Eryk-Mozdzen/uav-tvc-goose/docs/reports/SteRoP_3_TVCG_EM_2.pdf

Projekt

Sterowniki robotów

# I kamień milowy

# Sterownik lotu drona sterowanego wektorem ciągu „Goose”

# TVCG

## Skład grupy:

### Eryk Możdżeń, 259375

### Termin: wtTN19

### Prowadzący: dr inż. Wojciech Domski

### 27 marca 2023

## Spis treści

1 Zakres wykonanych prac | 2
2 Protokół komunikacyjny | 3
3 Komunikacja bezprzewodowa | 6
4 Komunikacja przewodowa | 8

## 1 Zakres wykonanych prac

Wszelkie prace prowadzone i dokumentowane były na repozytorium github[2].

- implementacja protokołu oraz funkcji kodujących i dekodujących
- definicja danych wysyłanych w wiadomościach
- integracja protokołu kominikacji do wcześniej istenijacej architektury
- konfiguracja UART z użyciem DMA
- stworzenie tasków odbierających i nadawających po UART
- implementacja biblioteki USB oraz tasków ją obsługujące

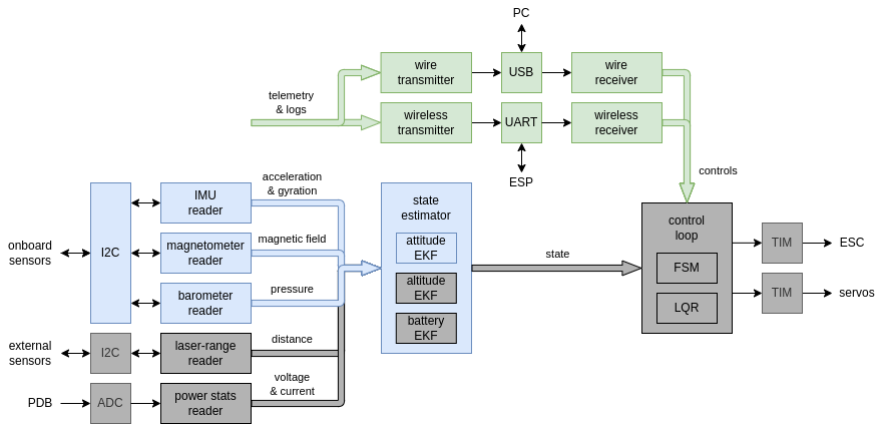
[picture p6: figure]

Rysunek 1: Schemat architektury programu, niebieski – wykonany przed oddaniem I etapu, zielony – elementy komunikacji wykonane w ramach I kamienia milowego, szary – planowane na następne kamienie milowe

## 2 Protokół komunikacyjny

Został zaimplementowany protokół komunikacyjny opisany w etapie I. Wykorzystuje on algorytmy takie jak COBS [3] oraz sumę konkrolną CRC8[4]. Niżej wypisano wszystkie ramki wiadomości, które będą używane do transmisji danych wraz z przydzielonym im identyfikatorami. Kod źródłowy klasy Transfer dzielony jest w programie mikrokontrolera oraz stacji pilota na komupterze PC.

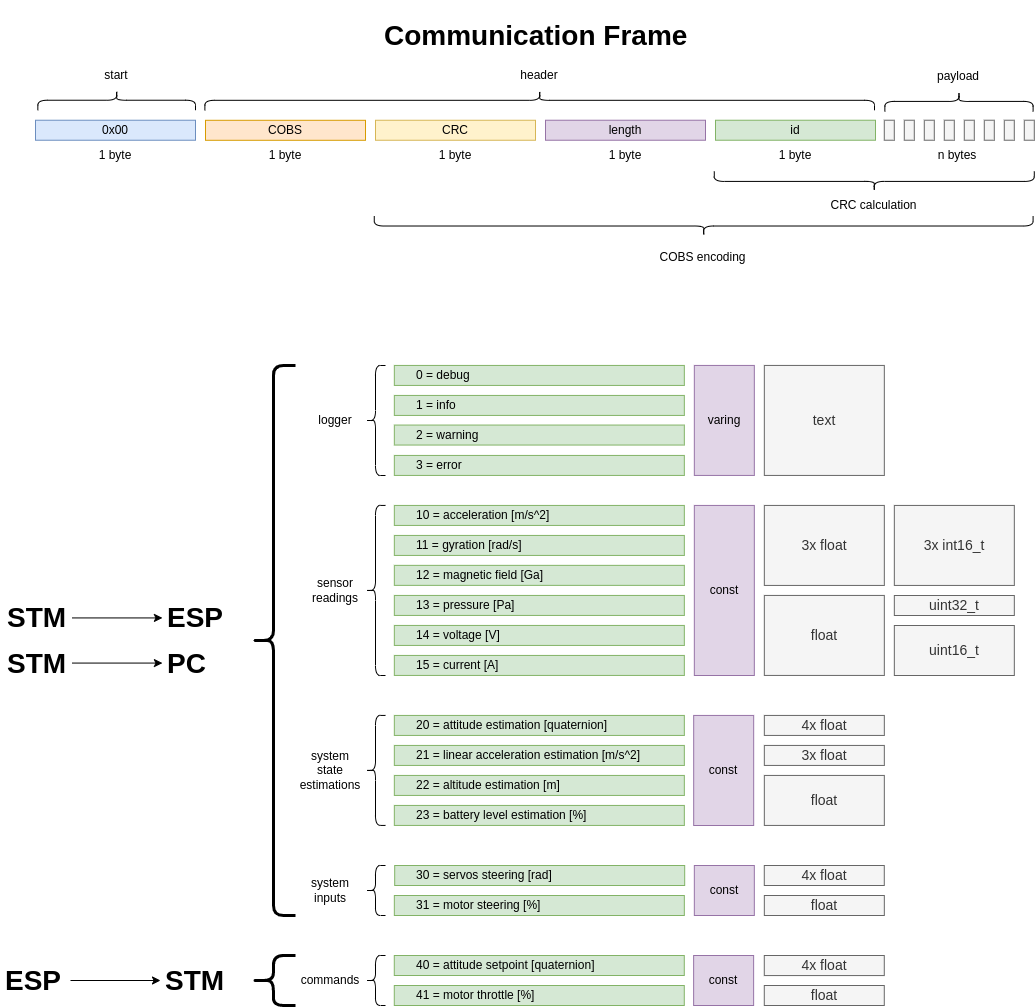
[picture p7: figure]

Rysunek 2: Ramka danych oraz definicje wiadomości wraz z identyfikatorami

### Kodowanie wiadomości

W pierwszej kolejności sprawdzany jest rozmiar wysyłanych danych. Zastosowano uproszczoną metodę kodowania COBS, która zawiera tylko jeden bit nadmiarowy. Ogranicza to długość jednej wiadomości do 255 bajtów, co odejmując narzut związany z obecnością nagłówka pozostawia 250 bajtów danych na treść wiadomości.
Po przekopiowaniu danych do bufora oraz uzupełnieniu pól identyfikatora oraz długości ładunku następuję obliczenie sumy kontrolnej na danych jak i id. Następnie suma kontrolna, długość, id oraz dane kodowane są przez COBS w celu usnięcia bajtów o wartości 0 z wiadomości. Na początku wpisywane jest 0.
1 | template<typename T>
2 | s t a t i c FrameTX encode ( co n s t T &payload , co n s t ID i d ) {
3 | s t a t i c _ a s s e r t ( s i z e o f (T)<=max_length , " payload too big to encode " ) ;
4
5 | FrameTX frame ;
6
7 | memcpy(& frame . b u f f e r [ 5 ] , &payload , s i z e o f (T) ) ;
8 | frame . b u f f e r [ 4 ] = i d ;
9 | frame . b u f f e r [ 3 ] = s i z e o f (T) ;
10 | frame . b u f f e r [ 2 ] = calculate_CRC(& frame . b u f f e r [ 4 ] , 1 + s i z e o f (T) ) ;
11 | frame . b u f f e r [ 1 ] = encode_COBS(& frame . b u f f e r [ 2 ] , 3 + s i z e o f (T) ) ;
12 | frame . b u f f e r [ 0 ] = s ta r t_ b y t e ;
13
14 | frame . l e n g t h = s i z e o f (T) + 5 ;
15
16 | r e t u r n frame ;
17 | }
| Listing 1: statyczna metoda kodująca w klasie Transfer

### Dekodowanie wiadomości

| W celu zdekodowania strumienia bajtów dochodzących do drona/wizalizacji wymagany jest
| obiekt klasy Transfer. Jej zadaniem jest akumulowanie kolejnych bajtów danych metodą con-
| sume() do czasu aż niezostanie zebrana pełna poprawna ramka danych.
1 | void T ra n s f e r : : consume ( co n s t uint8_t byte ) {
2 | i f ( co u n t e r==0 && byte != s ta r t_ b y t e ) {
3 | r e t u r n ;
4 | }
5
6 | i f ( coun te r >0 && byte==s ta r t_ b y t e ) {
7 | r e s e t ( ) ;
8 | }
9
10 | i f ( coun te r>=max_length+5) {
11 | r e s e t ( ) ;
12 | }
13
14 | f rame_bu f fe r [ co u n t e r ] = byte ;
15 | co u n t e r++;
16 | }
| Listing 2: metoda akumulująca klasy Transfer

Aby sprawdzić czy już zostały otrzymane wszystkie bajty tworzące ramkę należy wywołać metodę receive(). Sprawdza ona czy obecnie zakumulowane dane, które spełniają sumę kontrolną oraz oczekiwaną ilość danych.
Początkowo sprawdzane są warunki tego, że pierwszym bajtem jest bajt startu, oraz że oprócz nagłówka zostały odebrane jakiekolwiek dane. Następnie przekopiowanie danych i odwrócenie kolejności ich odkodowywania względem ich zakodowywania.
1 | bool T ra n s f e r : : r e c e i v e (FrameRX &frame ) co n s t {
2 | i f ( coun te r <5) {
3 | r e t u r n f a l s e ;
4 | }
5
6 | i f ( f rame_bu f fe r [ 0 ] ! = s ta r t_ b y t e ) {
7 | r e t u r n f a l s e ;
8 | }
9
10 | uint8_t copy [ max_length + 5 ] ;
11 | memcpy ( copy , f rame_bu f fe r , co u n t e r ) ;
12
13 co n s t uint8_t cob s = copy [ 1 ] ;
14
15 decode_COBS(&copy [ 2 ] , co u n t e r − 2 , cob s ) ; 16
17 | frame . l e n g t h = copy [ 3 ] ;
18 | co n s t si z e_ t l e ng t h_ r eal = co u n t e r − 5 ;
19
20 | i f ( frame . l e n g t h != l e ng t h_ r eal ) {
21 | r e t u r n f a l s e ;
22 | }
23
24 | co n s t uint8_t c r c = copy [ 2 ] ;
25 | co n s t uint8_t c r c_ r e al = calculate_CRC(&copy [ 4 ] , frame . l e n g t h + 1 ) ;
26
27 | i f ( c r c != c r c_ r e al ) {
28 | r e t u r n f a l s e ;
29 | }
30
31 frame . i d = s t a ti c _ c a s t <ID>(copy [ 4 ] ) ;
32
33 memcpy ( frame . payload , &copy [ 5 ] , frame . l e n g t h ) ; 34
35 | r e t u r n t r u e ;
36 | }
| Listing 3: metoda sprawdzająca klasy Transfer

## 3 Komunikacja bezprzewodowa

Główną drogą komunikacji docelowo będzie bezprzewodowa wymiana danych. W tym celu został użyty projekt BlackMagic–ESPIDF [1], z którego na potrzeby tego projektu wykorzystana będzie komunikacja po usłudze Telnet. Tak zaprogramowany mikrokontroler ESP8288 automatycznie łączy się na stałe zadaną siecią, i stanowi rolę pośrednika w wymianie Telnet – UART.
Do transmisji jak i odbioru danych używane jest DMA. Konfiguracja UART jest zgodna z opisaną w założeniach projektowych. Metody zostały napisane tak, aby task je wywołujacy przeszedłw tryb uśpienia podczas oczekiwania na zakończenie transmisji lub odczytu danych z użyciem notyfikacji z FreeRTOS. Całość kodu obsługująca UART została zamknięta w singletonie CommunicationBus, która została odpowiednio zabezpieczona przed dostępem z wielu tasków. Wielkość bufora została arbitralnie dobrana. Im większy zostanie dobrany bufor tym bardziej odciążany jest proceor, lecz tym żadziej reaguje na dane.
1 | void CommunicationBus : : w ri t e ( co n s t uint8_t ∗ s r c , co n s t uint32_t l e n ) {
2 | lock_tx . ta ke (portMAX_DELAY) ;
3
4 com_bus_task_tx = xTaskGetCurrentTaskHandle ( ) ;
5
6 HAL_UART_Transmit_DMA(&huart1 , s r c , l e n ) ;
7
8 | i f ( ! ulTa skNo ti fyTake Indexed ( 2 , pdTRUE, 100 ) ) {
9 | Logger : : g e t I n s t a n c e ( ) . l o g ( Logger : :ERROR, " cbus : tx timeou t " ) ;
10 | }
11
12 | lock_tx . gi v e ( ) ;
13 | }
14
15 | void CommunicationBus : : read ( uint8_t ∗ de s t , co n s t uint32_t l e n ) {
16 | lock_rx . ta ke (portMAX_DELAY) ;
17
18 com_bus_task_rx = xTaskGetCurrentTaskHandle ( ) ;
19
20 HAL_UART_Receive_DMA(&huart1 , de s t , l e n ) ;
21
22 ulTa skNo ti fyTake Indexed ( 3 , pdTRUE, portMAX_DELAY) ; 23
24 | lock_rx . gi v e ( ) ;
25 | }
| Listing 4: metody wysyłające i odbierające

1 | void HAL_UART_TxCpltCallback (UART_HandleTypeDef ∗ hua r t ) {
2 | i f ( huart−>I n s t a n c e==USART1) {
3 | BaseType_t xHigherPriorityTaskWoken = pdFALSE ;
4 | vTaskNoti fyGiveIndexedFromISR ( com_bus_task_tx , 2 , &
| xHigherPriorityTaskWoken ) ;
5 | portYIELD_FROM_ISR( xHigherPriorityTaskWoken ) ;
6 | }
7 | }
8
9 | void HAL_UART_RxCpltCallback (UART_HandleTypeDef ∗ hua r t ) {
10 | i f ( huart−>I n s t a n c e==USART1) {
11 | BaseType_t xHigherPriorityTaskWoken = pdFALSE ;
12 | vTaskNoti fyGiveIndexedFromISR ( com_bus_task_rx , 3 , &
| xHigherPriorityTaskWoken ) ;
13 | portYIELD_FROM_ISR( xHigherPriorityTaskWoken ) ;
14 | }
15 | }
| Listing 5: reakcja na przerwanie DMA
| Odbieranie danych przebiega w osobnym tasku, którego zadaniem jest oczekiwanie na dane
| do skutku. Po ich otrzymaniu następuję odkodowanie danych i wysłanie zdekodowanej ramki
| danych do kolejki. Został
1 | void Wi r el e s s R e c ei v e r : : ta s k ( ) {
2
3 T ra n s f e r t r a n s f e r ;
4
5 | uint8_t b u f f e r [ 8 ] ;
6 | T ra n s f e r : : FrameRX frame ;
7
8 | w hil e ( 1 ) {
9 | CommunicationBus : : g e t I n s t a n c e ( ) . read ( b u f f e r , s i z e o f ( b u f f e r ) ) ;
10
11 | f o r ( uint32_t i =0; i<s i z e o f ( b u f f e r ) ; i++) {
12 | t r a n s f e r . consume ( b u f f e r [ i ] ) ;
13
14 | i f ( t r a n s f e r . r e c e i v e ( frame ) ) {
15 | T ran spo r t : : g e t I n s t a n c e ( ) . frame_rx_queue . push ( frame , 0 ) ;
16 | }
17 | }
18 | }
19 | }
| Listing 6: task odbierający UART

Task wysyłajcy zajmuje się wyłacznie opróżnianiem kolejki wiadomości do wysłania oraz rozpoczynaniem i oczekiwaniem na koniec transmisji.

1 | void Wi r el e s s T ra n smi t t e r : : ta s k ( ) {
2 | wi r el e s s_ t r a n smi t t e r_ t a s k = getTaskHandle ( ) ;
3
4 | w hil e ( 1 ) {
5 | T ra n s f e r : : FrameTX tx ;
6 | T ran spo r t : : g e t I n s t a n c e ( ) . wi rele s s_ tx_queue . pop ( tx , portMAX_DELAY) ;
7
8 | CommunicationBus : : g e t I n s t a n c e ( ) . w ri t e ( tx . b u f f e r , tx . l e n g t h ) ;
9 | }
10 | }
| Listing 7: task wysyłajacy UART

## 4 Komunikacja przewodowa

| Do przewodowej komunikacji wykorzystany będzie USB w roli urządzenia CDC. Podobnie
| jak wcześniej taski próbujące wywołać/odczytać dane z USB powinny być uśpione do momentu
| zakończenia transmisji lub braku danych wejściowych. W tym celu zostały zmodyfikowane
| funkcje callback, które umożliwiają reakcje na wydarzenia.
1 | s t a t i c in t8_ t CDC_Receive_FS ( uint8_t ∗ Buf , uint32_t ∗Len ) {
2 | USBD_CDC_SetRxBuffer(&hUsbDeviceFS , &Buf [ 0 ] ) ;
3
4 BaseType_t xHigherPriorityTaskWoken = pdFALSE ;
5
6 | f o r ( i n t i =∗Len−1; i >=0; i −−) {
7 | T ran spo r t : : g e t I n s t a n c e ( ) . wire_rx_queue . push_ISR ( Buf [ i ] ,
| xHigherPriorityTaskWoken ) ;
8 | }
9
10 | USBD_CDC_ReceivePacket(&hUsbDeviceFS ) ;
11 | r e t u r n USBD_OK;
12 | }
13
14 | uint8_t CDC_Transmit_FS ( uint8_t ∗ Buf , uint16_t Len ) {
15 | uint8_t r e s u l t = USBD_OK;
16
17 | USBD_CDC_HandleTypeDef ∗hcdc = (USBD_CDC_HandleTypeDef∗) hUsbDeviceFS .
| pClassData ;
18 | i f ( hcdc−>TxState != 0 ) {
19 | r e t u r n USBD_BUSY;
20 | }
21 | USBD_CDC_SetTxBuffer(&hUsbDeviceFS , Buf , Len ) ;
22 | r e s u l t = USBD_CDC_TransmitPacket(&hUsbDeviceFS ) ;
23
24 | r e t u r n r e s u l t ;
25 | }
| Listing 8: reakcje na callbacki biblioteki USB CDC
| W tym wypadku odbiór danych polega na umieszczeniu danych w kolejce. Dla USB także
| stworzono dwa taski (odpowiednio odbierający i wysyłający) w sposób analogiczny do UART.

## Bibliografia

[1] Blackmagic Wireless SWD Debug probe hosted on esp-idf SDK (for ESP8266) with UART on Telnet port and HTTP using xterm.js. url: https://github.com/walmis/blackmagicespidf. (https://github.com/walmis/blackmagic-espidf)
[2] Eryk Możdżeń. UAV TVC Goose. url: https://github.com/Eryk-Mozdzen/uav-tvcgoose.git. (https://github.com/Eryk-Mozdzen/uav-tvc-goose.git)
[3] Wikipedia. Consistent Overhead Byte Stuffing. url: https://en.wikipedia.org/wiki/Consistent_Overhead_Byte_Stuffing. (https://en.wikipedia.org/wiki/Consistent_Overhead_Byte_Stuffing)
[4] Wikipedia. Cykliczny kod nadmiarowy. url: https://pl.wikipedia.org/wiki/Cykliczny_kod_nadmiarowy. (https://pl.wikipedia.org/wiki/Cykliczny_kod_nadmiarowy)
