Eryk-Mozdzen/uav-tvc-goose/docs/reports/SteRoP_3_TVCG_EM_3.pdf

Projekt

Sterowniki robotów

# Etap III

# Kamienie milowe II oraz III

# Sterownik lotu drona sterowanego wektorem ciągu „Goose”

# TVCG

### Skład grupy:

Eryk Możdżeń, 259375

Termin: wtTN19

Prowadzący:
dr inż. Wojciech Domski

6 czerwca 2023

## Spis treści

1 Zakres wykonanych prac | 2
2 Komunikacja | 3
3 Sensoryka i estymacja stanu | 5
4 Sterowanie | 9
5 Podsumowanie i wnioski | 14

## 1 Zakres wykonanych prac

Wszelkie prace prowadzone i dokumentowane były na repozytorium github[3]. Wykonano wszystkie zadania zdefiniowane w dokumencie „Etap I”. Podczas wykonywania projektu zdefiniowane zostały 3 kamienie milowe.

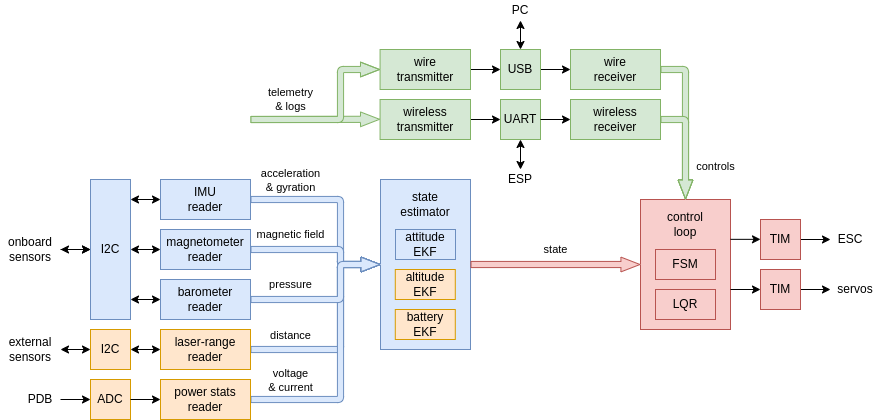
[picture p8: figure]

Rysunek 1: Schemat architektury programu, niebieski – wykonany przed oddaniem I etapu, zielony – elementy komunikacji (I kamień milowy), pomarańczowy – sensoryka i estymacja stanu (II kamień milowy), czerwony – maszyna stanów, regulator i urządzenia wykonawcze (III kamień milowy)

## 2 Komunikacja

### 2.1 Przesył danych z użyciem UART oraz ESP8266

Podstawową drogą komunikacji z dronem jest usługa Telnet. Dostęp do niej umożliwia zdalny serwer GDB oraz most UART–Telnet dostępny na mikrokontroler ESP8266 o nazwie blackmagic–espidf[1]. Peryferium UART na głównym mikrokontrolerze STM32F411 zostało skonfigurowane na ciągłe oczekiwanie na przychodzace dane. Odbiór danych z użyciem DMA sygnalizowany jest w przerwaniu wybudzeniem taska. Dedykowany task FreeRTOS odczytuje bajt po bajcie, a następnie formuje wiadomość.
Wysyłanie danych również oddbywa się z pomocą DMA. Dedytkwany task odbiera dane do wysyłki, koduje je, a następnie rozpoczyna transmisje. Przerwanie końca transmisji wybudza task i rozpoczyna następną transmisje. Przerwania zostały pokazane na 1.
1 | void HAL_UART_TxCpltCallback (UART_HandleTypeDef ∗ hua r t ) {
2 | i f ( huart−>I n s t a n c e==USART1) {
3 | BaseType_t xHigherPriorityTaskWoken = pdFALSE ;
4 | vTaskNoti fyGiveIndexedFromISR ( com_bus_task_tx , 2 , &
| xHigherPriorityTaskWoken ) ;
5 | portYIELD_FROM_ISR( xHigherPriorityTaskWoken ) ;
6 | }
7 | }
8
9 | void HAL_UART_RxCpltCallback (UART_HandleTypeDef ∗ hua r t ) {
10 | i f ( huart−>I n s t a n c e==USART1) {
11 | BaseType_t xHigherPriorityTaskWoken = pdFALSE ;
12 | vTaskNoti fyGiveIndexedFromISR ( com_bus_task_rx , 3 , &
| xHigherPriorityTaskWoken ) ;
13 | portYIELD_FROM_ISR( xHigherPriorityTaskWoken ) ;
14 | }
15 | }
| Listing 1: Przerwania UART – widoczne wybudzanie tasków

### 2.2 Przesył danych z użyciem USB

| W celu łatwiejszej pracy nad oprogramowaniem (oraz programowaniem) zostało wypro-
| wadzone złącze microUSB. Została zastosowana biblioteka ST Middleware USB [5]. Została
| zasotsowana klasa USB CDC, która tworzy wirutalny port COM. W celu sygnalizacji końca
| transmisji zostało zdefiniowane przerwanie wybudzające dedykowanego taska do wysyłki da-
| nych (analogicznie jak w UART). Przerwanie otrzymania danych pokazane jest na 3.
1 | s t a t i c in t8_ t CDC_TransmitCplt_FS ( uint8_t ∗Buf , uint32_t ∗Len , uint8_t
| epnum ) {
2 | ( void ) Buf ;
3 | ( void ) Len ;
4 | ( void ) epnum ;
5
6 vTaskNoti fyGiveIndexedFromISR ( wi re_ t ran smi t te r_ ta s k , 0 , NULL) ; 7
8 | r e t u r n USBD_OK;
9 | }
| Listing 2: przerwanie końca transmisji USB

Z bliżej nieustalonych powodów podczas obioru danych trzeba zmienić kolejność występownia bajtów w buforze (w UART nie ma takiej konieczności). Funkcja otrzymująca dane pokazana jest na 3.

1 | s t a t i c in t8_ t CDC_Receive_FS ( uint8_t ∗ Buf , uint32_t ∗Len ) {
2 | USBD_CDC_SetRxBuffer(&hUsbDeviceFS , &Buf [ 0 ] ) ;
3
4 BaseType_t xHigherPriorityTaskWoken = pdFALSE ;
5
6 | f o r ( i n t i =∗Len−1; i >=0; i −−) {
7 | T ran spo r t : : g e t I n s t a n c e ( ) . wire_rx_queue . push_ISR ( Buf [ i ] ,
| xHigherPriorityTaskWoken ) ;
8 | }
9
10 | USBD_CDC_ReceivePacket(&hUsbDeviceFS ) ;
11 | r e t u r n USBD_OK;
12 | }
| Listing 3: odiór danych oraz przekazanie bajtów do kolejki

## 3 Sensoryka i estymacja stanu

### 3.1 Pomiar odległości z użyciem czujnika VL53L0X

Czujnik VL53L0X jest cyfrowym czujnikiem odległości od firmy STMicroelectronics. Komunikacja przebiega z użyciem protokołu I2C oraz pinu sygnalizującego koniec pomiaru. Do obsługi czujnika została użyta biblioteka dostarczona od producenta [4].
Na początku działania programu czujnik zostaje zresetowany pinem XSHUT, a następnie skonfigurowany w tryb ciągłej konwersji. Parametry pomiaru zostały dobrane tak, aby zmaksymalizować zasięg do 2.2 m dla białej przeszkody. Konfiguracja pokazana jest na 4.
1 | HAL_GPIO_WritePin (GPIOC, GPIO_PIN_13, GPIO_PIN_RESET) ;
2 | vTaskDelay (20 ) ;
3 | HAL_GPIO_WritePin (GPIOC, GPIO_PIN_13, GPIO_PIN_SET) ;
4 | vTaskDelay (20 ) ;
5
6 VL53L0X_Error s t a t u s = VL53L0X_ERROR_NONE;
7
8 HAL_NVIC_DisableIRQ (EXTI15_10_IRQn ) ;
9
10 | VL53L0X_WaitDeviceBooted(& vl x_ sen so r ) ;
11 | i f ( s t a t u s==VL53L0X_ERROR_NONE) s t a t u s = VL53L0X_DataInit(& vl x_ sen so r ) ;
12 | i f ( s t a t u s==VL53L0X_ERROR_NONE) s t a t u s = VL53L0X_StaticInit (& vl x_ sen so r ) ;
13 | i f ( s t a t u s==VL53L0X_ERROR_NONE) s t a t u s = VL53L0X_Per formRe fCalibration(&
| vlx_ sen so r , &VhvSet tings , &PhaseCal ) ;
14 | i f ( s t a t u s==VL53L0X_ERROR_NONE) s t a t u s = VL53L0X_PerformRefSpadManagement(&
| vlx_ sen so r , &re fSpadCount , &i sA p e r t u r e S pa d s ) ;
15 | i f ( s t a t u s==VL53L0X_ERROR_NONE) s t a t u s = VL53L0X_SetDeviceMode(& vlx_ sen so r ,
| VL53L0X_DEVICEMODE_CONTINUOUS_RANGING) ;
16
17 | i f ( s t a t u s==VL53L0X_ERROR_NONE) s t a t u s = VL53L0X_SetLimitCheckEnable(&
| vlx_ sen so r , VL53L0X_CHECKENABLE_SIGMA_FINAL_RANGE, 1 ) ;
18 | i f ( s t a t u s==VL53L0X_ERROR_NONE) s t a t u s = VL53L0X_SetLimitCheckEnable(&
| vlx_ sen so r , VL53L0X_CHECKENABLE_SIGNAL_RATE_FINAL_RANGE, 1 ) ;
19 | i f ( s t a t u s==VL53L0X_ERROR_NONE) s t a t u s = VL53L0X_SetLimitCheckValue(&
| vlx_ sen so r , VL53L0X_CHECKENABLE_SIGNAL_RATE_FINAL_RANGE, (
| FixPoint1616_t ) ( 0. 1 ∗ 6 5 5 3 6 ) ) ;
20 | i f ( s t a t u s==VL53L0X_ERROR_NONE) s t a t u s = VL53L0X_SetLimitCheckValue(&
| vlx_ sen so r , VL53L0X_CHECKENABLE_SIGMA_FINAL_RANGE, ( FixPoint1616_t )
| (60∗65536 ) ) ;
21 | i f ( s t a t u s==VL53L0X_ERROR_NONE) s t a t u s =
| VL53L0X_SetMeasurementTimingBudgetMicroSeconds(& vlx_ sen so r , 33000 ) ;
22 | i f ( s t a t u s==VL53L0X_ERROR_NONE) s t a t u s = VL53L0X_SetVcselPulsePeriod(&
| vlx_ sen so r , VL53L0X_VCSEL_PERIOD_PRE_RANGE, 18 ) ;
23 | i f ( s t a t u s==VL53L0X_ERROR_NONE) s t a t u s = VL53L0X_SetVcselPulsePeriod(&
| vlx_ sen so r , VL53L0X_VCSEL_PERIOD_FINAL_RANGE, 14 ) ;
24
25 | i f ( s t a t u s==VL53L0X_ERROR_NONE) s t a t u s = VL53L0X_StartMeasurement(&
| vl x_ sen so r ) ;
26
27 | HAL_NVIC_EnableIRQ(EXTI15_10_IRQn ) ;
| Listing 4: konfiguracja VL53L0X

Przerwanie sygnalizujace gotowość danych do odczytu przedstawione jest w 5.

1 | void HAL_GPIO_EXTI_Callback ( uint16_t GPIO_Pin) {
2 | i f (GPIO_Pin==GPIO_PIN_15) {
3
4 | // IMU
5 | BaseType_t xHigherPriorityTaskWoken = pdFALSE ;
6 | vTaskNoti fyGiveIndexedFromISR ( imu_task , 1 , &xHigherPriorityTaskWoken ) ;
7 | portYIELD_FROM_ISR( xHigherPriorityTaskWoken ) ;
8
9 } e l s e i f (GPIO_Pin==GPIO_PIN_5) {
10
11 | // magnetometer
12 | BaseType_t xHigherPriorityTaskWoken = pdFALSE ;
13 | vTaskNoti fyGiveIndexedFromISR ( mag_task , 1 , &xHigherPriorityTaskWoken ) ;
14 | portYIELD_FROM_ISR( xHigherPriorityTaskWoken ) ;
15
16 } e l s e i f (GPIO_Pin==GPIO_PIN_14) {
17
18 | // di s t a n c e
19 | BaseType_t xHigherPriorityTaskWoken = pdFALSE ;
20 | vTaskNoti fyGiveIndexedFromISR ( vlx_task , 1 , &xHigherPriorityTaskWoken ) ;
21 | portYIELD_FROM_ISR( xHigherPriorityTaskWoken ) ;
22
23 | }
24 | }
| Listing 5: konfiguracja VL53L0X

### 3.2 Estymacja wysokości nad ziemią

| Do estymacji wysokości lotu został zastosowany filtr Kalmana sumujący odczyty akcele-
| rometru, estymacji orientacji oraz czujnika odległości zamiennie z barometrem. Wektor mie-
| rzonego przyśpieszenia liniowego zostaje obrócony zgodnie tak, aby współrzędne wektora były
| zdefiniowane we współrzędnych świata. Od osi z odejmowana jest wartość przyśpieszenia grawi-
| tacyjnego g = 9.81m s . Dzięki temu uzyskiwane jest przyśpieszenie liniowe w pionie az. Równania
| zostały wyrażone jako 2.

xk = Axk−1 + Buk−1
yk = Cxk−1
zˆk

vˆzk
=
1 ∆t

0 1
·
zˆk
vˆzk
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
vˆzk
(2)

Częstotliwość pomiaru przyśpieszenie to 200 Hz, więc ∆t = 5ms. Dzięki temu estymowana jest także prędkość w pionie wymagana do realizacji sterowania.

W przypdku braku danych z czujnika odległości (wylot po za zakres) jako wejście filtru podawane jest wartość ciśnienia atmosferycznego. W tym celu użyty jest wzór 3.

h = 44330 ·

1 −

p
p0

0.1903!
(3)

### 3.3 Pomiar napięcia baterii oraz pobieranego prądu

Pomiar napięcia oraz natężenia prądu płynącego z baterii został zrealizowany za pomocą przetwornika ADC w parze z DMA. Przetwornik został skonfigurowany tak, aby pomiar był ciągły. Dedykowany task w stałych interwałach czasowych odczytuje dane z bufora oraz wysyłający je do kolejki mierzonych danych. Pomiar napięcia realizowany jest z użyciem dzielnika napięcia. Filtracja i zabezpieczenie kanałów zostało zaprezentowane na 3.
Pomiar prądu realizowany jest poprzez użycie wzmacniacza operacyjnego wzmacniającego spadek napięcia na rezystorze pomiarowym tak jak przedstawiono na rysunku 2.

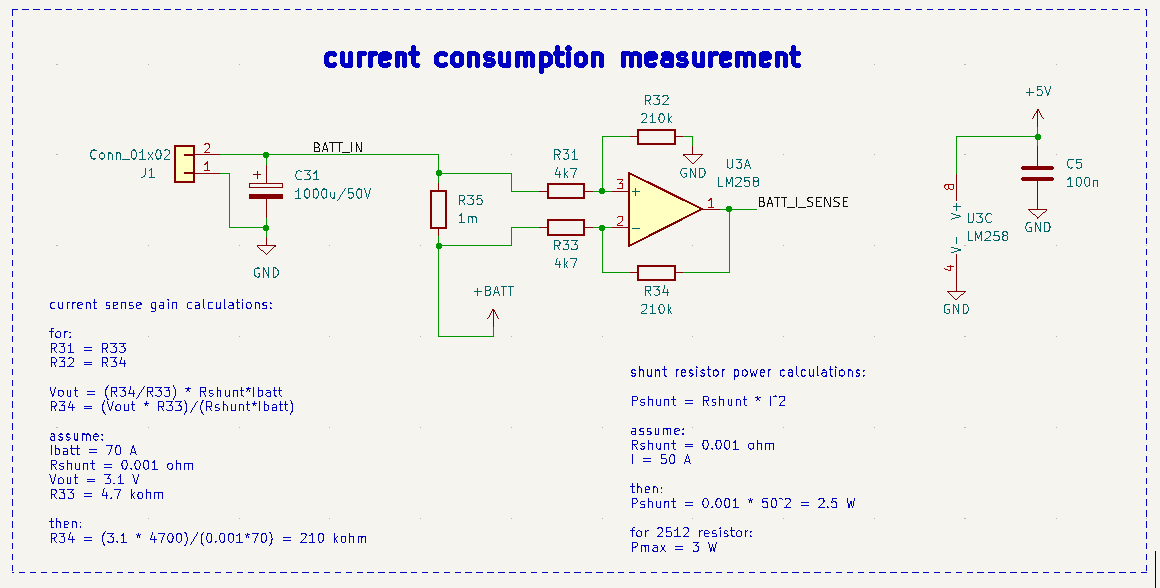
[picture p9: figure]

Rysunek 2: Schemat układu mierzącego prąd

Początkowo nie zostało sprawdzone czy wzmacniacz jest typu „rail to tail”. Okazało się, że napięcie wyjściowe ograniczone jest od dołu napięciem 0.7 V co powoduje brak możliwości pomiaru małych prądów (poniżej 10 A). Niedopatrzenie to skutecznie utrudniło implementacje estymatora oraz uniemożliwiło jego skuteczne przetestowanie i dostrojenie.

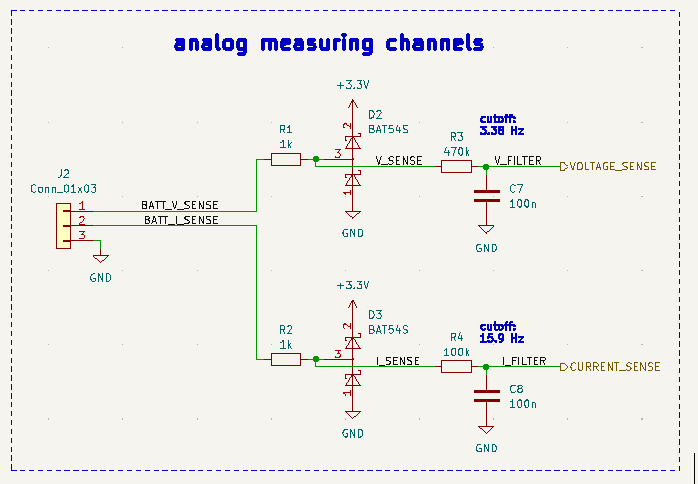
[picture p10: figure]

Rysunek 3: Kanały pomiarowe przetwornika ADC, zabezpieczenia i filtry

### 3.4 Estymacja poziomu naładowania baterii

Na podstawie pracy [6] zostały wyprowadzone równanie stanu modelu baterii w postaci 5.

SOCˆ

k = SOCˆ
k−1 −

1
C
- I | (4)
V = V (SOCk) | (5)

W celu wyznaczenia funkcji odwrotnej zostały użyte stablicowane punkty w pracy [6]. Niestety po uproszczeniu modelu wyłącznie do minimum oraz wpisaniu rzeczywistych parametrów baterii wartości zwracane przez estymator nie mają odzwierciedlenia w rzeczywistości. Spowodowane jest to nieprawidłowym pomiarem prądu, którego nie było możliwe wymuszenie sztuczne jak i testowe (silnik bez śmigła pobiera maksymalnie 1 A, zasilacze laboratoryjne i sztuczne obciążenia generują mniej mocy).

## 4 Sterowanie

### 4.1 Abstrakcyjna maszyna stanów

Na potrzeby projektu zostało stworzone osobne repozytorium git [2], które zostało dodane jako submodule do głównego repozytorium. Głównymi założeniami projektowymi biblioteki były:

- interfejs wspierający podejście obiektowe
- tranzycje generowane przez zdarzenia
- logika ukryta przed kodem użytkownika
- użycie wyłącznie statycznie alokowanej pamięci
- brak użycia biblioteki STL

Powyższe założenia zostały spełnione poprzez poniższe klasy pokazane w 8 6 oraz 7. Klasa „Event” służąca jako baza dla klas użytkownika służy do generacji tranzycji. Podczas konfigurowania głównej klasy „StateMachine” definiuje się jakie zdarzenia mają generować przejścia pomiędzy poszczególnymi klasami.

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

Klasa „State” jest bazą wszystkich stanów definiowanych przez użytkownika. Odpowiednie nadpisania metod dają możliwość wykonywania akcji na początku, w trakcie jak i przy opuszczaniu stanu.

1 | c l a s s S ta t e {
2 | v i r t u a l void e n t e r ( ) {}
3 | v i r t u a l void e x e c u t e ( ) {}
4 | v i r t u a l void e x i t ( ) {}
5
6 | templa te <i n t S , i n t E>
7 | f r i e n d c l a s s StateMachine ;
8 | } ;
| Listing 7: klasa stanu
| Informacje na temat połączeń w grafie przejść oraz ich obsługa zawarte są w klasie „State-
| Machine”. Wywołuje ona odpowiednie metody stanów oraz dba o zmianę stanów.
1 | template<i n t S , i n t E>
2 | c l a s s StateMachine {
3 | s t r u c t S t a t e T r a n si ti o n ;
4
5 | s t r u c t T r a n si ti o n {
6 | Event ∗ e ven t ;
7 | S t a t e T r a n si ti o n ∗ next ;
8 | } ;
9
10 | s t r u c t S t a t e T r a n si ti o n {
11 | S ta t e ∗ s t a t e ;
12 | T r a n si ti o n t r a n s i t i o n s [E ] ;
13 | } ;
14
15 | S t a t e T r a n si ti o n s t a t e s [ S ] ;
16 | S t a t e T r a n si ti o n ∗ c u r r e n t ;
17
18 | void c l e a r ( ) ;
19
20 | p u bli c :
21 | StateMachine ( S ta t e ∗ s t ) ;
22 | void t r a n s i t ( S ta t e ∗from , S ta t e ∗ to , Event ∗ e ven t ) ;
23 | void s t a r t ( ) ;
24 | void update ( ) ;
25 | } ;
| Listing 8: klasa maszyny stanów

### 4.2 Regulator LQR

W celu realizacja zaproponowanego sterowania w postaci regulatora LQR została wyodrębniona osobna klasa (singleton). Dzięki rozbudowanemu zapleczu matematycznemu w postaci klasy „Matrix” impelmentacja była trywialna, tak jak widać w 9 i 10. Widać macierz przekopiowaną z symulacji w programie Simulink.

1 | c l a s s C o n t r o l l e r {
2 | s t a t i c co n s t e x p r i n t X_NUM = 8 ;
3 | s t a t i c co n s t e x p r i n t U_NUM = 5 ;
4
5 | s t a t i c co n s t e x p r Matrix<U_NUM, 1> o p e ra ti ng_ poi n t = {
6 | 0.2527 f ,
7 | 0.2527 f ,
8 | 0.2527 f ,
9 | 0.2527 f ,
10 | 0.2229 f
11 | } ;
12
13 | s t a t i c co n s t e x p r Matrix<U_NUM, X_NUM> K = {
14 | 1.4397 f , | 1.7109 f , | −0.0000 f , | −0.0000 f , | 1.2727 f ,
−0.4991 f , | 0.0305 f , | 0.0479 f ,
15 | 1.7109 f , | −1.4397 f , | −0.0000 f , | 1.2727 f , | −0.0000 f ,
−0.4991 f , | 0.0305 f , | 0.0479 f ,
16 | −1.4397 f , | −1.7109 f , | −0.0000 f , | 0.0000 f , | −1.2727 f ,
| −0.4991 f , | 0.0305 f , | 0.0479 f ,
17 | −1.7109 f , | 1.4397 f , | −0.0000 f , | −1.2727 f , | 0.0000 f ,
| −0.4991 f , | 0.0305 f , | 0.0479 f ,
18 | 0.0000 f , | −0.0000 f , | 0.0000 f , | 0.0000 f , | −0.0000 f ,
| 0.0061 f , | 0.0998 f , | 0.1106 f
19 | } ;
20
21 | Matrix<X_NUM, 1> s e t p o i n t ;
22 | Matrix<X_NUM, 1> p ro c e s s_ val u e ;
23
24 | C o n t r o l l e r ( ) ;
25
26 | p u bli c :
27 | C o n t r o l l e r ( C o n t r o l l e r &) = d e l e t e ;
28 | void o p e r a t o r=( co n s t C o n t r o l l e r &) = d e l e t e ;
29
30 | void s e t S e t p o i n t ( co n s t Matrix<X_NUM, 1> sp ) ;
31 | void s e tP ro c e s sVal u e ( co n s t Matrix<X_NUM, 1> pv ) ;
32 | Matrix<U_NUM, 1> c a l c u l a t e ( ) co n s t ;
33
34 | Matrix<X_NUM, 1> g e t S e t p oi n t ( ) co n s t ;
35 | Matrix<X_NUM, 1> g e tP ro c e s sVal u e ( ) co n s t ;
36
37 | s t a t i c C o n t r o l l e r& g e t I n s t a n c e ( ) ;
38 | } ;
Listing 9: klasa regulatora

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

### 4.3 Sterowanie serwomechanizmami oraz ESC

| Do sterowania serwomechanizamami oraz steronikiem silnika BLDC zostały użyte dwa
| układy czasowo-licznikowe w trybie generacji sygnału PWM. Każdy z pięciu sygnałów posiada
| częstotliwość 50 Hz.
| Zastosowane serwa to popularne SG90. Ich charakterystyczną cechą jest praca w niestan-
| dardych przedziałach wpełnienia (500 us do 2400 us).
| Sterowanie w zakmniętej pętli przebiega z częstotliwością 100 Hz.

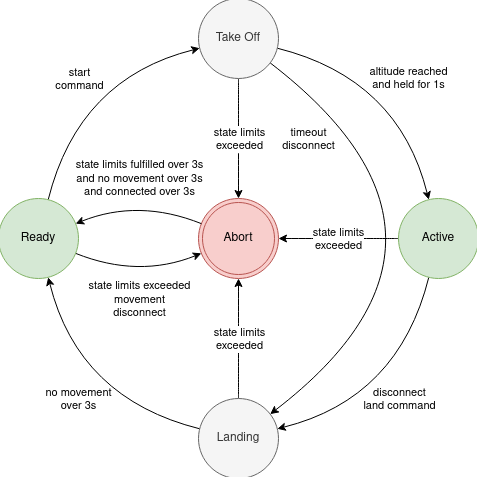
[picture p11: figure]

Rysunek 4: Zaimplementowany schemat stanów i przejść

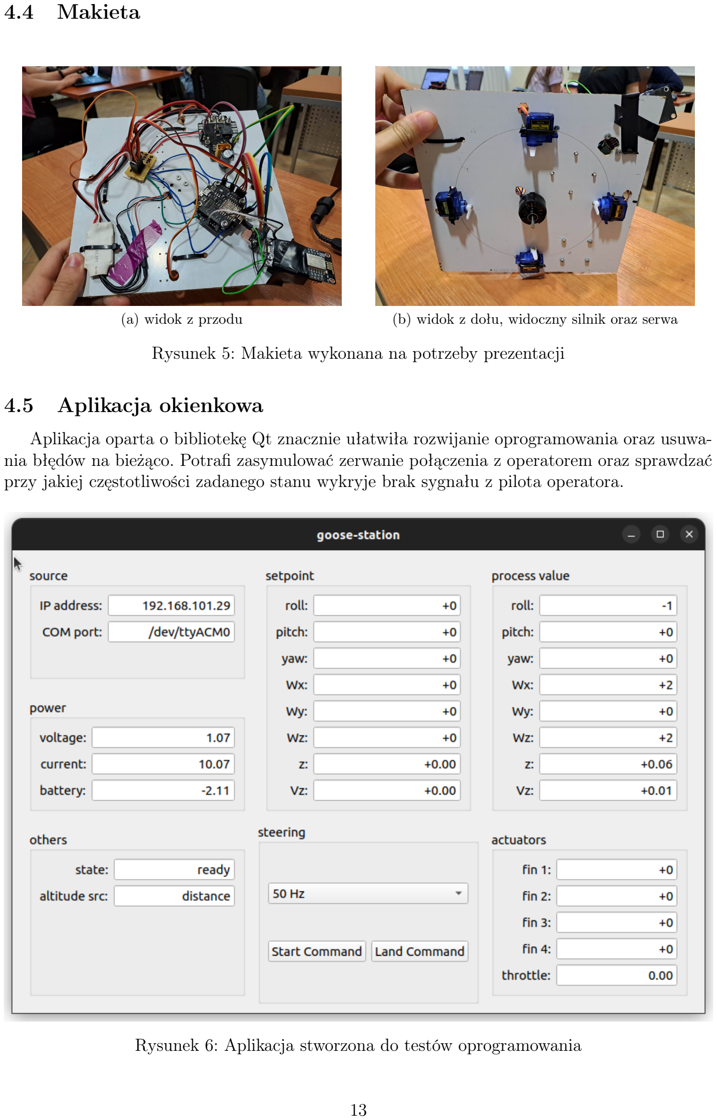
[picture p12: page 14]

### 4.4 Makieta

(a) widok z przodu | (b) widok z dołu, widoczny silnik oraz serwa

Rysunek 5: Makieta wykonana na potrzeby prezentacji

### 4.5 Aplikacja okienkowa

Aplikacja oparta o bibliotekę Qt znacznie ułatwiła rozwijanie oprogramowania oraz usuwania błędów na bieżąco. Potrafi zasymulować zerwanie połączenia z operatorem oraz sprawdzać przy jakiej częstotliwości zadanego stanu wykryje brak sygnału z pilota operatora.

Rysunek 6: Aplikacja stworzona do testów oprogramowania

## 5 Podsumowanie i wnioski

Projekt sterownika lotu jednowirnikowego drona sterowanego wektorem ciągu był wyzwaniem. Udało wypełnić się teoretycznie wszystkie założenia początkowe, lecz niektóre aspekty (takie jak estymacja poziomu baterii) wymagają dopracowania.
Elementem na którym należało poświęcić najwięcej czasu był estymator stanu oraz testy jego poprawnej pracy. Niekiedy problematyczne były błędy hardwareowe, które uniemożlwiały dalszy rozwój programu.

## Bibliografia

[1] Blackmagic Wireless SWD Debug probe hosted on esp-idf SDK (for ESP8266) with UART on Telnet port and HTTP using xterm.js. url: https://github.com/walmis/blackmagicespidf. (https://github.com/walmis/blackmagic-espidf)
[2] Eryk Możdżeń. Simple finite state machine implementation for various C++ projects. url: https://github.com/Eryk-Mozdzen/state-machine-cpp.
[3] Eryk Możdżeń. UAV TVC Goose. url: https://github.com/Eryk-Mozdzen/uav-tvcgoose.git. (https://github.com/Eryk-Mozdzen/uav-tvc-goose.git)
[4] STMicroelectronics. DS11555 VL53L0X Time-of-Flight ranging sensor. 2022. url: https: //www.st.com/en/imaging-and-photonics-solutions/vl53l0x.html#documentation.
[5] STMicroelectronics. Provides the USB Device library part of the STM32Cube MCU Component "middleware"for all STM32xx series. url: https://github.com/STMicroelectronics/stm32_mw_usb_device. (https://github.com/STMicroelectronics/stm32_mw_usb_device)
[6] Ying Zhang. A Battery SOC Estimation Method Based on AFFRLS-EKF. 2021. url: https://www.researchgate.net/publication/354119837_A_Battery_SOC_Estimation_Method_Based_on_AFFRLS-EKF. (https://www.researchgate.net/publication/354119837_A_Battery_SOC_Estimation_Method_Based_on_AFFRLS-EKF)
