Eryk-Mozdzen/uav-tvc-goose/docs/reports/RM_etap2_wstepne_rezultaty.pdf

Projekt

Roboty Mobilne 1

## Symulacja bezzałogowego statku powietrznego w

## środowisku Simulink – sprawozdanie z przeprowadzonych prac

Eryk Możdżeń, 259375

Prowadzący:
dr inż. Michał Błędowski

Katedra Teorii Pola, Układów Elektronicznych i Optoelektroniki Wydziału Elektroniki, Fotoniki i Mikrosystemów
Politechniki Wrocławskiej

8 maja 2023

## 1 Modelowanie

### 1.1 Siły zewnętrzne

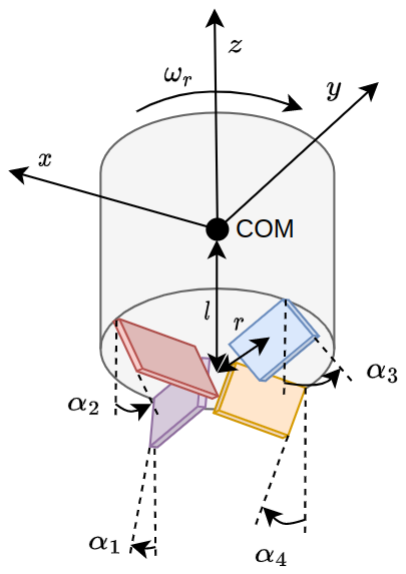
[picture p13: figure]

Rysunek 1: Poglądowy schemat budowy obiektu i zaznaczenie dodatnich kierunków łopatek i wirnika

Siłą unoszącą obiekt nad ziemią jest siła ciągu generowana przez wirnik. Tak jak w opisie
[2] (wzór 3.9) siła ciągu jest proporcjonalna do kwadratu prędkości obrotowej wirnika ωr. Stałą proporcjonalności jest Kt

[Ns²
], która mieści w
sobie takie czynniki jak napięcie zasilania, właściwości silnika, właściwości śmigła.

Ft = Ktω

2
r
Sterowanie wektorem ciągu realizowane jest poprzez sterownie wychyleniem czterech łopatek usytuowanych tak, aby przekierowywały frag-ment strumienia powietrza generowanego przez wirnik w bok. Skutkiem tego jest wytworzenie się sił działających prostopadle oraz równolegle do kierunku działania siły ciągu. Siły działające w bok F1, F2, F3, i F4 dla małych kątów można wyrazić jako proporcjonalne do sinusa kąta wychylenia łopatek. Siłę oporu areodynamicznego łopatki Fd można przybliżyć do stałej niezależ-nej od wychylenia łopatki.

Fn = ClFt sin αn
Fd = CdFt

### 1.2 Ruch oborotwy

Opis dynamiki obiektu został podzielony na rotacje i translacje poprzez analizę momentów i sił działających na system. Do opisu rotacji wymagana jest macierzy bezwładności obiektu J, która może zostać obliczona na podstawie modelu 3D w programie CAD. Przyjęto założenie, że znaczące będą tylko elementy na głównej przekątnej Jxx, Jyy oraz Jzz. W celu opisania efektu żyroskopowego, należy znaleźć także moment bezwładności rotora w osi z Jr będący częścią J.

J ≈

Jxx | 0 | 0
0 | Jyy | 0
0 | 0 | Jzz

- Jwirnik ≈

0 0 0
0 0 0
0 0 Jr

W roli opisu rotacji η zostały użyte kąty RPY w postaci wektora [ϕ, θ, ψ]

T
. Prędkości kątowe ω
zostały wyrażone w układzie ciała. Do wyznaczenia pochodnej po czasie kątów RPY została użyta macierz Wη.

ω = Wη · η˙ η˙ = W⁻¹
η
- ω

Wη =

1 | 0 | −sθ
0 | cθ | cθsϕ
0 −cθ | cθcϕ
- W⁻¹
η =
1 tθsϕ | tθcϕ
0 | cϕ | −sϕ
sϕ
cθ

cϕ
cθ

Przyśpieszenia kątowe w układzie ciała ω˙ definiowane są przez momenty obrotowe działające na układ. Równania oparto na równaniu Newtona-Eulera. Składnikiem o największym znaczeniu jest suma momentów pochodzących z sił generowanych przez lotki (siła × ramię). Stałe l oraz r to odległości środków łopatek odpowiednio w pionie oraz poziomie. Do osi x i y zostały dodane składniki reprezentujące efekt żyroskopowy, tak jak w pracy [1] (równanie 6). Proporcjonalnie do bezwładności rotora rośnie powiązanie między prędkościami i przyśpieszeniami w osiach x i y na krzyż. Do osi z zostały dodane dwa składniki: jeden odpowiada za moment obrotowy, który wirnik wywiera na resztę drona podczas pracy (zmusza go do kręcenia się wokół własnej osi). Drugi natomiast to reakcja układu na nagłe zwiększenie prędkości obrotowej wirnika (nagłe skręcenie przy podaniu skoku na przepustnicę). Z wyżej wymienionych własności został utworzony model rotacji bezzałogowego statku powietrznego 1.

ϕ˙ = ωx + ωysϕtθ + ωzcϕtθ

˙θ = ωycϕ − ωzsϕ

ψ˙ = ωy

sϕ
cθ

+ ωz

cϕ
cθ
ω˙ x =

1

Jxx

(Jyy − Jzz)wywz +

1

Jxx

l(F2 − F4) | + Jr Jxx ωrωy

ω˙ y =

1

Jyy

(Jzz − Jxx)wxwz +

1

Jyy

l(F1 − F3) | − Jr Jyy ωrωx

ω˙ z =

1

Jzz

(Jxx − Jyy)wxwy −

1

Jzz

r(F1 + F2 + F3 + F4) | + Cτ Jzz
Ft +

Jr

Jzz

ω˙ r

(1)

### 1.3 Ruch postępowy

Do przejścia pomiędzy układami ciała i przestrzeni używana jest macierz rotacji Rw
b

. Istnieją trzy
źródła przyśpieszeń ciała – grawitacja skierowana w dół (odpowiednio obrócony wektor o długości g), siły generowane przez łopatki oraz siła ciągu pomniejszona o opór areodynamiczny lotek. Równanie 2 przedstawia model opisujący poruszanie się środka masy bezzałogowca.

p˙ = R

w
b

v

R

w
b = rot(z, ψ) · rot(y, θ) · rot(x, ϕ)

x˙ = | vxcθcψ | +vy(sϕsθcψ − cϕsψ) +vz(cϕsθcψ + sϕsψ)
y˙ = | vxcθsψ | +vy(sϕsθsψ + cϕcψ) +vz(cϕsθsψ − sϕcψ)
z˙ = −vxsθ | +vysϕcθ | +vzcϕcθ

v˙x =

1
m

(−F1 + F3) +gsθ

v˙y =

1
m

(−F2 + F4) −gcθsϕ

v˙z =

1
m

(Ft − Fd) −gcθcϕ

(2)

### 1.4 Punkty równowagi

W celu znalezienia stabilnych punktów równowagi przedstawionego obiektu należy przyrównać wszystkie pochodne elementów wektora stanu do zera tak jak przedstawiono poniżej.

ϕ˙ =0 = ωx + ωysϕtθ + ωzcϕtθ

˙θ =0 = ωycϕ − ωzsϕ

ψ˙ =0 = ωy

sϕ
cθ

+ ωz

cϕ
cθ

→ θ ̸=

π
2

∧ θ ̸=

3π
2

Podstawiając pod drugą linię:

ωysϕ = ωzcϕ
ωy = 0
ωz = 0 | ∨ | ϕ =

π
4

Podstawiając pod trzecią linię:

ωy

sϕ
cθ
| = −ωz | cϕ
| | cθ
ωysϕ = −ωzcϕ
ωy = 0
ωz = 0 | ∨ | ϕ =

3π
4

Warunki na ϕ się wykluczają więc wniosek:
| ωy = 0
| ωz = 0

Podstawiając pod pierwszą linię:

0 = ωx + 0 · sϕtθ + 0 · ctθ 0 = ωx

Podstawiając ωx, ωy, ωz pod równania przyśpieszeń kątowych:

0 =

1

Jxx

(Jyy − Jzz) · 0 · 0 +

1

Jxx

l(F2 − F4) + Jr

Jxx

ωr · 0

0 =

1

Jyy

(Jzz − Jxx) · 0 · 0 +

1

Jyy

l(F1 − F3) −

Jr

Jyy

ωr · 0

0 =

1

Jzz

(Jxx − Jyy) · 0 · 0 −

1

Jzz

r(F1 + F2 + F3 + F4) + Cτ

Jzz

Ft +

Jr

Jzz

ω˙ r

0 =

1

Jxx

l(F2 − F4) → F2 = F4

0 =

1

Jyy

l(F1 − F3) → F1 = F3

0 =

1

Jzz

r(F1 + F2 + F3 + F4) + Cτ

Jzz

Ft +

Jr

Jzz

ω˙ r

Podstawiając siły F1, F2, F3, F4 pod równania przyśpieszeń liniowych:

v˙x =0 =

1
m
- 0 | +gsθ → θ = 0 ∨ θ = π

v˙y =0 =

1
m
- 0 | −gcθsϕ

v˙z =0 =

1
m

(Ft − Fd) −gcθcϕ

Rozpatrując drugie równanie:

0 = −gcθsϕ
0 = cθsϕ
cθ = 0 | ∨ | sϕ = 0
θ =

π
2

∨ θ =

3π
2

| | {z | }
nie spełnia warunku z początku

∨ (ϕ = 0 ∨ ϕ = π)

W ten sposób uzyskujemy następujące możliwości:
(
ϕ = 0
θ = 0

∨

(
ϕ = π
θ = 0

∨

(
ϕ = 0
θ = π

∨

(
ϕ = π
θ = π

Rozpatrując trzecie równanie:

0 =

1
m

(Ft − Fd) − gcθcϕ

Ft − Fd = mgcθcϕ
0 < mgcθcϕ
0 < cθcϕ

Co odrzuca środkowe możliwości, zostają:
(
ϕ = 0
θ = 0

∨

(
ϕ = π
θ = π

Podstawiając sϕ = 0, sθ = 0, cθcϕ = 1 pod równania prędkości liniowych:

x˙ =0 = | vxcθcψ | +vy(0 · 0 · cψ − cϕsψ) +vz(cϕ · 0 · cψ + 0 · sψ)
y˙ =0 = | vxcθsψ | +vy(0 · 0 · sψ + cϕcψ) +vz(cϕ · 0 · sψ − 0 · cψ)
z˙ =0 = −vx · 0 | +vy · 0 · cθ | +vz · 1

Wynika z tego, że vz = 0. Podstawiając oba przypadki (w praktyce takie same):
(
0 = vxcψ − vysψ
0 = vxsψ + vycψ

∨

(
0 = −vxcψ + vysψ
0 = −vxsψ − vycψ
(
0 = vxcψ − vysψ
0 = vxsψ + vycψ

Wszystkie rozwiązania równania vxcψ = vysψ:
(
vx = 0
vy = 0

∨

(
vx = 0
ψ = 0

∨

(
vx = 0
ψ = π

∨

(
vy = 0

ψ =

π
2

∨

vy = 0

ψ =

3π
2
Wszystkie rozwiązania równania vxsψ = −vycψ:
(
vx = 0
vy = 0

∨

(
vx = 0

ψ =

π
2

∨

vx = 0

ψ =

3π
2

∨

(
vy = 0
ψ = 0

∨

(
vy = 0
ψ = π

Jedyną częścią wspólną jest warunek: vx = 0 ∧ vy = 0. Podsumowując znaleziono dwa punkty stabilności, które po prostej analizie można uznać za ten sam. Obrót w osi Y i X o 180 ◦
jest rów-noznaczny z obrotem w osi Z o 180 ◦
, a jeżeli położenie kątowe w z jest dowolne oznacza to, że oba opisy przedstawiają jeden przypadek.

ϕ = 0
θ = 0
ψ ∈ R
ωx = 0
ωy = 0
ωz = 0
x ∈ R
y ∈ R
z ∈ R
vx = 0
vy = 0
vz = 0

ϕ = π
θ = π
ψ ∈ R
ωx = 0
ωy = 0
ωz = 0
x ∈ R
y ∈ R
z ∈ R
vx = 0
vy = 0
vz = 0

(3)

Aby taki punkt stabilności mógł się utrzymać, wejścia układu muszą spełniać warunki:

1
m

(Ft − Fd) = gcθcϕ

Ft − CdFt = mg · 1 · 1

Ktω

2
r0 =

mg
1 − Cd

ωr0 =

r mg
Kt(1 − Cd)

F1 = F3 → sα10 = sα30
F2 = F4 → sα20 = sα40
r(F1 + F2 + F3 + F4) = CτFt

(sα10 + sα20 + sα30 + sα40 )ClFt =

Cτ
r

Ft

αn0 = arcsin

Cτ
4rCl

(4)

### 1.5 Model liniowy

W celu znalezienia liniowego regulatora dla opisanego układu należy zlinearyzować równania dynamiki 1 2 tak, aby dobrze opisywały układ w punkcie pracy i jego okolicach. Punktem pracy będzie znaleziony wcześniej punkt stabilności 3. Należy sprowadzć opsi systemu z postaci:

x˙ = f(x, u)

Do postaci:

x˙ = Ax + Bu

Rozpatrywanym wektorem stanu x będzie pełny opis rotacji oraz położenie i prędkość w osi Z. Wektorem sterowań jest zbiór wychyleń łopatek oraz prędkości obrotowej rotora.

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
Na podstawie równań 3 oraz 4 wiemy, że punkt pracy będą stanowić:

x0 = 08×1 | u0 =

arcsin Cτ
4rCl
arcsin Cτ
4rCl
arcsin Cτ
4rCl
arcsin Cτ
q

4rCl

mg
Kt(1−Cd)

W celu zlinearyzowania układu należy obliczyć pochodne cząstkowe po x oraz u w punkcie x0, u0:

A =

∂f(x, u)
∂x
x0,u0

B =

∂f(x, u)
∂u
x0,u0

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

## 2 Symulacja

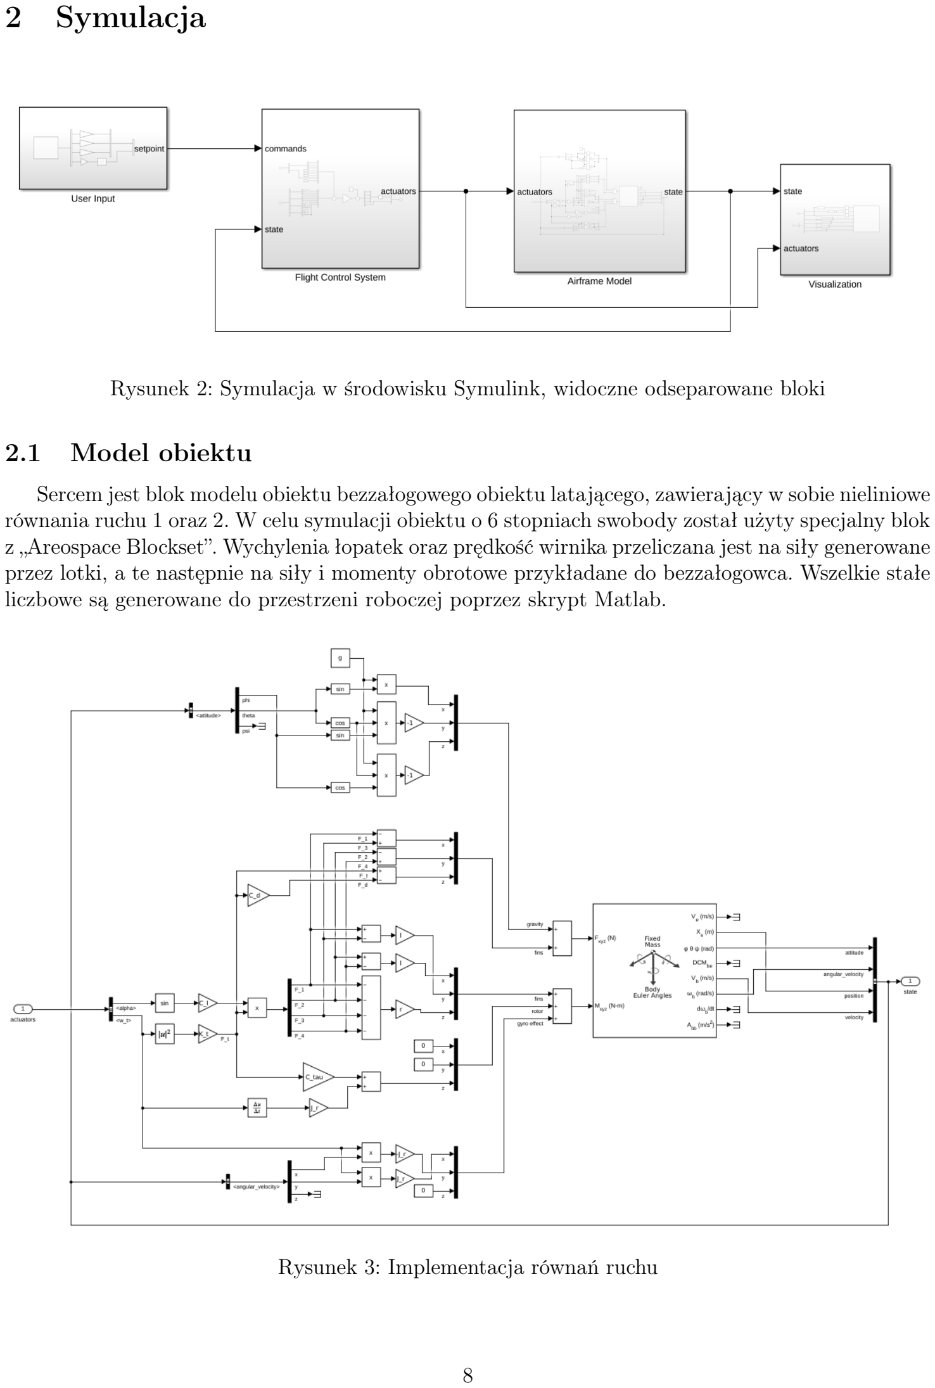
[picture p14: page 9]

Rysunek 2: Symulacja w środowisku Symulink, widoczne odseparowane bloki

### 2.1 Model obiektu

Sercem jest blok modelu obiektu bezzałogowego obiektu latającego, zawierający w sobie nieliniowe równania ruchu 1 oraz 2. W celu symulacji obiektu o 6 stopniach swobody został użyty specjalny blok z „Areospace Blockset”. Wychylenia łopatek oraz prędkość wirnika przeliczana jest na siły generowane przez lotki, a te następnie na siły i momenty obrotowe przykładane do bezzałogowca. Wszelkie stałe liczbowe są generowane do przestrzeni roboczej poprzez skrypt Matlab.

Rysunek 3: Implementacja równań ruchu

### 2.2 Odczyt z kontrolera do gier

Jako wejście użytkownika do symulacji zostały zastosowane wyjścia analogowe popularne kontrolera PS3/XBox360 połączonego do komuptera za pomocą USB. Do jego odczytu używany jest blok „Joystik Input” z „Symulink 3D Animation”. Lewa gałka odpowiada za wartości ϕ oraz θ, natomiast prawa za ψ i z.

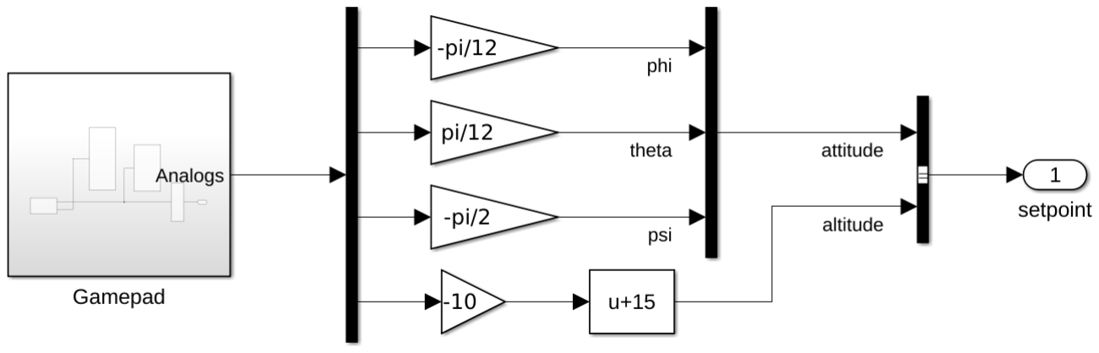
[picture p15: figure]

Rysunek 4: Kontrola zachowania drona w symulacji za pomocą „analogów”.

### 2.3 Sterowanie w zamkniętej pętli

Do sterowania dronem w zamkniętej pętli został zaimplementowany regulator LQR oraz wyma-gane do jego działania układy formujące obecny wektor stanu x oraz zadany wektor xsp w pełni zależny od wejści użytkownika. Następuje obliczenie uchybu regulacji, przemnożenie przez macierz K oraz przesunięcie wyniku do punktu pracy.

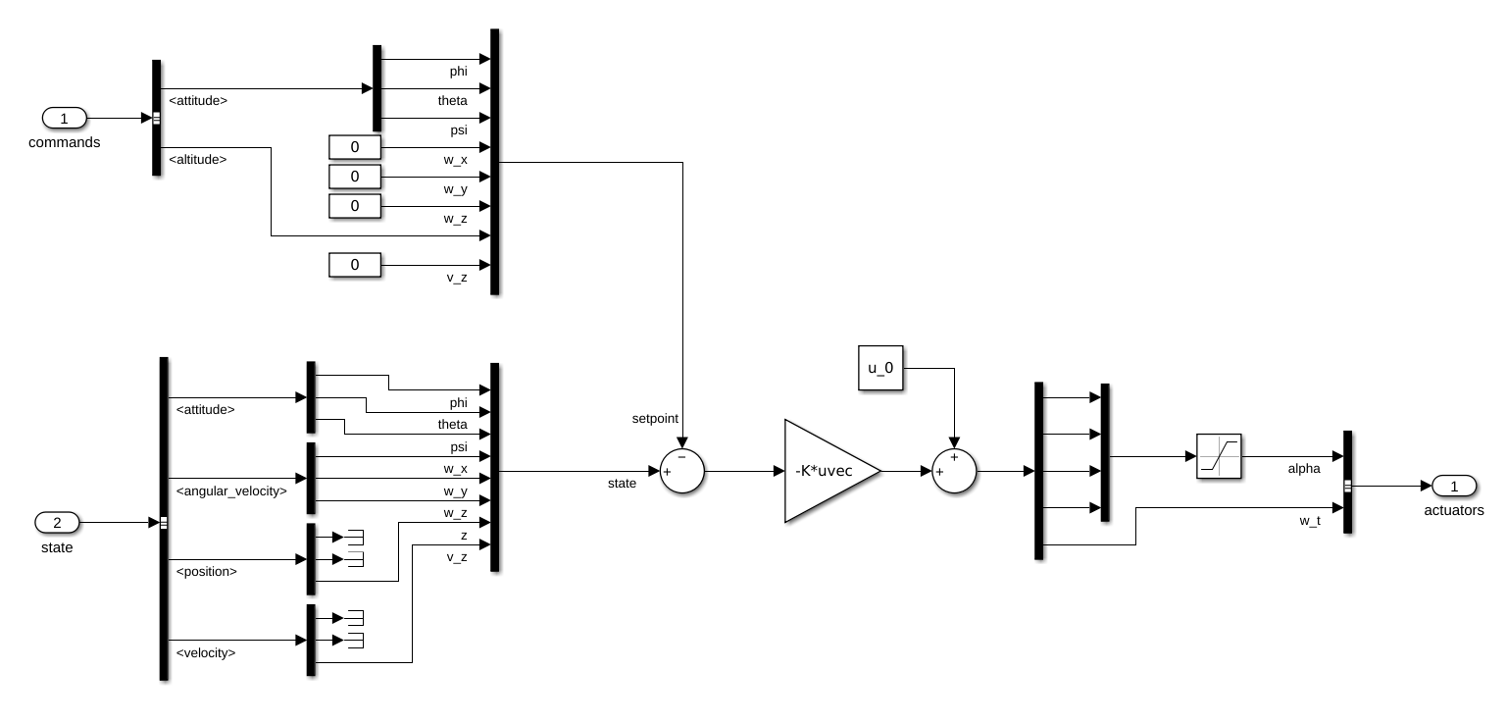
[picture p16: figure]

Rysunek 5: Regulator LQR wykorzystujący idealne dane z symulacji

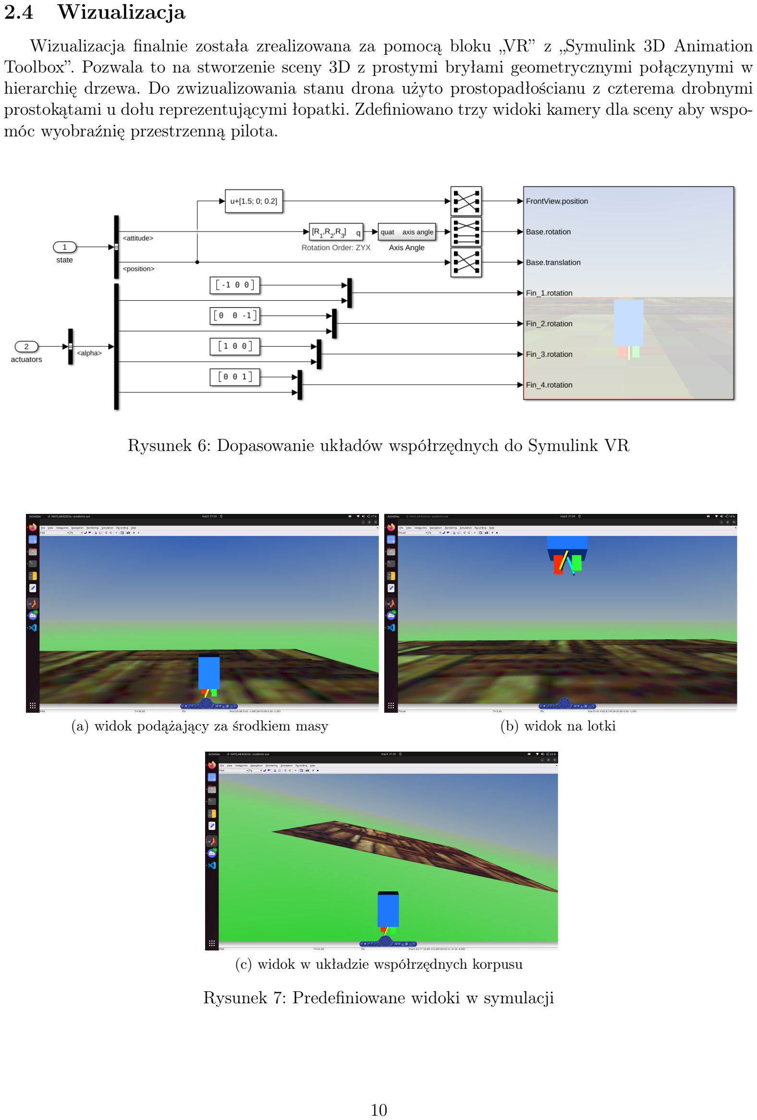
[picture p17: page 11]

### 2.4 Wizualizacja

Wizualizacja finalnie została zrealizowana za pomocą bloku „VR” z „Symulink 3D Animation Toolbox”. Pozwala to na stworzenie sceny 3D z prostymi bryłami geometrycznymi połączynymi w hierarchię drzewa. Do zwizualizowania stanu drona użyto prostopadłościanu z czterema drobnymi prostokątami u dołu reprezentującymi łopatki. Zdefiniowano trzy widoki kamery dla sceny aby wspo-móc wyobraźnię przestrzenną pilota.

Rysunek 6: Dopasowanie układów współrzędnych do Symulink VR

(a) widok podążający za środkiem masy | (b) widok na lotki
(c) widok w układzie współrzędnych korpusu

Rysunek 7: Predefiniowane widoki w symulacji

## 3 Przeprowadzone testy

Do testów użyto następujących danych:

Kt = 0.0001 Ns²

Cl = 0.2
Cd = 0.1
Cτ = 0.03
Jxx = 0.1 mkg
Jyy = 0.1 mkg
Jzz = 0.1 mkg
Jr = 0.001 mkg
m = 0.5 kg
l = 0.1 m
r = 0.1 m

g = 9.81

m
s

2

Metodą prób i błędów zostały znalezione nastawy regulatora o akceptowalnych wynikach:

Q = diag([10, 10, 100, 1, 1, 100, 1000, 100]) R = diag([1, 1, 1, 1, 10])

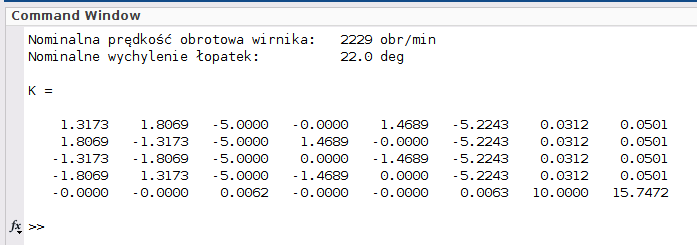
[picture p18: figure]

Rysunek 8: Wynik działania skryptu, widoczny punkt pracy oraz macierz regulatora

## Bibliografia

[1] Victor H. Dominguez i in. “Micro Coaxial Drone: Flight Dynamics, Simulation and Ground Testing”. W: Aerospace 9.5 (2022). issn: 2226-4310. doi: 10.3390/aerospace9050245. (https://doi.org/10.3390/aerospace9050245) url: https://www.mdpi.com/2226-4310/9/5/245.
[2] Emil Bjerregaard Jacobsen. Modelling and Control of Thrust Vectoring Mono-copter. 2020. url: https://projekter.aau.dk/projekter/files/421577367/Master_Thesis_Emil_Jacobsen_v5.pdf. (https://projekter.aau.dk/projekter/files/421577367/Master_Thesis_Emil_Jacobsen_v5.pdf)
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
