Eryk-Mozdzen/uav-tvc-goose/docs/reports/RM_etap3_finalny_projekt.pdf

Projekt

Roboty Mobilne 1

## Symulacja bezzałogowego statku powietrznego w

## środowisku Simulink – sprawozdanie z finalnego projektu

Eryk Możdżeń, 259375

Prowadzący:
dr inż. Michał Błędowski

Katedra Teorii Pola, Układów Elektronicznych i Optoelektroniki Wydziału Elektroniki, Fotoniki i Mikrosystemów
Politechniki Wrocławskiej

15 czerwca 2023

## 1 Symulacja czujników

Blok czujników przekształca stan obiektu na dane możliwe do uzyskania z czujników. Odczyty są zgrupowane w szynę ułatwiającą manipulację danymi na schemacie tak jak pokazano na rys. 1. Odczyty z czujników są dostarczane do bloku kontrolera lotu wyposażonemu w estymator stanu. Rys. 2 przedstawia blok czujników. Zawiera on zbiór mniejszych podsystemów odpowiedzialnych niezależnie za każdy z czujników.

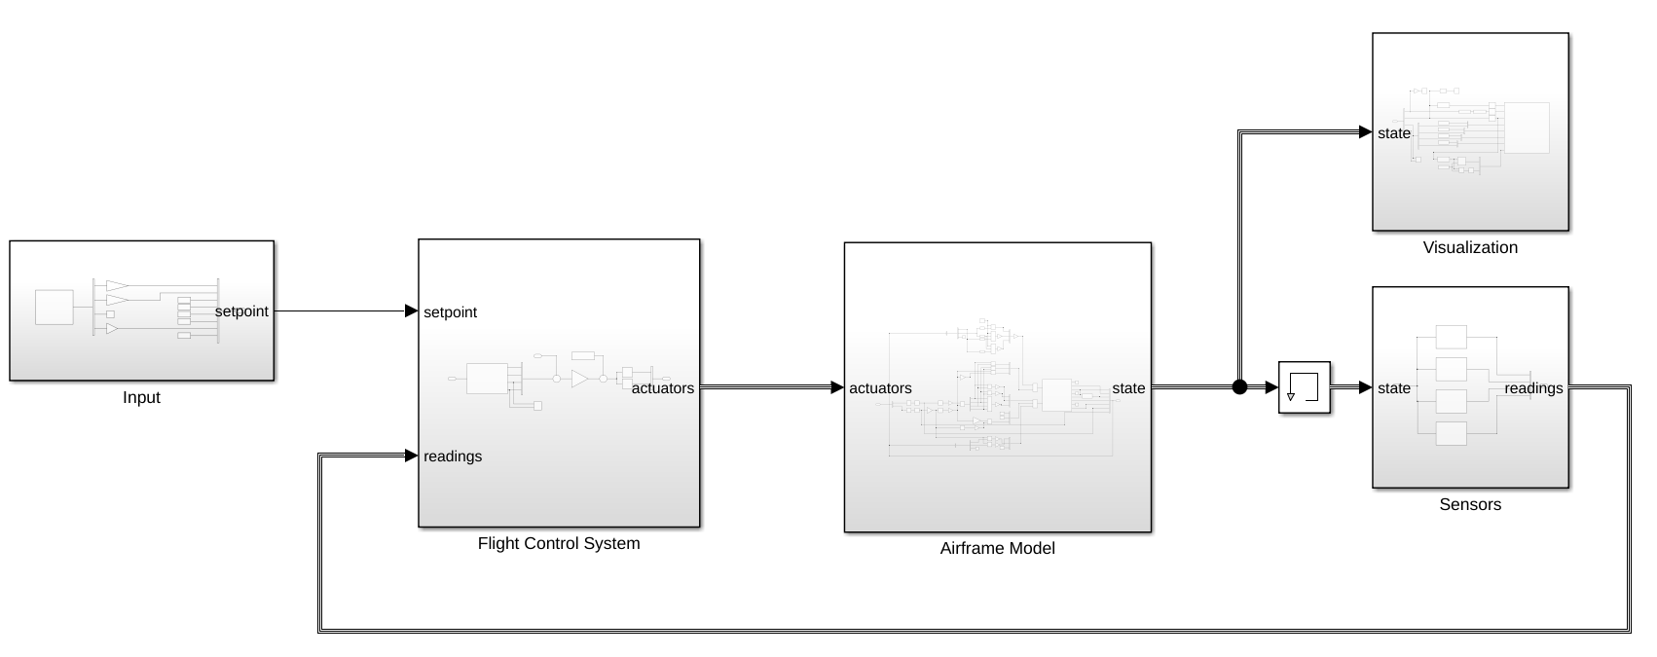
[picture p19: figure]

Rysunek 1: Zaktualizowany szkielet symulacji, widoczny dodany blok czujników

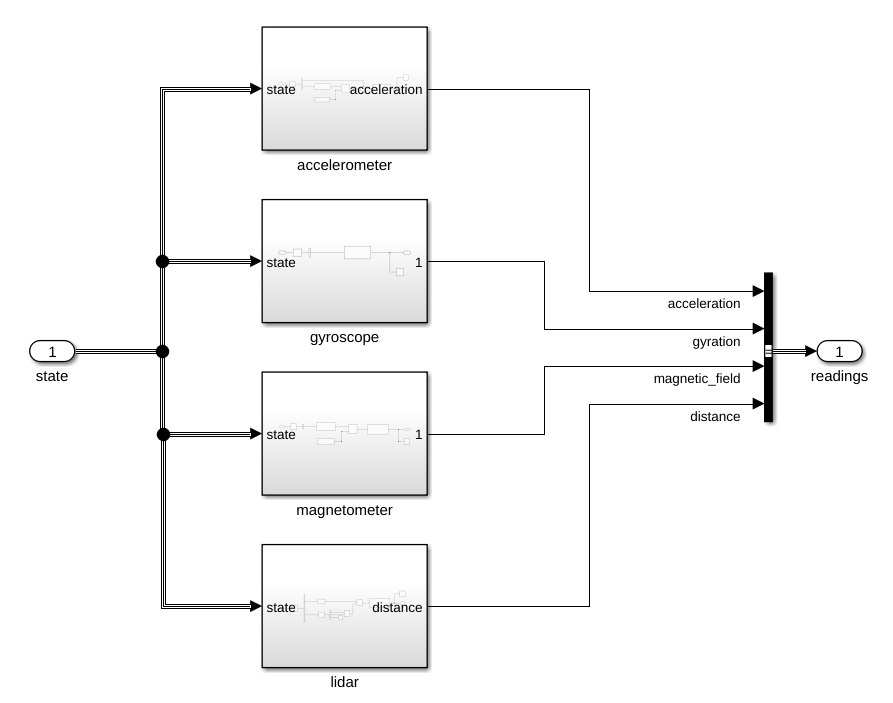
[picture p20: figure]

Rysunek 2: Zawartość bloku symulującego czujniki, od góry: akcelerometr, żyroskop, magnetometr, laserowy czujnik odległości 1D

### 1.1 Akcelerometr

Symulacja odczytów akcelerometru zawiera w sobie sumę przyśpieszenia grawitacyjnego skierowanego pionowo w dół względem układu świata oraz przyśpieszeń liniowych z którymi porusza się układ. Blok „AWGN Channel” z „Communication Toolbox” dodaje do sygnału szum o rozkładzie Gaussa o konkretnie zdefiniowanej wariancji. Blok „Zero-Order Hold” przekształca sygnał ciągły na schodkowy symulując częstotliwość pomiaru. Rys. 3 przedstawia opisywany blok.

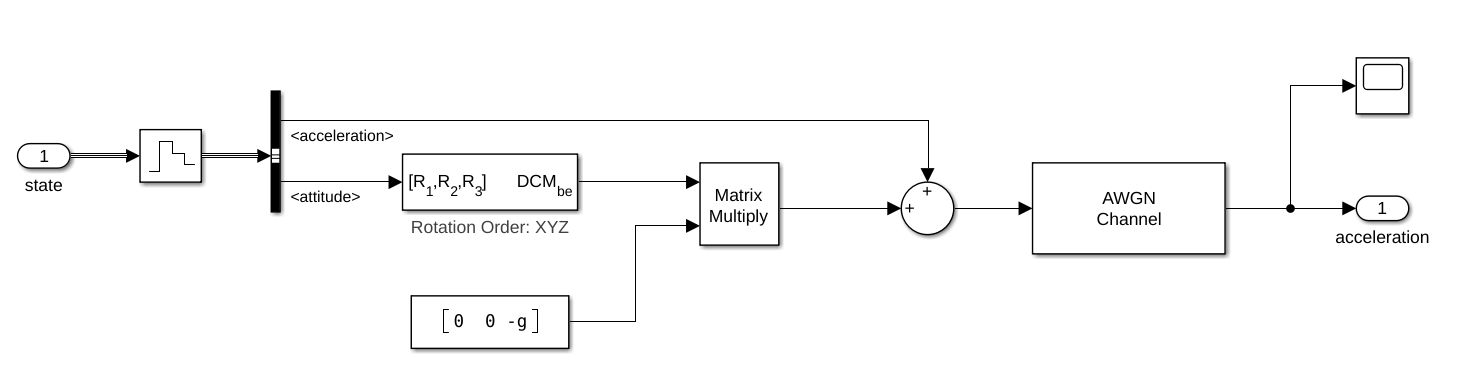
[picture p21: figure]

Rysunek 3: Blok symulujący akcelerometr

### 1.2 Żyroskop cyfrowy

Blok symulacji obiektu opisuje prędkości kątowe w układzie odniesienia ciała czyli tak, jak symulowany żyroskop. Dodane zostały bloki „Zero-Order Hold” oraz „AWGN Channel” w celu symulacji fizycznych aspektów i ograniczeń czujnika tak jak pokazano na rys. 4.

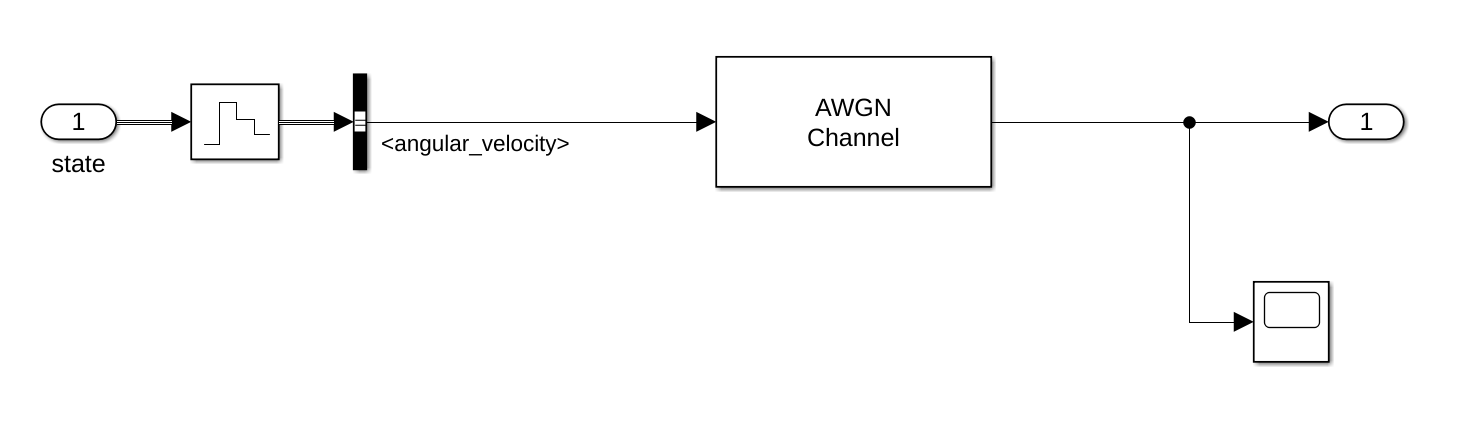
[picture p22: figure]

Rysunek 4: Blok symulujący cyfrowy żyroskop

### 1.3 Magnetometr

Blok symulacji magnetometru (rys. 5) wykonany jest analogicznie jak blok akcelerometru. Także obraca wektor pola magnetycznego. W tym wypadku skierowany jest on prosto w kierunku północnym (brak zjawiska deklinacji magnetycznej). Także dodane zostały bloki ograniczające częstotliwość pomiaru oraz dodanie do pomiaru sygnału o zdefiniowanej wariancji.

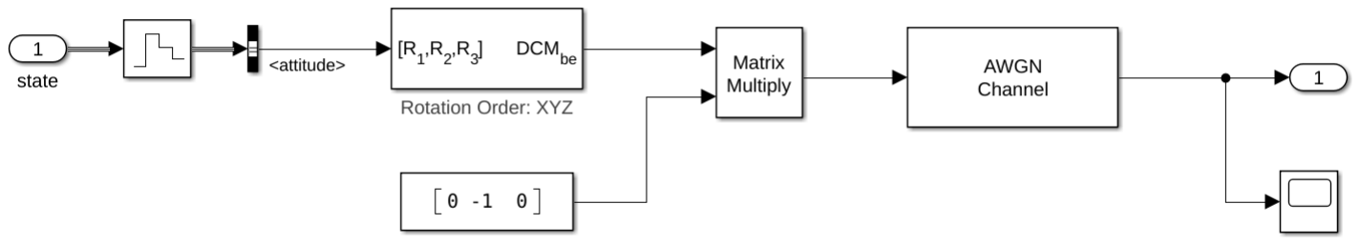
[picture p23: figure]

Rysunek 5: Blok symulujący magnetometr

## 2 Estymator stanu

Blok kontrolera lotu został wyposażony w podzespół estymatora stanu. Jego zadaniem jest określenie możliwie jak najlepszej estymaty ukrytego stanu drona. Uchyb od wartości zadanej kontrolerem USB jest jest podawany na regulator LQR. Opisane działanie przedstawione jest na rys. 6.

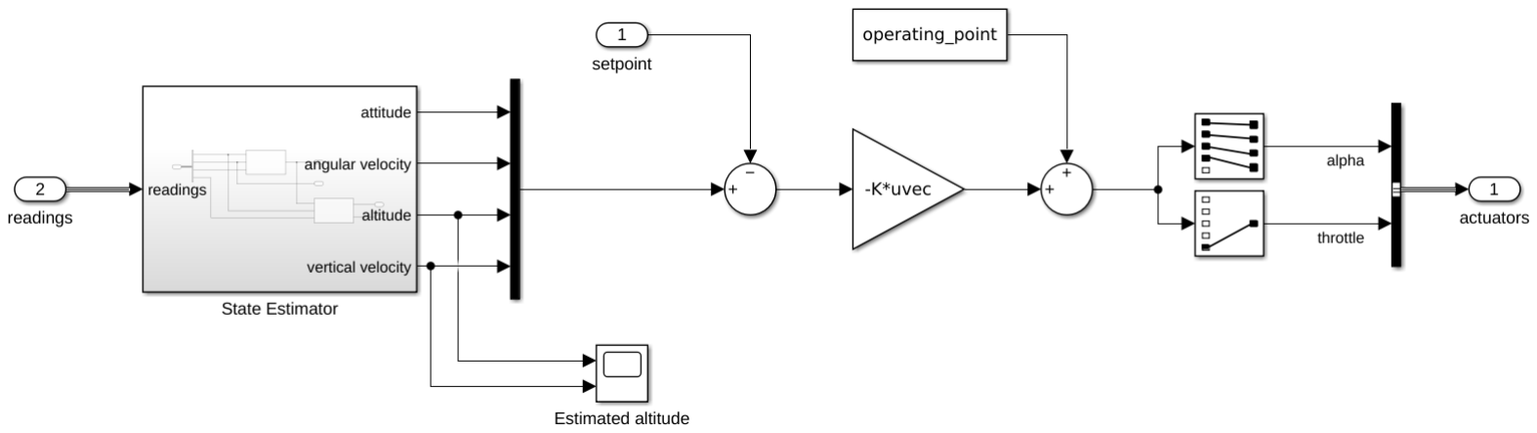
[picture p24: figure]

Rysunek 6: Schemat sterownika lotu

Na estymator stanu składają się dwa mniejsze estymatory połączone kaskadowo. Pierwszy z nich odpowiada za estymację orientacji w przestrzeni obiektu. Prędkości kątowe pochodzą bezpośrednio ze wskazań żyroskopu (brak innych źródeł danych). Estymowana orientacja jest istotnym wejściem drugiego estymatora – wysokości. Określa on wysokość na której znajduje się dron oraz składową pionową wektora jego prędkości.

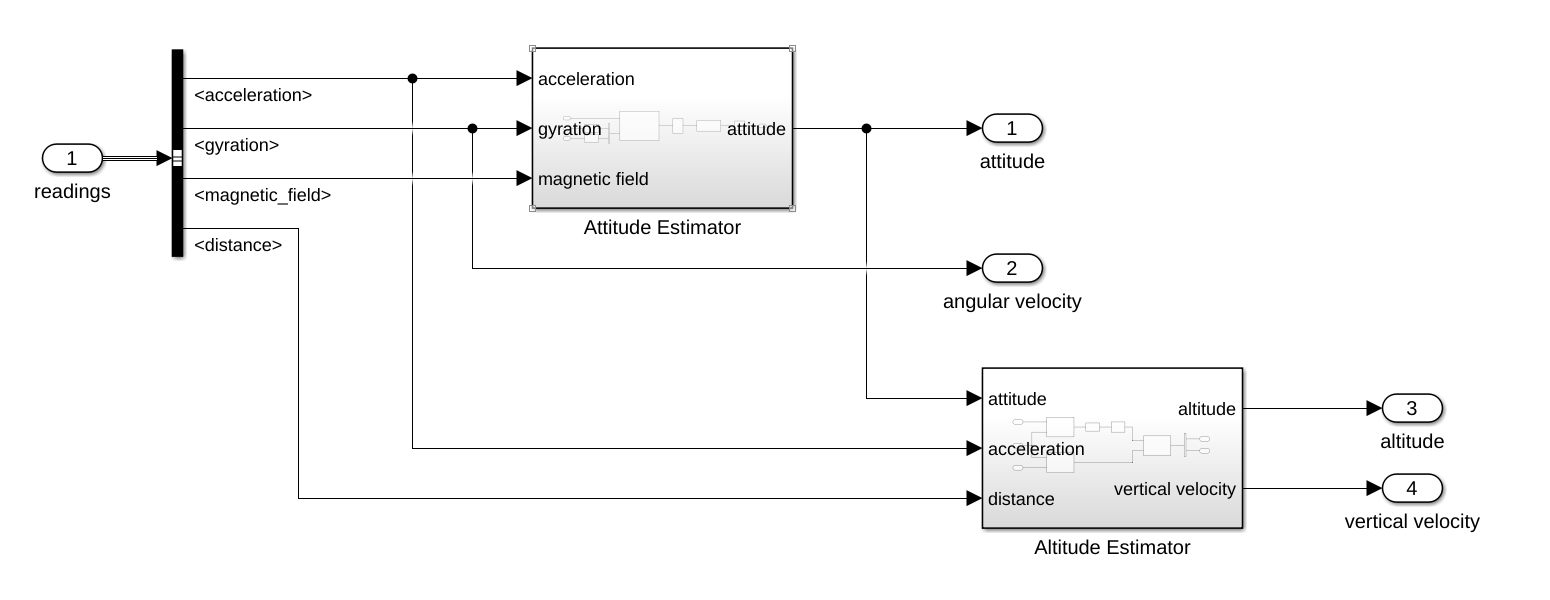
[picture p25: figure]

Rysunek 7: Schemat estymatora stanu, widoczne dwa główne podsystemy: estymator orientacji oraz estymator wysokości

### 2.1 Estymator orientacji

Estymacja orientacji jest oparta o rozszerzony filtr Kalmana. Dokonuje on etapu predykcji na podstawie pomiarów prędkości kątowych z żyroskopu, natomiast etapu korekcji z użyciem danych pochodzących z akcelerometru oraz magnetometru tak jak pokazano na rys. 8. Wzory opisujące układ zostały pokazane w równ. 1 oraz 2. Model został opary o [1].

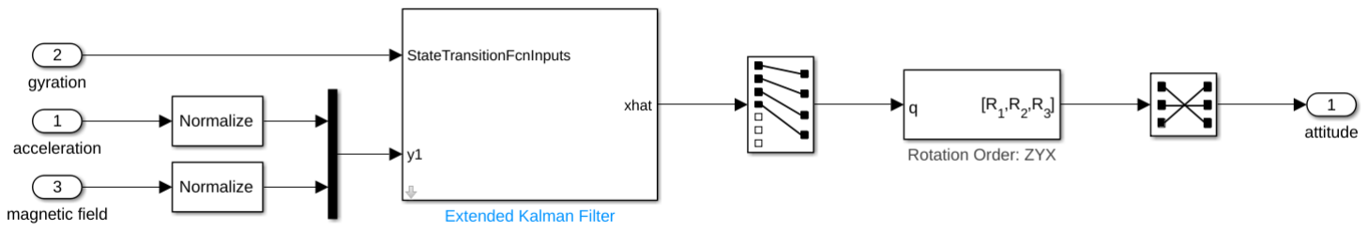
[picture p26: figure]

Rysunek 8: Schemat estymatora orientacji

xk = f(xk−1, uk)
yk = h(xk)

qˆwk
qˆik
qˆj k
qˆkk
ˆbxk
ˆbyk
ˆbzk

=

1 0 0 0 ∆t
2

qik−1

∆t
2

qj k−1

∆t
2

qkk−1
0 1 0 0 −

∆t
2

qwk−1

∆t
2

qkk−1 −

∆t
2

qj k−1
0 0 1 0 −

∆t
2

qkk−1 −

∆t
2

qwk−1

∆t
2

qik−1
0 0 0 1 ∆t
2

qj k−1 −

∆t
2

qik−1 −

∆t
2

qwk−1
0 0 0 0 | 1 | 0 | 0
0 0 0 0 | 0 | 1 | 0
0 0 0 0 | 0 | 0 | 1

·

qˆwk−1

qˆik−1

qˆj k−1

qˆkk−1

ˆbxk−1

ˆbyk−1

ˆbzk−1

+

∆t
2

−qˆik−1 | −qˆj k−1 | −qˆkk−1
qˆwk−1 | −qˆkk−1 | qˆj k−1
qˆkk−1 | qˆwk−1 | −qˆik−1
−qˆj k−1 | qˆik−1 | qˆwk−1
0 | 0 | 0
0 | 0 | 0
0 | 0 | 0

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
2ˆqjk−1 | −2ˆqkk−1 | 2ˆqwk−1 | −2ˆqik−1
0 0 0
−2ˆqik−1 | −2ˆqwk−1 | −2ˆqkk−1 | −2ˆqjk−1
0 0 0
−2ˆqwk−1 | 2ˆqik−1 | 2ˆqjk−1 | −2ˆqkk−1
0 0 0
−2ˆqkk−1 | −2ˆqjk−1 | −2ˆqik−1 | −2ˆqwk−1
0 0 0
−2ˆqwk−1 | 2ˆqik−1 | −2ˆqjk−1 | 2ˆqkk−1
0 0 0
2ˆqik−1 | 2ˆqwk−1 | −2ˆqkk−1 | −2ˆqjk−1
0 0 0

·

qˆwk
qˆik
qˆjk
qˆkk
ˆbxk
ˆbyk
ˆbzk

(2)

### 2.2 Estymator wysokości

Do estymacji wysokości lotu został zastosowany filtr Kalmana sumujący odczyty akcelerometru, estymacji orientacji oraz laserowego czujnika odległości. Wektor mierzonego przyśpieszenia liniowego zostaje obrócony tak, aby współrzędne wektora były zdefiniowane we współrzędnych świata. Od osi z odejmowana jest wartość przyśpieszenia grawitacyjnego g = 9.81m
s

. Dzięki temu uzyskiwane jest przyśpieszenie liniowe w pionie az. Równania zostały wyrażone tak jak w równ. 3 i 4. Efektem ubocznym jest estymata prędkości w pionie wymagana do realizacji sterowania. Implementacja pokazana została na rys. 9.

xk = Axk−1 + Buk
yk = Cxk
zˆk

vˆzk
=
1 ∆t

0 1
·
zˆk−1

vˆzk−1

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
vˆzk
(4)

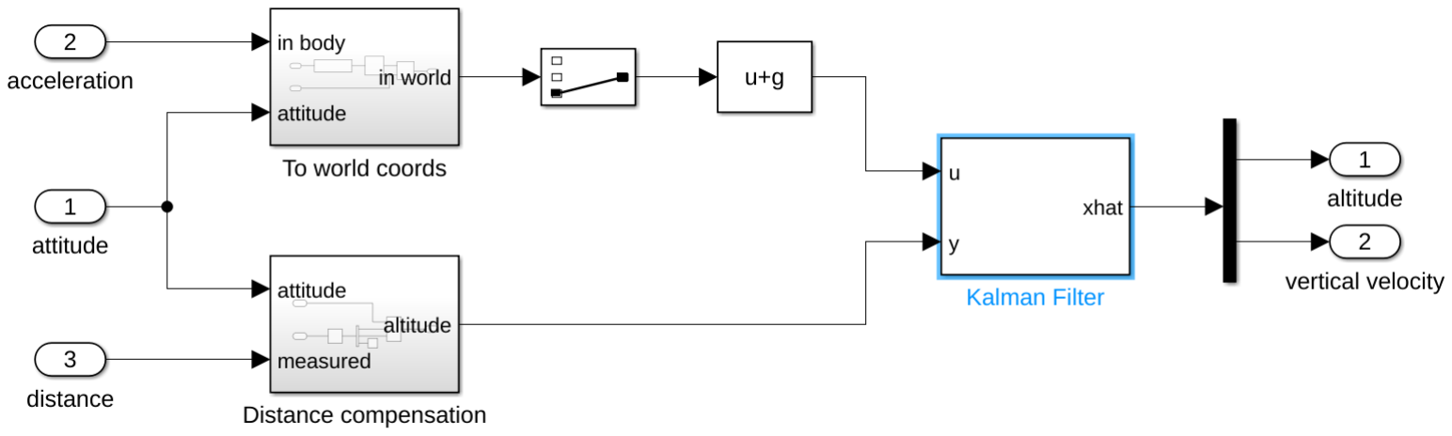
[picture p27: figure]

Rysunek 9: Schemat estymatora wysokości

W celu kompensacji wpływu orientacji na pomiar odległości od ziemi, pomiar jest mnożony przez cosinus kąt wychylenia od pionu zgodnie ze zworem poniżej.

haltitude = dmeasured · cos ϕ cos θ

## 3 Podsumowanie i wnioski

Symulacja jednowirnikowego bezzałogowego pojazdu latającego stanowi punkt wyjścia w procesie tworzeniu tak niełatwego do sterowania obiektu. Podczas testów sprzecznie z początkowymi przewidywaniami najcięższym zadaniem okazała się być estymacja stanu drona (a nie sterowanie nim). Symulacja podkreśliła niestacjonarność badanego obiektu pod względem parametrów fizycznych, których dobór ma szczególnie wysokie znaczenie pod względem stabilności. Zaskoczeniem okazały się być także niektóre własności dynamiki drona tj. poruszanie się po niewielkiej paraboli podczas przechyłu.
Uważam, że wykonana symulacja posiada aspekty praktyczne oraz pozytywnie wpłynie na dalszy rozwój projektu. Zakładam, że bardzo ułatwi proces projektowania konstrukcji mechanicznej opisywanego urządzenia. Pozwoli także na początkowy dobór nastaw regulatora metodą offline co zmniejszy potrzebną ilość testów oraz potencjalnych uszkodzeń konstrukcji.

## Bibliografia

[1] Extended Kalman Filter Implementation. 2018. url: https : / / thepoorengineer . com / en / ekf -impl/. (https://thepoorengineer.com/en/ekf-impl/)
