Eryk-Mozdzen/uav-tvc-goose/docs/dso_11_18_08_23_58.bmp

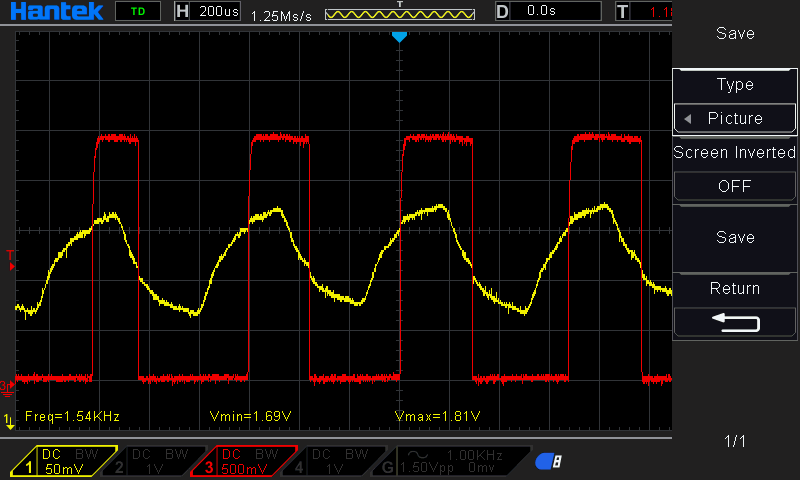
docs/dso_11_18_08_23_58.bmp
