Eryk-Mozdzen/uav-tvc-goose/electronics-v2/resources/goose2.jpg

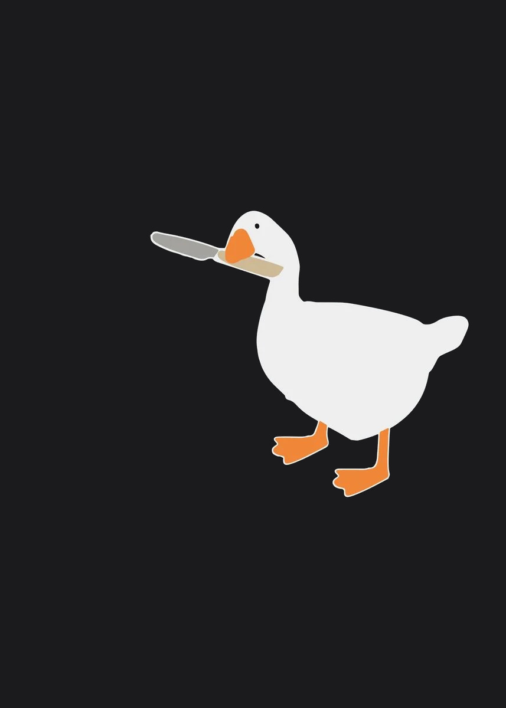
electronics-v2/resources/goose2.jpg
