Eryk-Mozdzen/uav-tvc-goose/electronics-v2/resources/goose.jpg

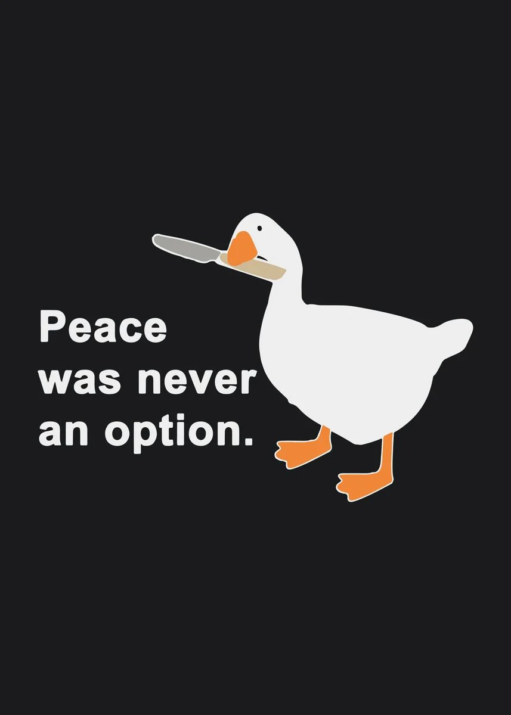
electronics-v2/resources/goose.jpg
