Eryk-Mozdzen/uav-tvc-goose/electronics-v2/resources/konar.jpg

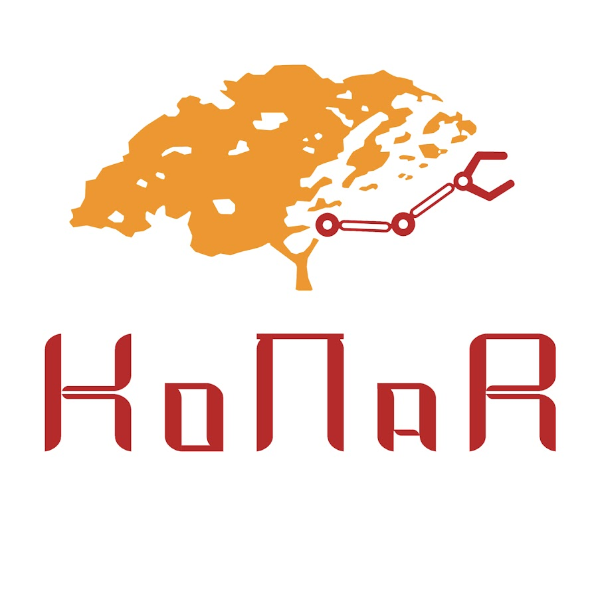
electronics-v2/resources/konar.jpg
