Eryk-Mozdzen/uav-tvc-goose/software/goose-visual/qml/models/rocket.obj

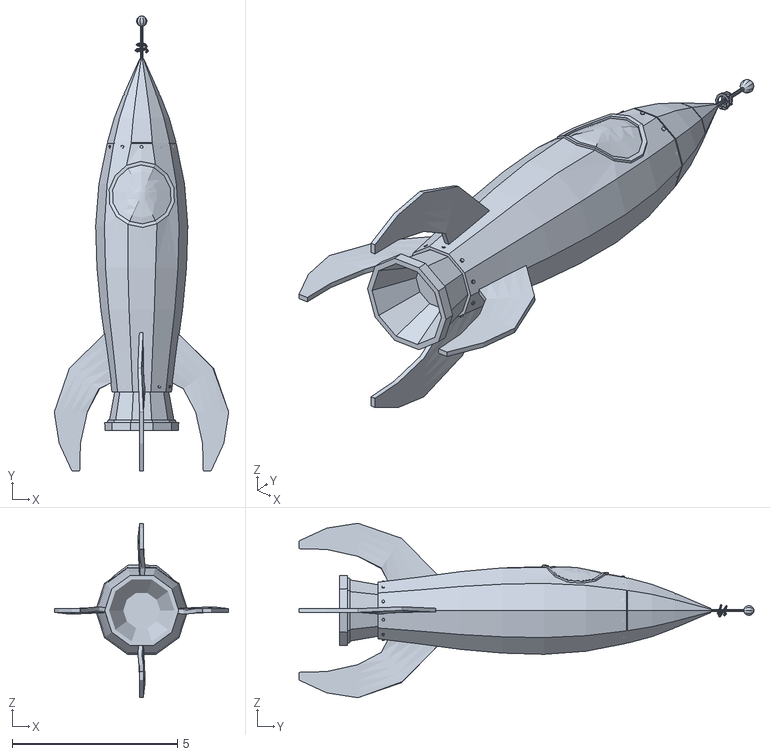
[picture p52: CAD file, 2023-05-30]
software/goose-visual/qml/models/rocket.obj
5.28 x 13.8 x 5.28
