Eryk-Mozdzen/uav-tvc-goose/docs/thrust_test.pdf

## Thrust BL400/1400, charged LiPO 3S, ESC 20A

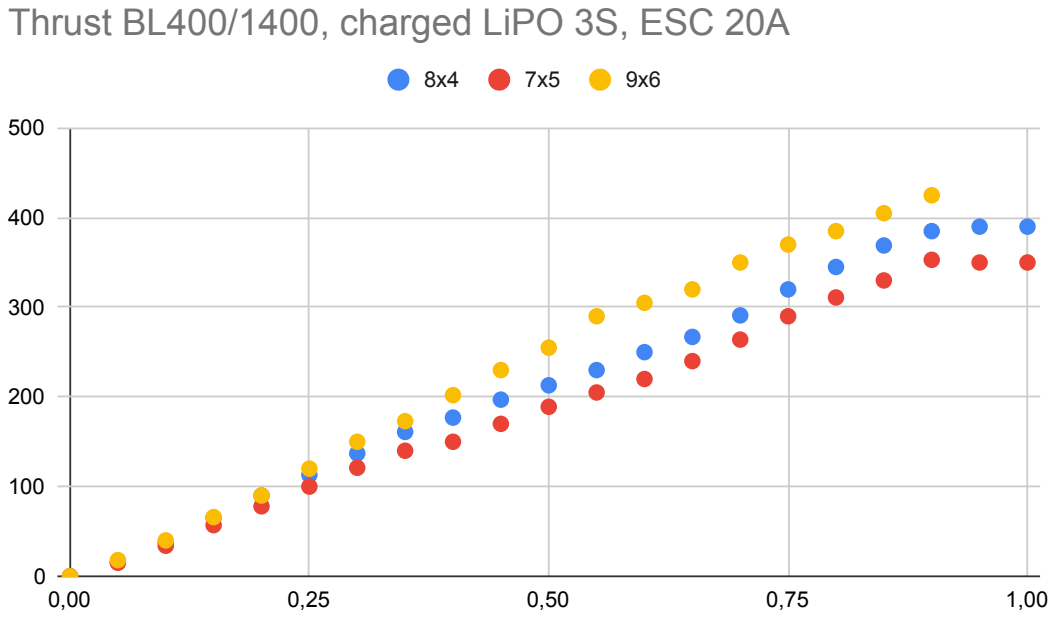
[picture p53: page 1]
