Eryk-Mozdzen/uav-tvc-goose/electronics-v2/flight-controller-v2/flight-controller-v2.kicad_pcb

## KiCad design electronics-v2/flight-controller-v2/flight-controller-v2.kicad_pcb (2023-08-19)

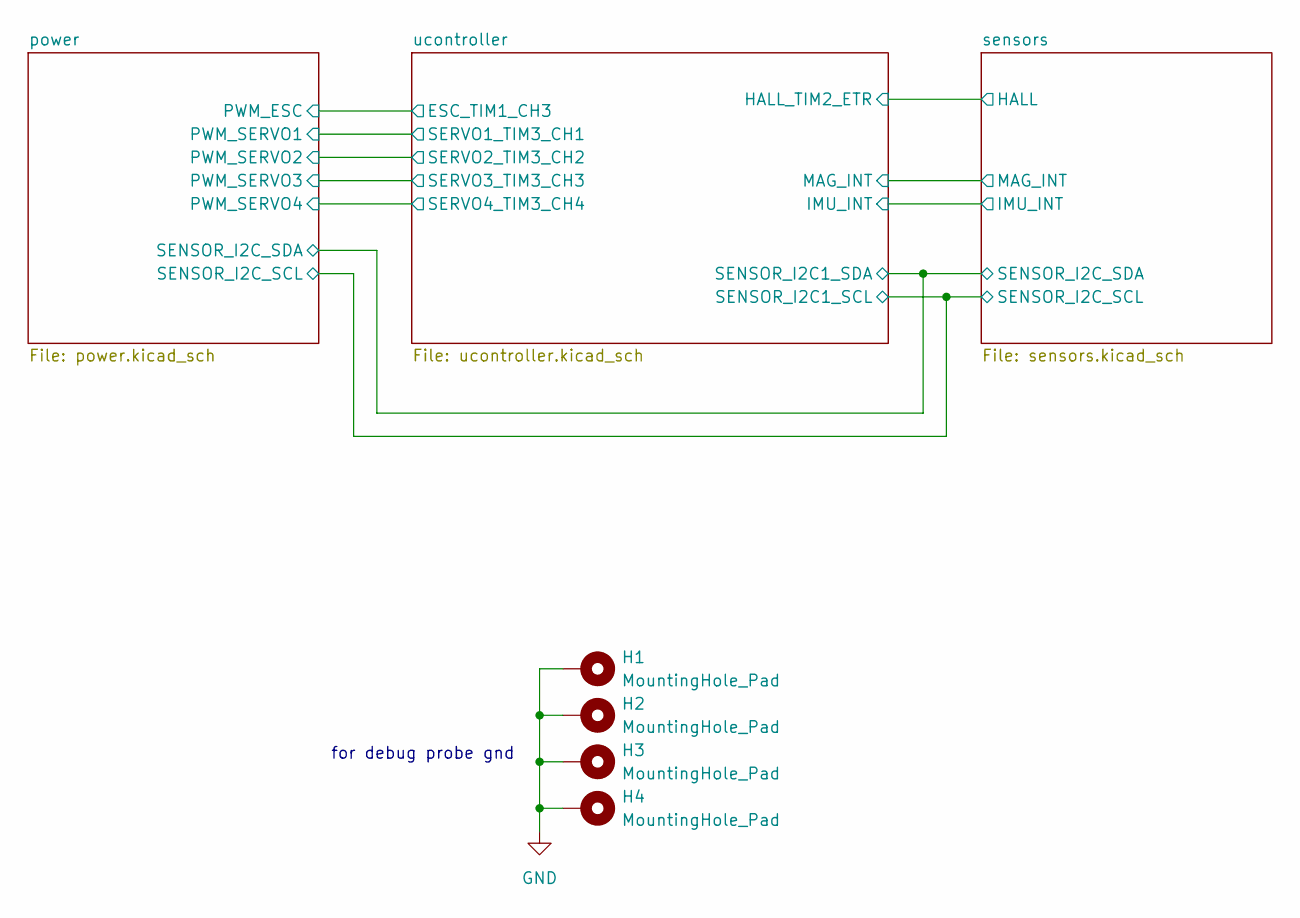
[picture p58: schematic flight-controller-v2.kicad_sch, UAV TVC Goose Flight Controller]

Parts:
H1, H2, H3, H4: MountingHole_Pad; MountingHole_3.2mm_M3_Pad_Via

Connections:
GND: H1.1, H2.1, H3.1, H4.1; also elsewhere on the board

Notes on the sheet:
for debug probe gnd

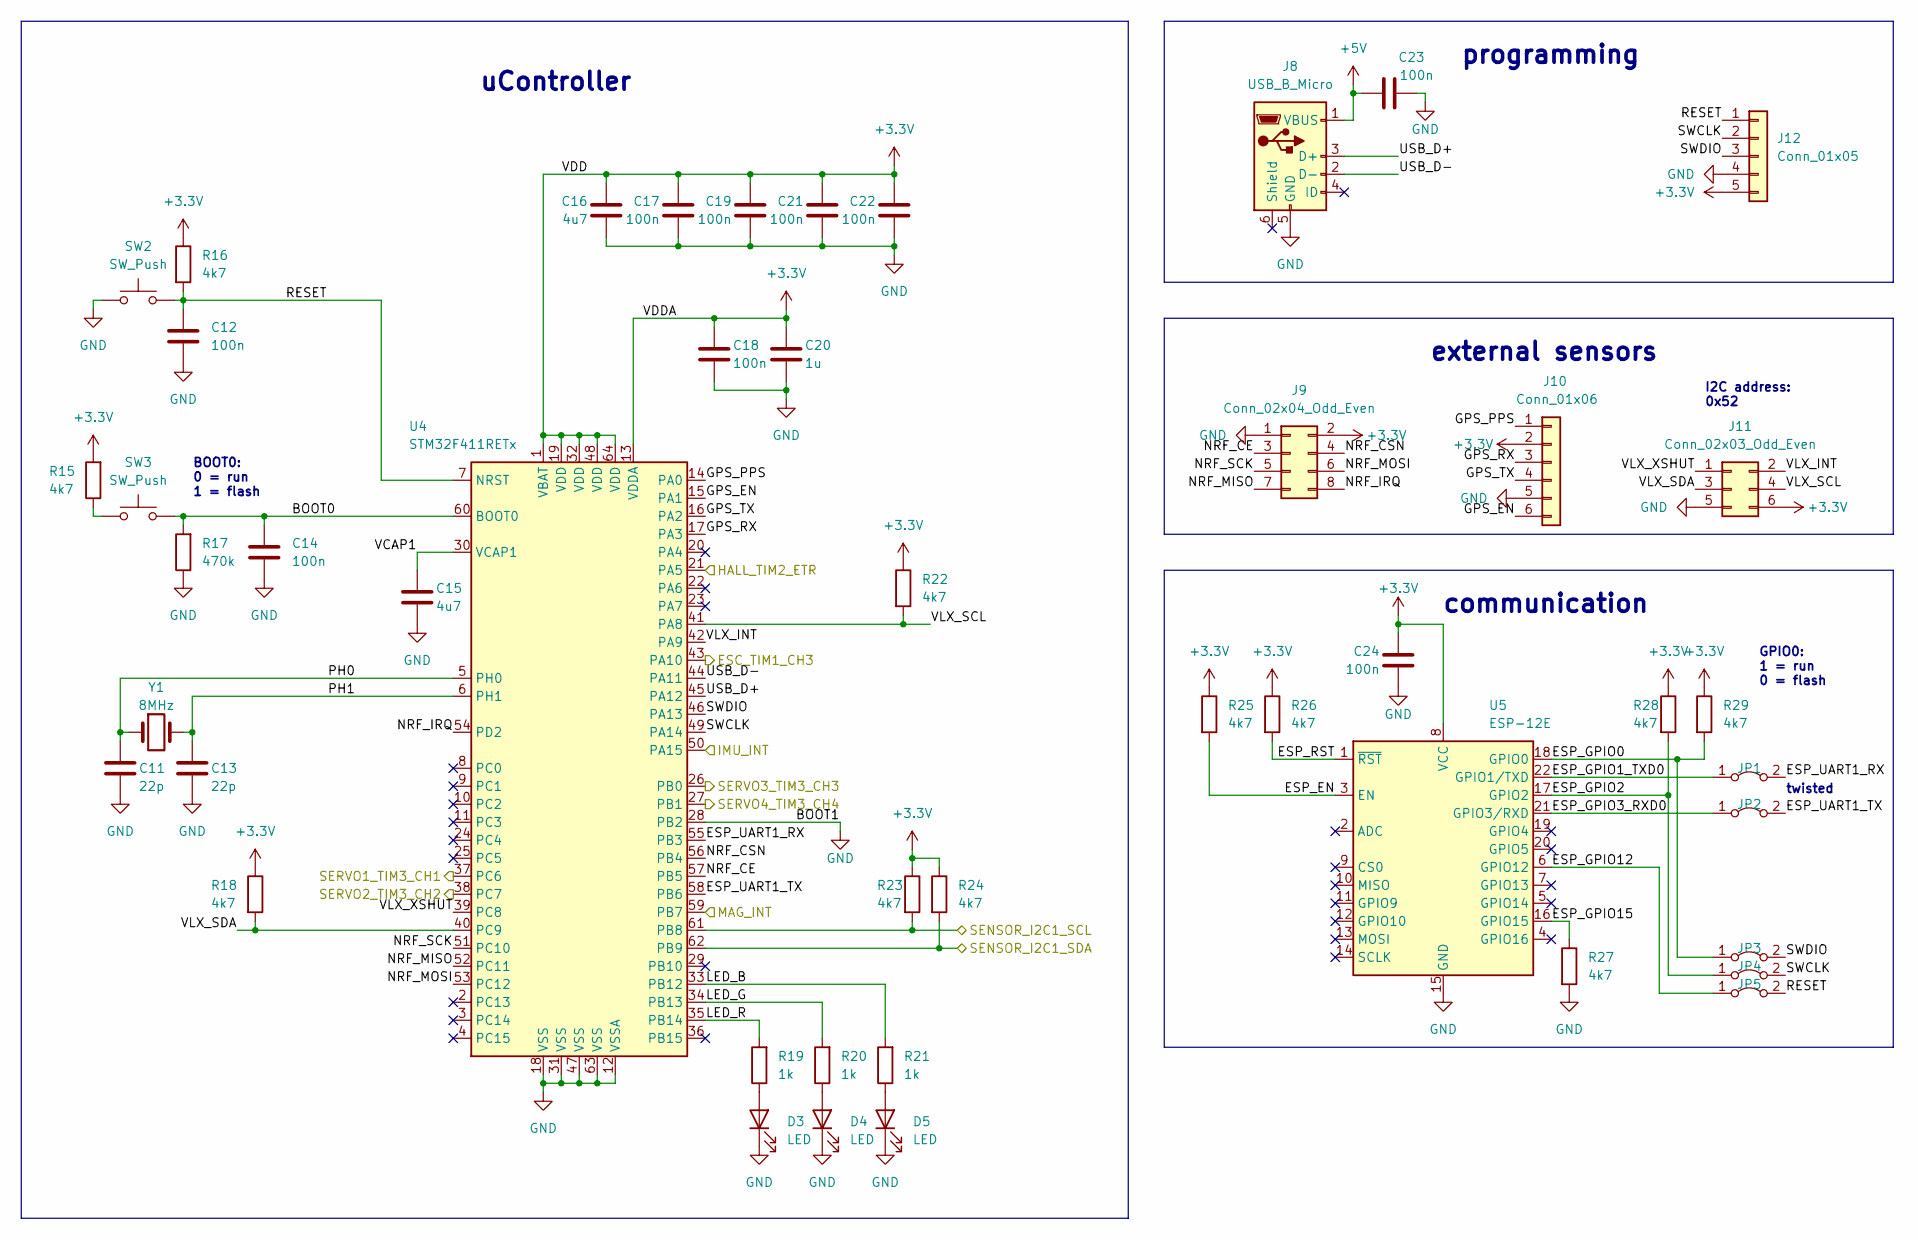
[picture p59: schematic ucontroller.kicad_sch, UAV TVC Goose Flight Controller]

Parts:
C11, C13: 22p; C_0603_1608Metric
C12, C14, C17, C18, C19, C21, C22, C23, C24: 100n; C_0603_1608Metric
C15, C16: 4u7; C_0603_1608Metric
C20: 1u; C_0603_1608Metric
D3, D4, D5: LED; LED_0603_1608Metric
J8: USB_B_Micro; usb_micro_B_druk_II
J9: Conn_02x04_Odd_Even; tht_pin_02x04
J10: Conn_01x06; tht_pin_01x06
J11: Conn_02x03_Odd_Even; IDC-Header_2x03_P2.54mm_Vertical
J12: Conn_01x05; tht_pin_01x05
JP1, JP2, JP3, JP4, JP5: SolderJumper-2_P1.3mm_Open_TrianglePad1.0x1.5mm
R15, R16, R18, R22, R23, R24, R25, R26, R27, R28, R29: 4k7; R_0603_1608Metric
R17: 470k; R_0603_1608Metric
R19, R20, R21: 1k; R_0603_1608Metric
SW2, SW3: SW_Push; SW_SPST_FSMSM
U4: STM32F411RETx; LQFP-64_10x10mm_P0.5mm
U5: ESP-12E
Y1: 8MHz; Crystal_SMD_5032-2Pin_5.0x3.2mm

Connections:
+3.3V: C16.1, C17.1, C18.1, C19.1, C20.1, C21.1, C22.1, C24.1, J9.2, J10.2, J11.6, J12.5, R15.2, R16.1, R18.1, R22.1, R23.1, R24.1, R25.1, R26.1, R28.1, R29.1, U4.1 (VBAT), U4.13 (VDDA), U4.19 (VDD), U4.32 (VDD), U4.48 (VDD), U4.64 (VDD), U5.8 (VCC); also elsewhere on the board
+5V: C23.1, J8.1 (VBUS); also elsewhere on the board
/power/PWM_ESC: U4.43 (PA10); also elsewhere on the board
/power/PWM_SERVO1: U4.37 (PC6); also elsewhere on the board
/power/PWM_SERVO2: U4.38 (PC7); also elsewhere on the board
/power/PWM_SERVO3: U4.26 (PB0); also elsewhere on the board
/power/PWM_SERVO4: U4.27 (PB1); also elsewhere on the board
/power/SENSOR_I2C_SCL: R23.2, U4.61 (PB8); also elsewhere on the board
/power/SENSOR_I2C_SDA: R24.2, U4.62 (PB9); also elsewhere on the board
/sensors/HALL: U4.21 (PA5); also elsewhere on the board
/sensors/IMU_INT: U4.50 (PA15); also elsewhere on the board
/sensors/MAG_INT: U4.59 (PB7); also elsewhere on the board
/ucontroller/BOOT0: C14.1, R17.2, SW3.2, U4.60 (BOOT0)
/ucontroller/ESP_EN: R25.2, U5.3 (EN)
/ucontroller/ESP_GPIO0: JP3.1 (A), R29.2, U5.18 (GPIO0)
/ucontroller/ESP_GPIO1_TXD0: JP1.1 (A), U5.22 (GPIO1/TXD)
/ucontroller/ESP_GPIO2: JP4.1 (A), R28.2, U5.17 (GPIO2)
/ucontroller/ESP_GPIO3_RXD0: JP2.1 (A), U5.21 (GPIO3/RXD)
/ucontroller/ESP_GPIO12: JP5.1 (A), U5.6 (GPIO12)
/ucontroller/ESP_GPIO15: R27.1, U5.16 (GPIO15)
/ucontroller/ESP_RST: R26.2, U5.1 (~RST)
/ucontroller/ESP_UART1_RX: JP1.2 (B), U4.55 (PB3)
/ucontroller/ESP_UART1_TX: JP2.2 (B), U4.58 (PB6)
/ucontroller/GPS_EN: J10.6, U4.15 (PA1)
/ucontroller/GPS_PPS: J10.1, U4.14 (PA0)
/ucontroller/GPS_RX: J10.3, U4.17 (PA3)
/ucontroller/GPS_TX: J10.4, U4.16 (PA2)
/ucontroller/LED_B: R21.2, U4.33 (PB12)
/ucontroller/LED_G: R20.2, U4.34 (PB13)
/ucontroller/LED_R: R19.2, U4.35 (PB14)
/ucontroller/NRF_CE: J9.3, U4.57 (PB5)
/ucontroller/NRF_CSN: J9.4, U4.56 (PB4)
/ucontroller/NRF_IRQ: J9.8, U4.54 (PD2)
/ucontroller/NRF_MISO: J9.7, U4.52 (PC11)
/ucontroller/NRF_MOSI: J9.6, U4.53 (PC12)
/ucontroller/NRF_SCK: J9.5, U4.51 (PC10)
/ucontroller/PH0: C11.1, U4.5 (PH0), Y1.1
/ucontroller/PH1: C13.1, U4.6 (PH1), Y1.2
/ucontroller/RESET: C12.1, J12.1, JP5.2 (B), R16.2, SW2.2, U4.7 (NRST)
/ucontroller/SWCLK: J12.2, JP4.2 (B), U4.49 (PA14)
/ucontroller/SWDIO: J12.3, JP3.2 (B), U4.46 (PA13)
/ucontroller/USB_D+: J8.3 (D+), U4.45 (PA12)
/ucontroller/USB_D-: J8.2 (D-), U4.44 (PA11)
/ucontroller/VCAP1: C15.1, U4.30 (VCAP1)
/ucontroller/VLX_INT: J11.2, U4.42 (PA9)
/ucontroller/VLX_SCL: J11.4, R22.2, U4.41 (PA8)
/ucontroller/VLX_SDA: J11.3, R18.2, U4.40 (PC9)
/ucontroller/VLX_XSHUT: J11.1, U4.39 (PC8)
GND: C11.2, C12.2, C13.2, C14.2, C15.2, C16.2, C17.2, C18.2, C19.2, C20.2, C21.2, C22.2, C23.2, C24.2, D3.1 (K), D4.1 (K), D5.1 (K), J8.5 (GND), J9.1, J10.5, J11.5, J12.4, R17.1, R27.2, SW2.1, U4.12 (VSSA), U4.18 (VSS), U4.28 (PB2), U4.31 (VSS), U4.47 (VSS), U4.63 (VSS), U5.15 (GND); also elsewhere on the board
unnamed: D3.2 (A), R19.1
unnamed: D4.2 (A), R20.1
unnamed: D5.2 (A), R21.1
unnamed: R15.1, SW3.1

Notes on the sheet:
BOOT0: 0 = run 1 = flash
programming
I2C address: 0x52
GPIO0: 1 = run 0 = flash
external sensors
communication
uController
twisted

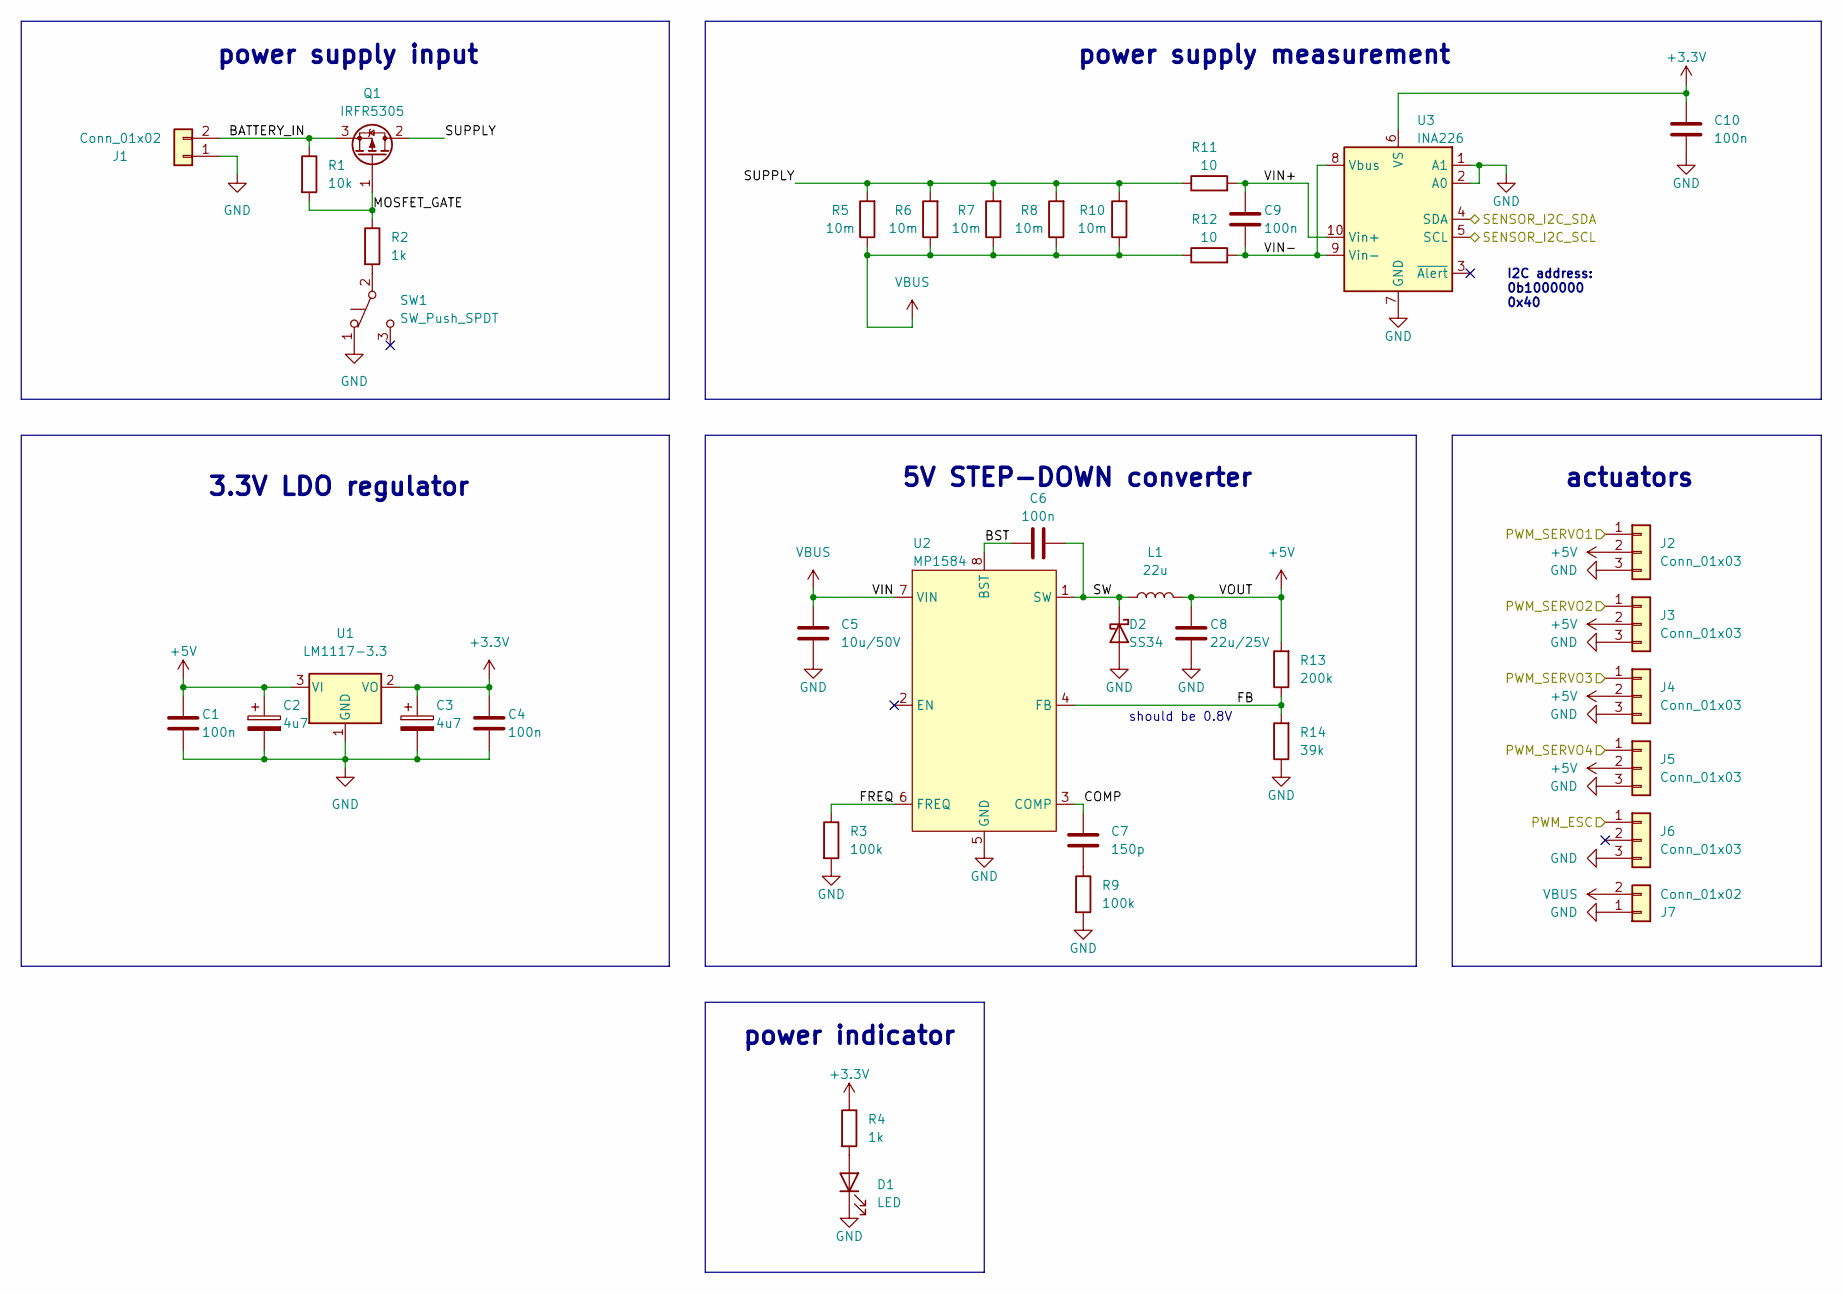
[picture p60: schematic power.kicad_sch, UAV TVC Goose Flight Controller]

Parts:
C1, C4, C6, C9, C10: 100n; C_0603_1608Metric
C2, C3: 4u7; CP_EIA-3216-18_Kemet-A
C5: 10u/50V; C_1206_3216Metric
C7: 150p; C_0603_1608Metric
C8: 22u/25V; C_1206_3216Metric
D1: LED; LED_0603_1608Metric
D2: SS34; D_SMA
J1: Conn_01x02; AMASS_XT60-M_1x02_P7.20mm_Vertical
J2, J3, J4, J5, J6: Conn_01x03; PinHeader_1x03_P2.54mm_Vertical
J7: Conn_01x02; AMASS_XT60-F_1x02_P7.20mm_Vertical
L1: 22u; L_AVX_LMLP07A7
Q1: IRFR5305; TO-252-2
R1: 10k; R_0603_1608Metric
R2, R4: 1k; R_0603_1608Metric
R3, R9: 100k; R_0603_1608Metric
R5, R6, R7, R8, R10: 10m; R_1206_3216Metric
R11, R12: 10; R_0603_1608Metric
R13: 200k; R_0603_1608Metric
R14: 39k; R_0603_1608Metric
SW1: SW_Push_SPDT; SW_CuK_JS202011CQN_DPDT_Straight
U1: LM1117-3.3; SOT-223-3_TabPin2
U2: MP1584; SOIC-8-1EP_3.9x4.9mm_P1.27mm_EP2.62x3.51mm_ThermalVias
U3: INA226; VSSOP-10_3x3mm_P0.5mm

Connections:
+3.3V: C3.1, C4.1, C10.2, R4.1, U1.2 (VO), U3.6 (VS); also elsewhere on the board
+5V: C1.1, C2.1, C8.2, J2.2, J3.2, J4.2, J5.2, L1.2, R13.2, U1.3 (VI); also elsewhere on the board
/power/BATTERY_IN: J1.2, Q1.3 (S), R1.1
/power/BST: C6.1, U2.8 (BST)
/power/COMP: C7.1, U2.3 (COMP)
/power/FB: R13.1, R14.2, U2.4 (FB)
/power/FREQ: R3.1, U2.6 (FREQ)
/power/MOSFET_GATE: Q1.1 (G), R1.2, R2.1
/power/PWM_ESC: J6.1; also elsewhere on the board
/power/PWM_SERVO1: J2.1; also elsewhere on the board
/power/PWM_SERVO2: J3.1; also elsewhere on the board
/power/PWM_SERVO3: J4.1; also elsewhere on the board
/power/PWM_SERVO4: J5.1; also elsewhere on the board
/power/SENSOR_I2C_SCL: U3.5 (SCL); also elsewhere on the board
/power/SENSOR_I2C_SDA: U3.4 (SDA); also elsewhere on the board
/power/SUPPLY: Q1.2 (D), R5.2, R6.2, R7.2, R8.2, R10.2, R11.1
/power/SW: C6.2, D2.1 (K), L1.1, U2.1 (SW)
/power/VIN+: C9.2, R11.2, U3.10 (Vin+)
/power/VIN-: C9.1, R12.2, U3.8 (Vbus), U3.9 (Vin-)
GND: C1.2, C2.2, C3.2, C4.2, C5.1, C8.1, C10.1, D1.1 (K), D2.2 (A), J1.1, J2.3, J3.3, J4.3, J5.3, J6.3, J7.1, R3.2, R9.2, R14.1, SW1.1 (A), U1.1 (GND), U2.5 (GND), U3.1 (A1), U3.2 (A0), U3.7 (GND); also elsewhere on the board
unnamed: C7.2, R9.1
unnamed: D1.2 (A), R4.2
unnamed: R2.2, SW1.2 (B)
VBUS: C5.2, J7.2, R5.1, R6.1, R7.1, R8.1, R10.1, R12.1, U2.7 (VIN)

Notes on the sheet:
power indicator
I2C address: 0b1000000 0x40
5V STEP-DOWN converter
3.3V LDO regulator
should be 0.8V
power supply input
power supply measurement
actuators

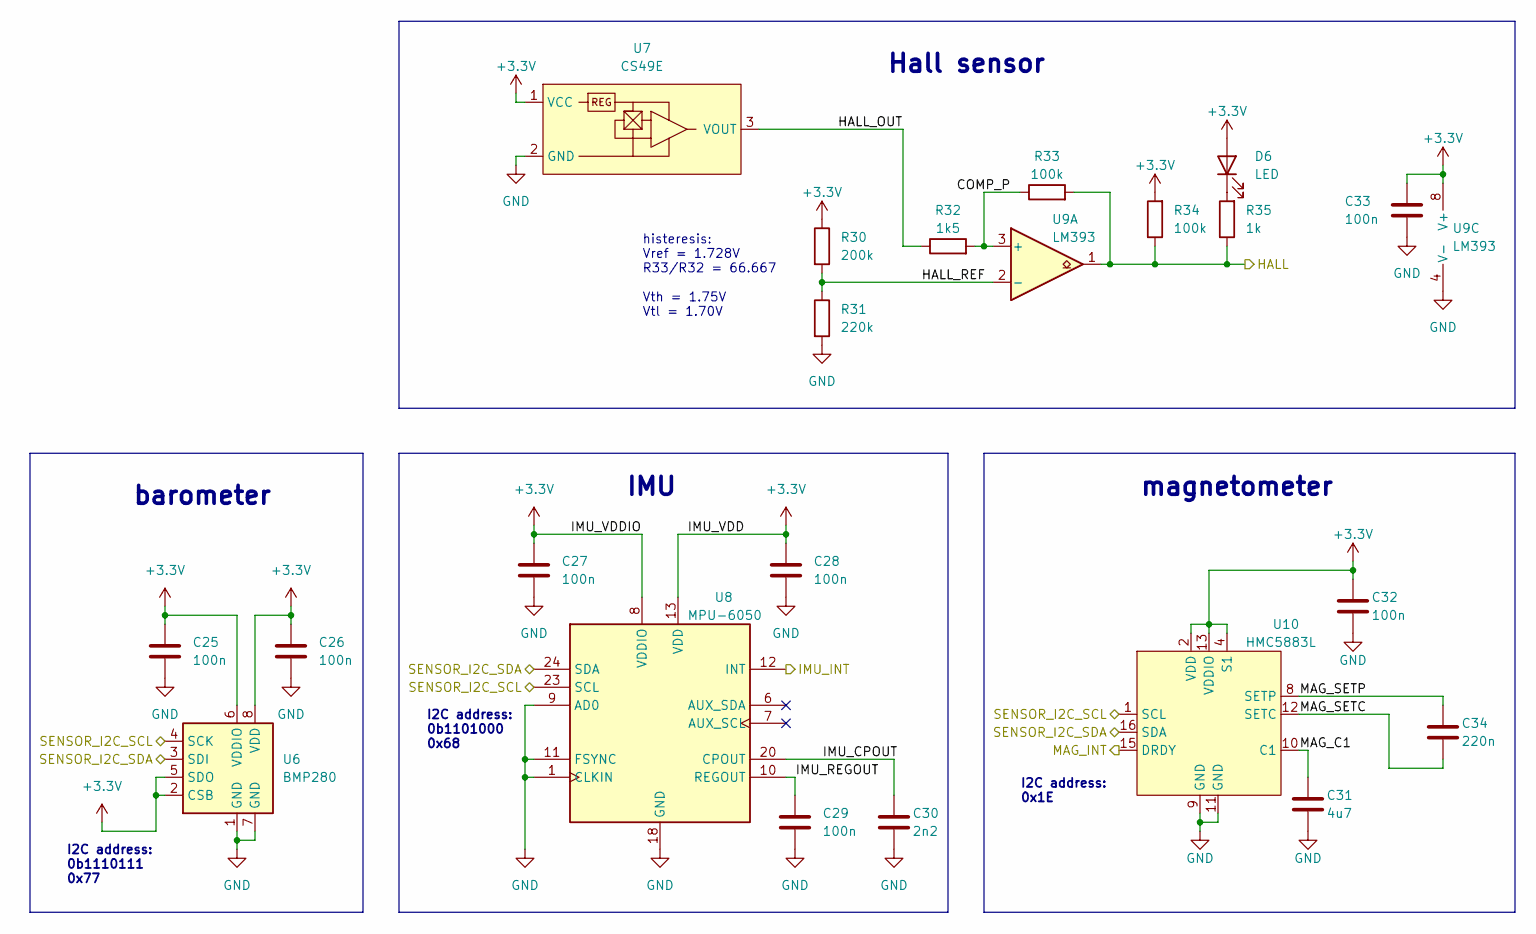
[picture p61: schematic sensors.kicad_sch, UAV TVC Goose Flight Controller]

Parts:
C25, C26, C27, C28, C29, C32, C33: 100n; C_0603_1608Metric
C30: 2n2; C_0603_1608Metric
C31: 4u7; C_0603_1608Metric
C34: 220n; C_0603_1608Metric
D6: LED; LED_0603_1608Metric
R30: 200k; R_0603_1608Metric
R31: 220k; R_0603_1608Metric
R32: 1k5; R_0603_1608Metric
R33, R34: 100k; R_0603_1608Metric
R35: 1k; R_0603_1608Metric
U6: BMP280; bmp280_hand_solder
U7: CS49E; tht_pin_01x03
U8: MPU-6050; mpu6050_hand_solder
U9: LM393; SOIC-8_3.9x4.9mm_P1.27mm
U10: HMC5883L; qmc5883l_hand_solder

Connections:
+3.3V: C25.1, C26.1, C27.1, C28.1, C32.1, C33.1, D6.2 (A), R30.1, R34.2, U6.2 (CSB), U6.5 (SDO), U6.6 (VDDIO), U6.8 (VDD), U7.1 (VCC), U8.8 (VDDIO), U8.13 (VDD), U9.8 (V+), U10.2 (VDD), U10.4 (S1), U10.13 (VDDIO); also elsewhere on the board
/power/SENSOR_I2C_SCL: U6.4 (SCK), U8.23 (SCL), U10.1 (SCL); also elsewhere on the board
/power/SENSOR_I2C_SDA: U6.3 (SDI), U8.24 (SDA), U10.16 (SDA); also elsewhere on the board
/sensors/COMP_P: R32.2, R33.1, U9.3 (+)
/sensors/HALL: R33.2, R34.1, R35.1, U9.1; also elsewhere on the board
/sensors/HALL_OUT: R32.1, U7.3 (VOUT)
/sensors/HALL_REF: R30.2, R31.1, U9.2 (-)
/sensors/IMU_CPOUT: C30.1, U8.20 (CPOUT)
/sensors/IMU_INT: U8.12 (INT); also elsewhere on the board
/sensors/IMU_REGOUT: C29.1, U8.10 (REGOUT)
/sensors/MAG_C1: C31.1, U10.10 (C1)
/sensors/MAG_INT: U10.15 (DRDY); also elsewhere on the board
/sensors/MAG_SETC: C34.2, U10.12 (SETC)
/sensors/MAG_SETP: C34.1, U10.8 (SETP)
GND: C25.2, C26.2, C27.2, C28.2, C29.2, C30.2, C31.2, C32.2, C33.2, R31.2, U6.1 (GND), U6.7 (GND), U7.2 (GND), U8.1 (CLKIN), U8.9 (AD0), U8.11 (FSYNC), U8.18 (GND), U9.4 (V-), U10.9 (GND), U10.11 (GND); also elsewhere on the board
unnamed: D6.1 (K), R35.2

Notes on the sheet:
I2C address: 0b1110111 0x77
magnetometer
histeresis: Vref = 1.728V R33/R32 = 66.667 Vth = 1.75V Vtl = 1.70V
I2C address: 0x1E
I2C address: 0b1101000 0x68
Hall sensor
barometer
IMU

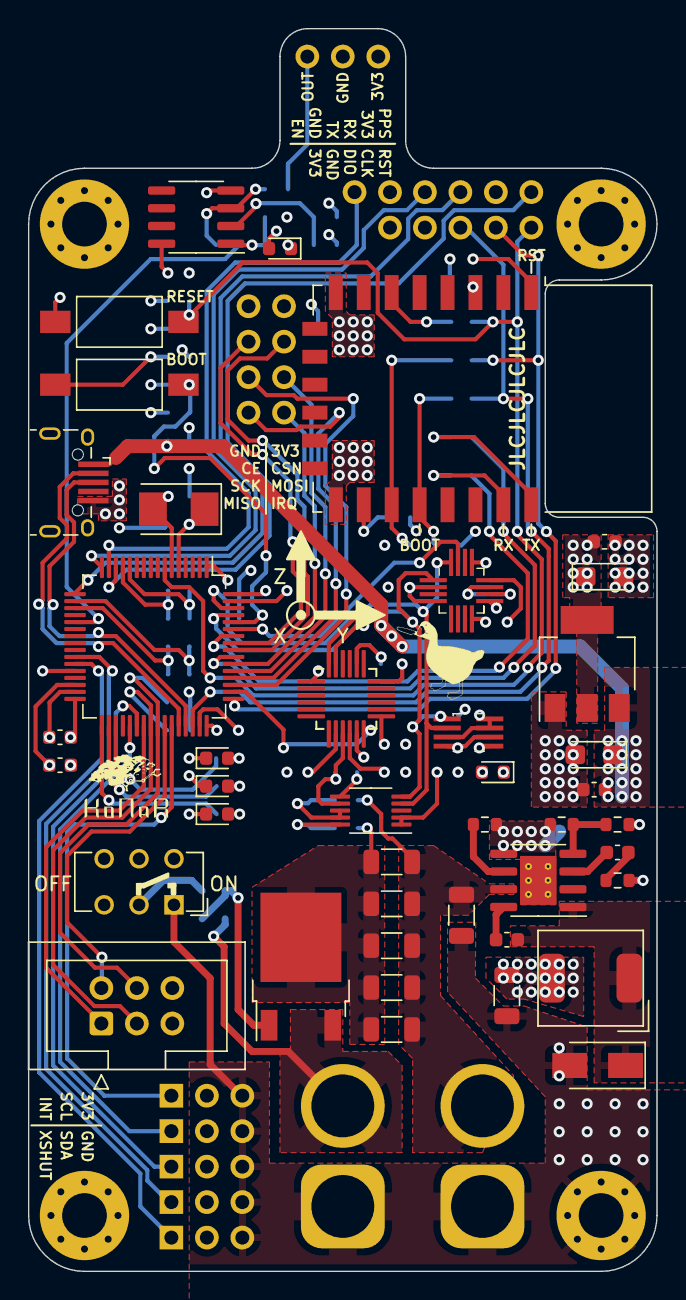
[picture p62: board flight-controller-v2.kicad_pcb from above]

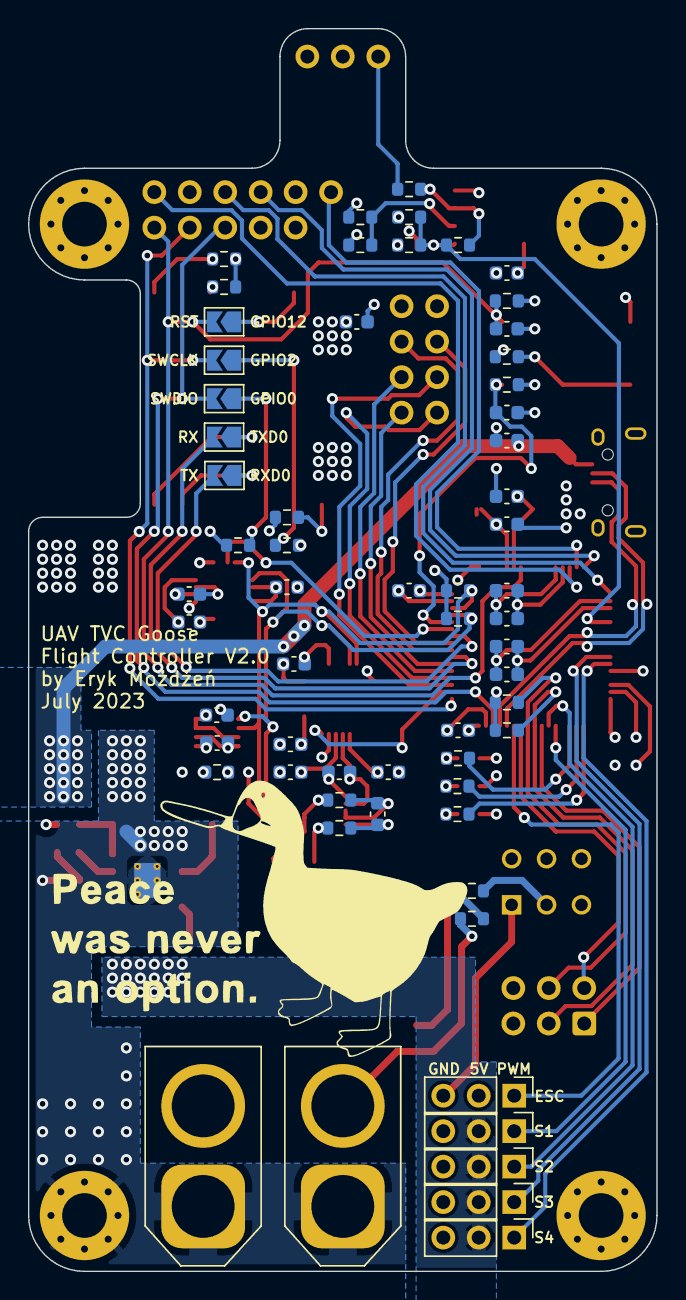
[picture p63: board flight-controller-v2.kicad_pcb from below]

Board: 4 copper layers, 45.0 x 89.0 mm, 112 parts (62 on the bottom side), 76 nets.
