Eryk-Mozdzen/uav-tvc-goose/electronics/wifi-receiver-transmitter/wifi-receiver-transmitter.kicad_pcb

## KiCad design electronics/wifi-receiver-transmitter/wifi-receiver-transmitter.kicad_pcb (2023-01-29, an earlier design)

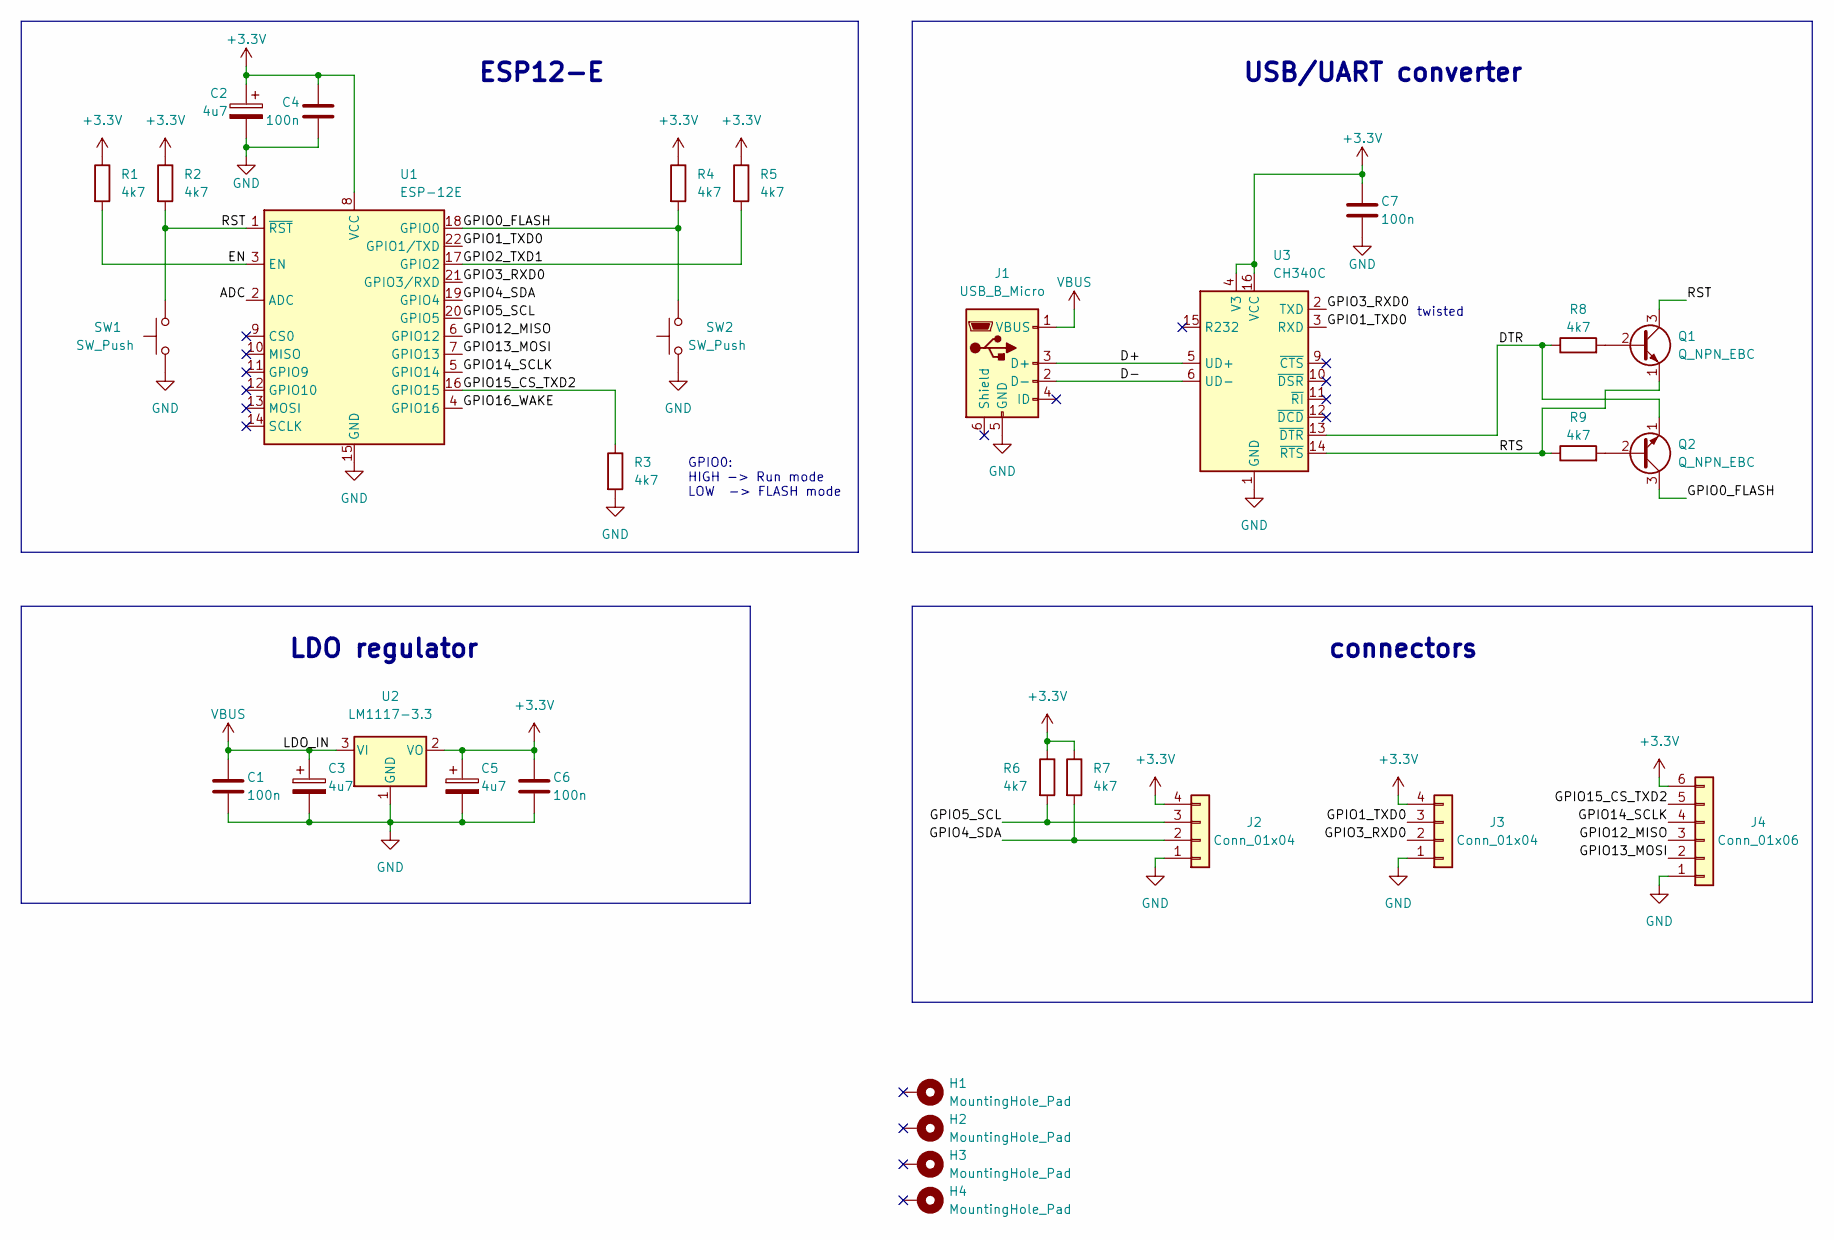
[picture p64: schematic wifi-receiver-transmitter.kicad_sch]

Parts:
C1, C4, C6, C7: 100n; C_0603_1608Metric
C2, C3, C5: 4u7; CP_EIA-3216-18_Kemet-A
H1, H2, H3, H4: MountingHole_Pad; MountingHole_3.2mm_M3_Pad_Via
J1: USB_B_Micro; usb_micro_B_druk_II
J2, J3: Conn_01x04; tht_pin_01x04
J4: Conn_01x06; tht_pin_01x06
Q1, Q2: Q_NPN_EBC; SOT-23
R1, R2, R3, R4, R5, R6, R7, R8, R9: 4k7; R_0603_1608Metric
SW1, SW2: SW_Push; SW_Push_SPST_NO_Alps_SKRK
U1: ESP-12E
U2: LM1117-3.3; SOT-223-3_TabPin2
U3: CH340C; SOIC-16_3.9x9.9mm_P1.27mm

Connections:
+3.3V: C2.1, C4.1, C5.1, C6.1, C7.1, J2.4, J3.4, J4.6, R1.1, R2.1, R4.1, R5.1, R6.1, R7.1, U1.8 (VCC), U2.2 (VO), U3.4 (V3), U3.16 (VCC)
/ADC: U1.2 (ADC)
/D+: J1.3 (D+), U3.5 (UD+)
/D-: J1.2 (D-), U3.6 (UD-)
/DTR: Q2.1 (E), R8.1, U3.13 (~DTR)
/EN: R1.2, U1.3 (EN)
/GPIO0_FLASH: Q2.3 (C), R4.2, SW2.2, U1.18 (GPIO0)
/GPIO1_TXD0: J3.3, U1.22 (GPIO1/TXD), U3.3 (RXD)
/GPIO2_TXD1: R5.2, U1.17 (GPIO2)
/GPIO3_RXD0: J3.2, U1.21 (GPIO3/RXD), U3.2 (TXD)
/GPIO4_SDA: J2.2, R7.2, U1.19 (GPIO4)
/GPIO5_SCL: J2.3, R6.2, U1.20 (GPIO5)
/GPIO12_MISO: J4.3, U1.6 (GPIO12)
/GPIO13_MOSI: J4.2, U1.7 (GPIO13)
/GPIO14_SCLK: J4.4, U1.5 (GPIO14)
/GPIO15_CS_TXD2: J4.5, R3.1, U1.16 (GPIO15)
/GPIO16_WAKE: U1.4 (GPIO16)
/RST: Q1.3 (C), R2.2, SW1.2, U1.1 (~RST)
/RTS: Q1.1 (E), R9.1, U3.14 (~RTS)
GND: C1.2, C2.2, C3.2, C4.2, C5.2, C6.2, C7.2, J1.5 (GND), J2.1, J3.1, J4.1, R3.2, SW1.1, SW2.1, U1.15 (GND), U2.1 (GND), U3.1 (GND)
unnamed: Q1.2 (B), R8.2
unnamed: Q2.2 (B), R9.2
VBUS: C1.1, C3.1, J1.1 (VBUS), U2.3 (VI)

Notes on the sheet:
ESP12-E
USB/UART converter
GPIO0: HIGH -> Run mode LOW -> FLASH mode
LDO regulator
twisted
connectors

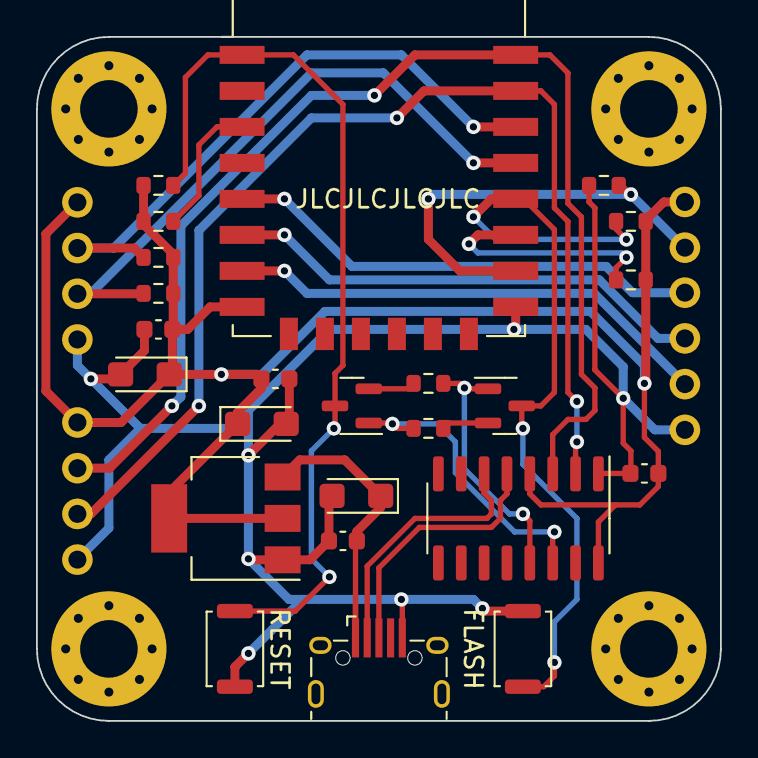
[picture p65: board wifi-receiver-transmitter.kicad_pcb from above]

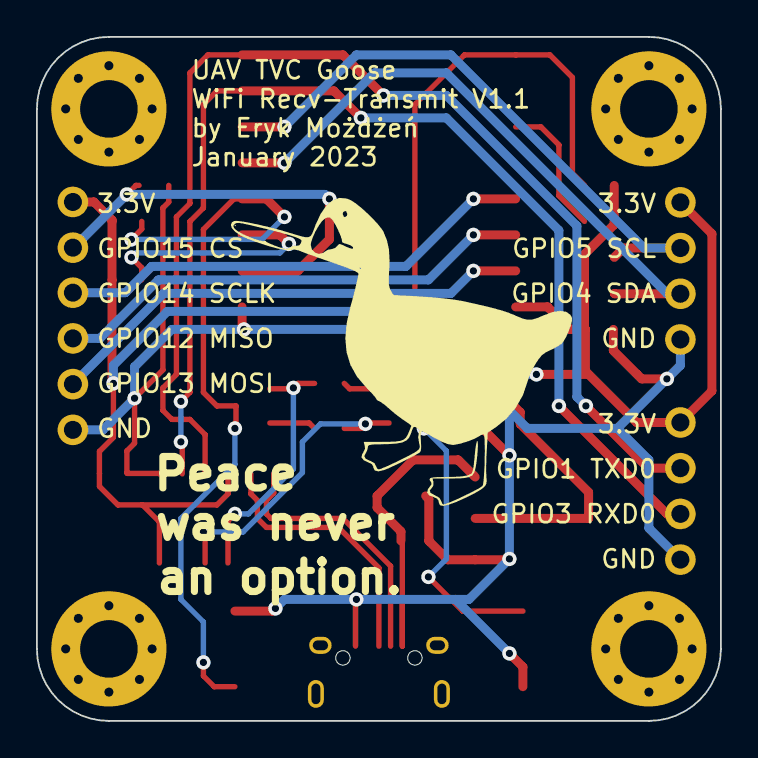
[picture p66: board wifi-receiver-transmitter.kicad_pcb from below]

Board: 2 copper layers, 38.0 x 38.0 mm, 31 parts (2 on the bottom side), 21 nets.
