Eryk-Mozdzen/uav-tvc-goose/electronics/flight-controller/flight-controller.kicad_pcb

## KiCad design electronics/flight-controller/flight-controller.kicad_pcb (2023-01-06, an earlier design)

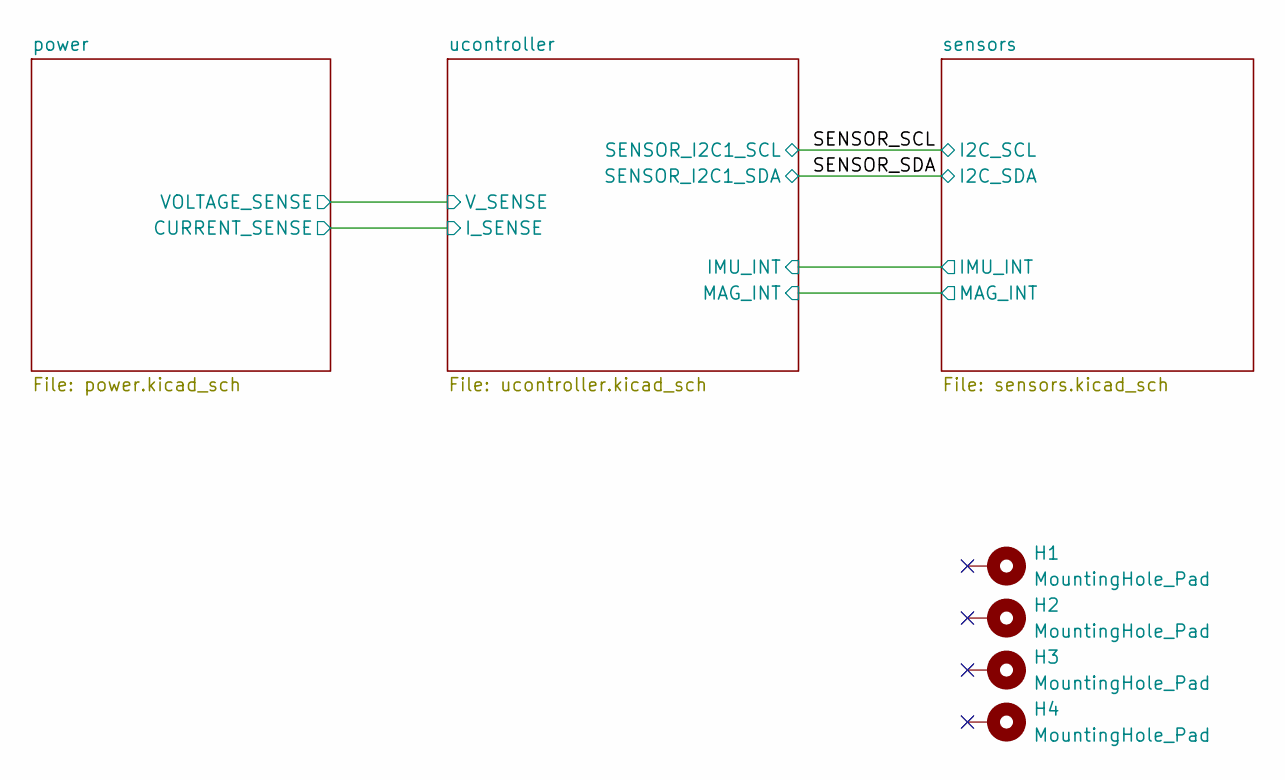
[picture p67: schematic flight-controller.kicad_sch]

Parts:
H1, H2, H3, H4: MountingHole_Pad; MountingHole_3.2mm_M3_Pad_Via
