Eryk-Mozdzen/uav-tvc-goose/electronics/flight-controller/flight-controller.kicad_pcb

## KiCad design electronics/flight-controller/flight-controller.kicad_pcb (continued)

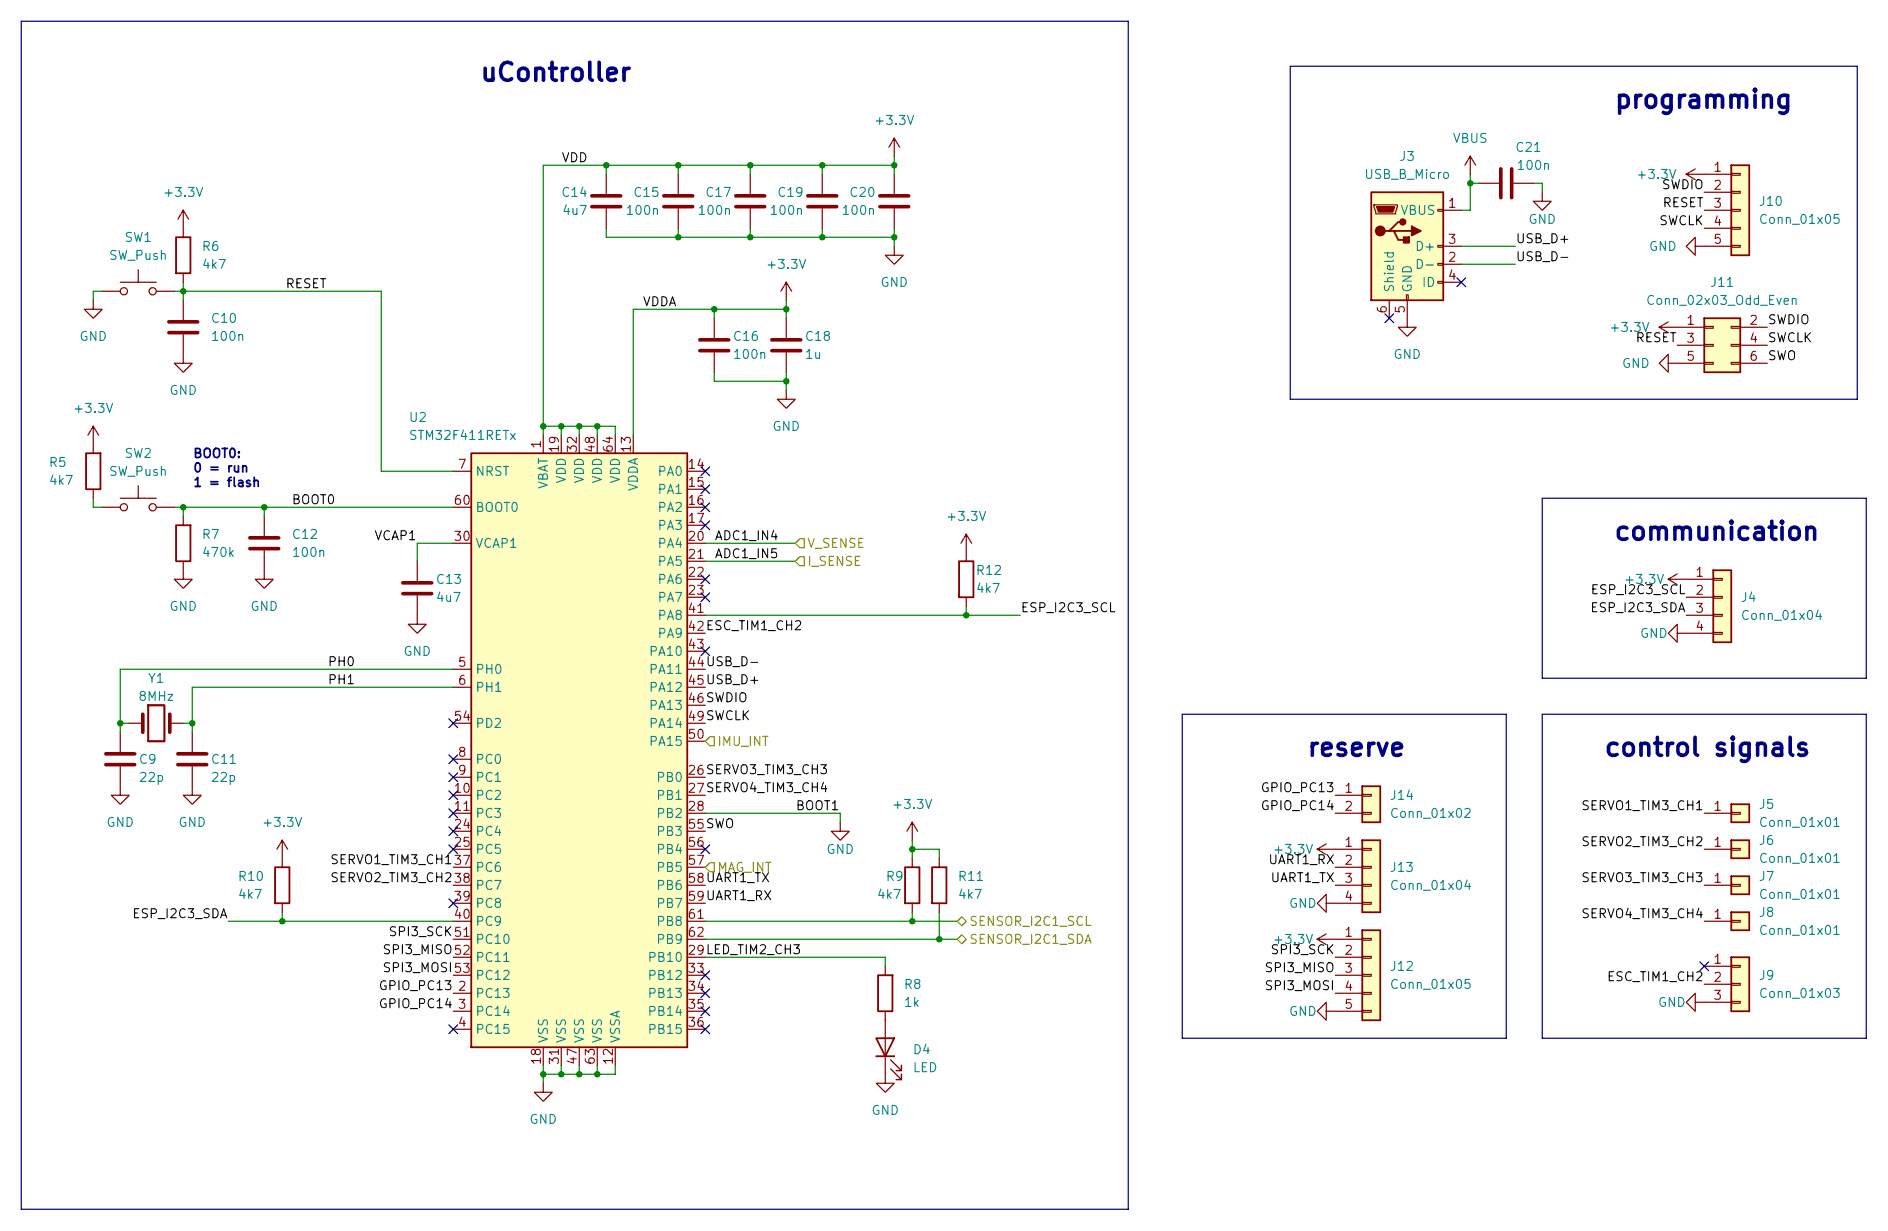
[picture p68: schematic ucontroller.kicad_sch]

Parts:
C9, C11: 22p; C_0603_1608Metric
C10, C12, C15, C16, C17, C19, C20, C21: 100n; C_0603_1608Metric
C13, C14: 4u7; C_0603_1608Metric
C18: 1u; C_0603_1608Metric
D4: LED; LED_0603_1608Metric
J3: USB_B_Micro; usb_micro_B_druk_II
J4, J13: Conn_01x04; tht_pin_01x04
J5, J6, J7, J8: Conn_01x01; tht_pin_01x01
J9: Conn_01x03; tht_pin_01x03
J10, J12: Conn_01x05; tht_pin_01x05
J11: Conn_02x03_Odd_Even; Tag-Connect_TC2030-IDC-NL_2x03_P1.27mm_Vertical
J14: Conn_01x02; tht_pin_01x02
R5, R6, R9, R10, R11, R12: 4k7; R_0603_1608Metric
R7: 470k; R_0603_1608Metric
R8: 1k; R_0603_1608Metric
SW1, SW2: SW_Push; SW_Push_1P1T_NO_CK_KMR2
U2: STM32F411RETx; LQFP-64_10x10mm_P0.5mm
Y1: 8MHz; Crystal_SMD_5032-2Pin_5.0x3.2mm

Connections:
+3.3V: C14.1, C15.1, C16.1, C17.1, C18.1, C19.1, C20.1, J4.1, J10.1, J11.1, J12.1, J13.1, R5.2, R6.1, R9.1, R10.1, R11.1, R12.1, U2.1 (VBAT), U2.13 (VDDA), U2.19 (VDD), U2.32 (VDD), U2.48 (VDD), U2.64 (VDD); also elsewhere on the board
/SENSOR_SCL: R9.2, U2.61 (PB8); also elsewhere on the board
/SENSOR_SDA: R11.2, U2.62 (PB9); also elsewhere on the board
/power/I_FILTER: U2.21 (PA5); also elsewhere on the board
/power/V_FILTER: U2.20 (PA4); also elsewhere on the board
/sensors/IMU_INT: U2.50 (PA15); also elsewhere on the board
/sensors/MAG_INT: U2.57 (PB5); also elsewhere on the board
/ucontroller/BOOT0: C12.1, R7.2, SW2.2, U2.60 (BOOT0)
/ucontroller/ESC_TIM1_CH2: J9.2, U2.42 (PA9)
/ucontroller/ESP_I2C3_SCL: J4.2, R12.2, U2.41 (PA8)
/ucontroller/ESP_I2C3_SDA: J4.3, R10.2, U2.40 (PC9)
/ucontroller/GPIO_PC13: J14.1, U2.2 (PC13)
/ucontroller/GPIO_PC14: J14.2, U2.3 (PC14)
/ucontroller/LED_TIM2_CH3: R8.2, U2.29 (PB10)
/ucontroller/PH0: C9.1, U2.5 (PH0), Y1.1
/ucontroller/PH1: C11.1, U2.6 (PH1), Y1.2
/ucontroller/RESET: C10.1, J10.3, J11.3, R6.2, SW1.2, U2.7 (NRST)
/ucontroller/SERVO1_TIM3_CH1: J5.1, U2.37 (PC6)
/ucontroller/SERVO2_TIM3_CH2: J6.1, U2.38 (PC7)
/ucontroller/SERVO3_TIM3_CH3: J7.1, U2.26 (PB0)
/ucontroller/SERVO4_TIM3_CH4: J8.1, U2.27 (PB1)
/ucontroller/SPI3_MISO: J12.3, U2.52 (PC11)
/ucontroller/SPI3_MOSI: J12.4, U2.53 (PC12)
/ucontroller/SPI3_SCK: J12.2, U2.51 (PC10)
/ucontroller/SWCLK: J10.4, J11.4, U2.49 (PA14)
/ucontroller/SWDIO: J10.2, J11.2, U2.46 (PA13)
/ucontroller/SWO: J11.6, U2.55 (PB3)
/ucontroller/UART1_RX: J13.2, U2.59 (PB7)
/ucontroller/UART1_TX: J13.3, U2.58 (PB6)
/ucontroller/USB_D+: J3.3 (D+), U2.45 (PA12)
/ucontroller/USB_D-: J3.2 (D-), U2.44 (PA11)
/ucontroller/VCAP1: C13.1, U2.30 (VCAP1)
GND: C9.2, C10.2, C11.2, C12.2, C13.2, C14.2, C15.2, C16.2, C17.2, C18.2, C19.2, C20.2, C21.2, D4.1 (K), J3.5 (GND), J4.4, J9.3, J10.5, J11.5, J12.5, J13.4, R7.1, SW1.1, U2.12 (VSSA), U2.18 (VSS), U2.28 (PB2), U2.31 (VSS), U2.47 (VSS), U2.63 (VSS); also elsewhere on the board
unnamed: D4.2 (A), R8.1
unnamed: R5.1, SW2.1
VBUS: C21.1, J3.1 (VBUS); also elsewhere on the board

Notes on the sheet:
BOOT0: 0 = run 1 = flash
programming
uController
reserve
communication
control signals

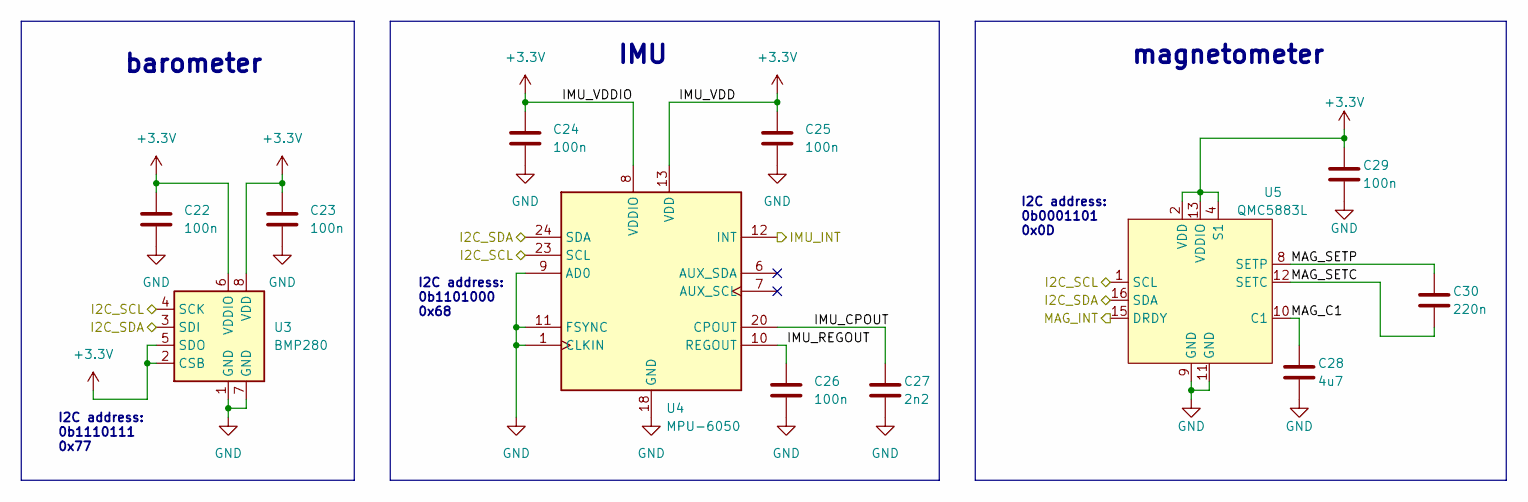
[picture p69: schematic sensors.kicad_sch]

Parts:
C22, C23, C24, C25, C26, C29: 100n; C_0603_1608Metric
C27: 2n2; C_0603_1608Metric
C28: 4u7; C_0603_1608Metric
C30: 220n; C_0603_1608Metric
U3: BMP280; bmp280_hand_solder
U4: MPU-6050; mpu6050_hand_solder
U5: QMC5883L; qmc5883l_hand_solder

Connections:
+3.3V: C22.1, C23.1, C24.1, C25.1, C29.1, U3.2 (CSB), U3.5 (SDO), U3.6 (VDDIO), U3.8 (VDD), U4.8 (VDDIO), U4.13 (VDD), U5.2 (VDD), U5.4 (S1), U5.13 (VDDIO); also elsewhere on the board
/SENSOR_SCL: U3.4 (SCK), U4.23 (SCL), U5.1 (SCL); also elsewhere on the board
/SENSOR_SDA: U3.3 (SDI), U4.24 (SDA), U5.16 (SDA); also elsewhere on the board
/sensors/IMU_CPOUT: C27.1, U4.20 (CPOUT)
/sensors/IMU_INT: U4.12 (INT); also elsewhere on the board
/sensors/IMU_REGOUT: C26.1, U4.10 (REGOUT)
/sensors/MAG_C1: C28.1, U5.10 (C1)
/sensors/MAG_INT: U5.15 (DRDY); also elsewhere on the board
/sensors/MAG_SETC: C30.2, U5.12 (SETC)
/sensors/MAG_SETP: C30.1, U5.8 (SETP)
GND: C22.2, C23.2, C24.2, C25.2, C26.2, C27.2, C28.2, C29.2, U3.1 (GND), U3.7 (GND), U4.1 (CLKIN), U4.9 (AD0), U4.11 (FSYNC), U4.18 (GND), U5.9 (GND), U5.11 (GND); also elsewhere on the board

Notes on the sheet:
IMU
I2C address: 0b1101000 0x68
I2C address: 0b0001101 0x0D
magnetometer
I2C address: 0b1110111 0x77
barometer

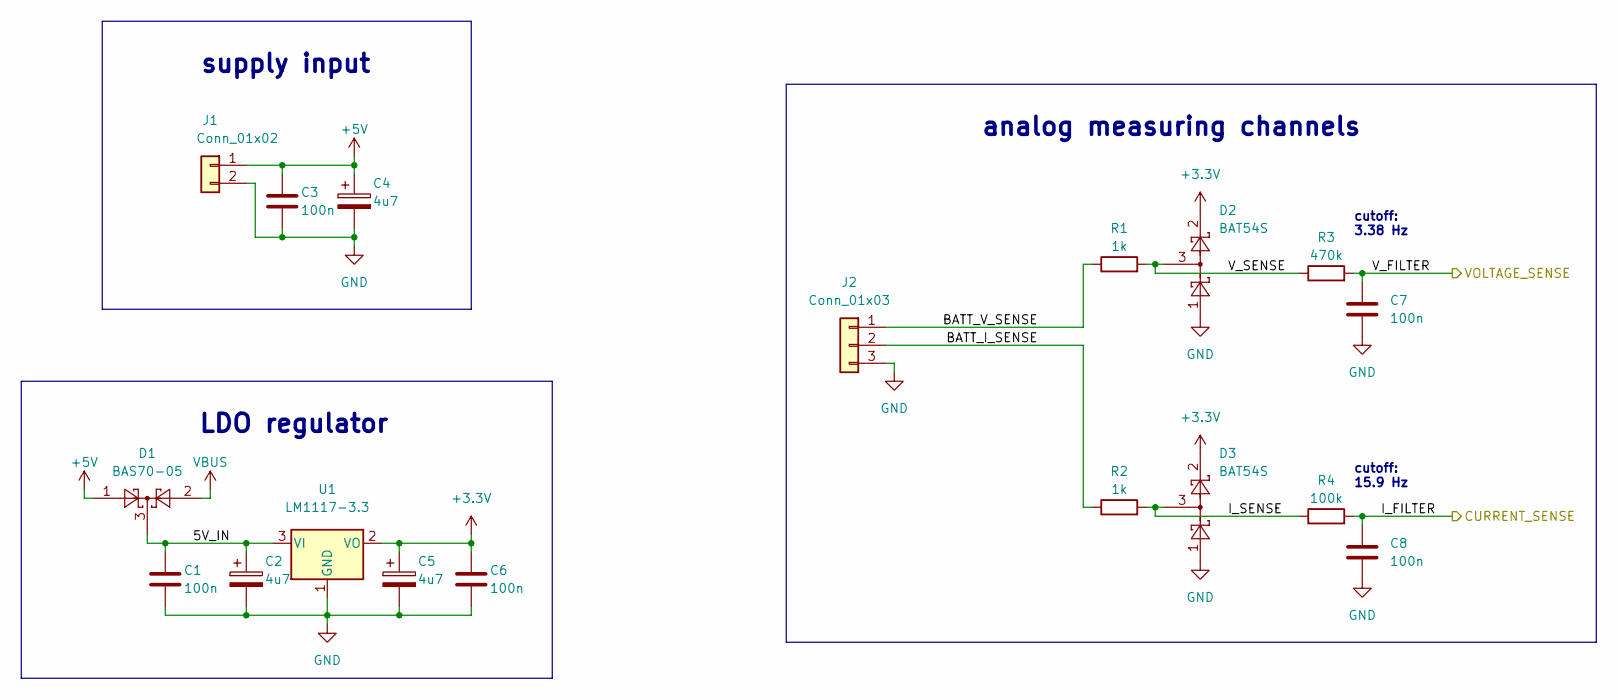
[picture p70: schematic power.kicad_sch]

Parts:
C1, C3, C6, C7, C8: 100n; C_0603_1608Metric
C2, C4, C5: 4u7; CP_EIA-3216-18_Kemet-A
D1: BAS70-05; SOT-23
D2, D3: BAT54S; SOT-23
J1: Conn_01x02; tht_pin_01x02
J2: Conn_01x03; tht_pin_01x03
R1, R2: 1k; R_0603_1608Metric
R3: 470k; R_0603_1608Metric
R4: 100k; R_0603_1608Metric
U1: LM1117-3.3; SOT-223-3_TabPin2

Connections:
+3.3V: C5.1, C6.1, D2.2, D3.2, U1.2 (VO); also elsewhere on the board
+5V: C3.1, C4.1, D1.1, J1.1
/power/5V_IN: C1.1, C2.1, D1.3, U1.3 (VI)
/power/BATT_I_SENSE: J2.2, R2.1
/power/BATT_V_SENSE: J2.1, R1.1
/power/I_FILTER: C8.1, R4.2; also elsewhere on the board
/power/I_SENSE: D3.3, R2.2, R4.1
/power/V_FILTER: C7.1, R3.2; also elsewhere on the board
/power/V_SENSE: D2.3, R1.2, R3.1
GND: C1.2, C2.2, C3.2, C4.2, C5.2, C6.2, C7.2, C8.2, D2.1, D3.1, J1.2, J2.3, U1.1 (GND); also elsewhere on the board
VBUS: D1.2; also elsewhere on the board

Notes on the sheet:
supply input
LDO regulator
cutoff: 3.38 Hz
cutoff: 15.9 Hz
analog measuring channels

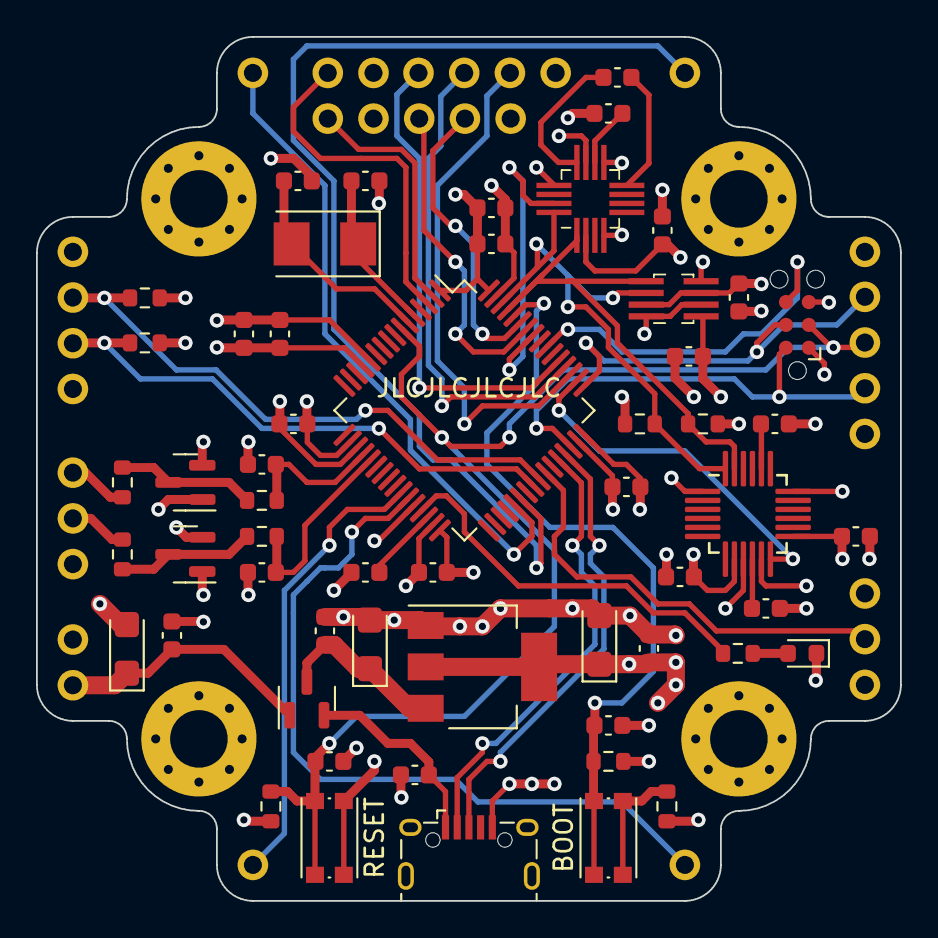
[picture p71: board flight-controller.kicad_pcb from above]

Board: 4 copper layers, 48.0 x 48.0 mm, 72 parts (0 on the bottom side), 47 nets.
