Eryk-Mozdzen/uav-tvc-goose/electronics/power-distribution-board/power-distribution-board.kicad_pcb

## KiCad design electronics/power-distribution-board/power-distribution-board.kicad_pcb (2023-01-06, an earlier design)

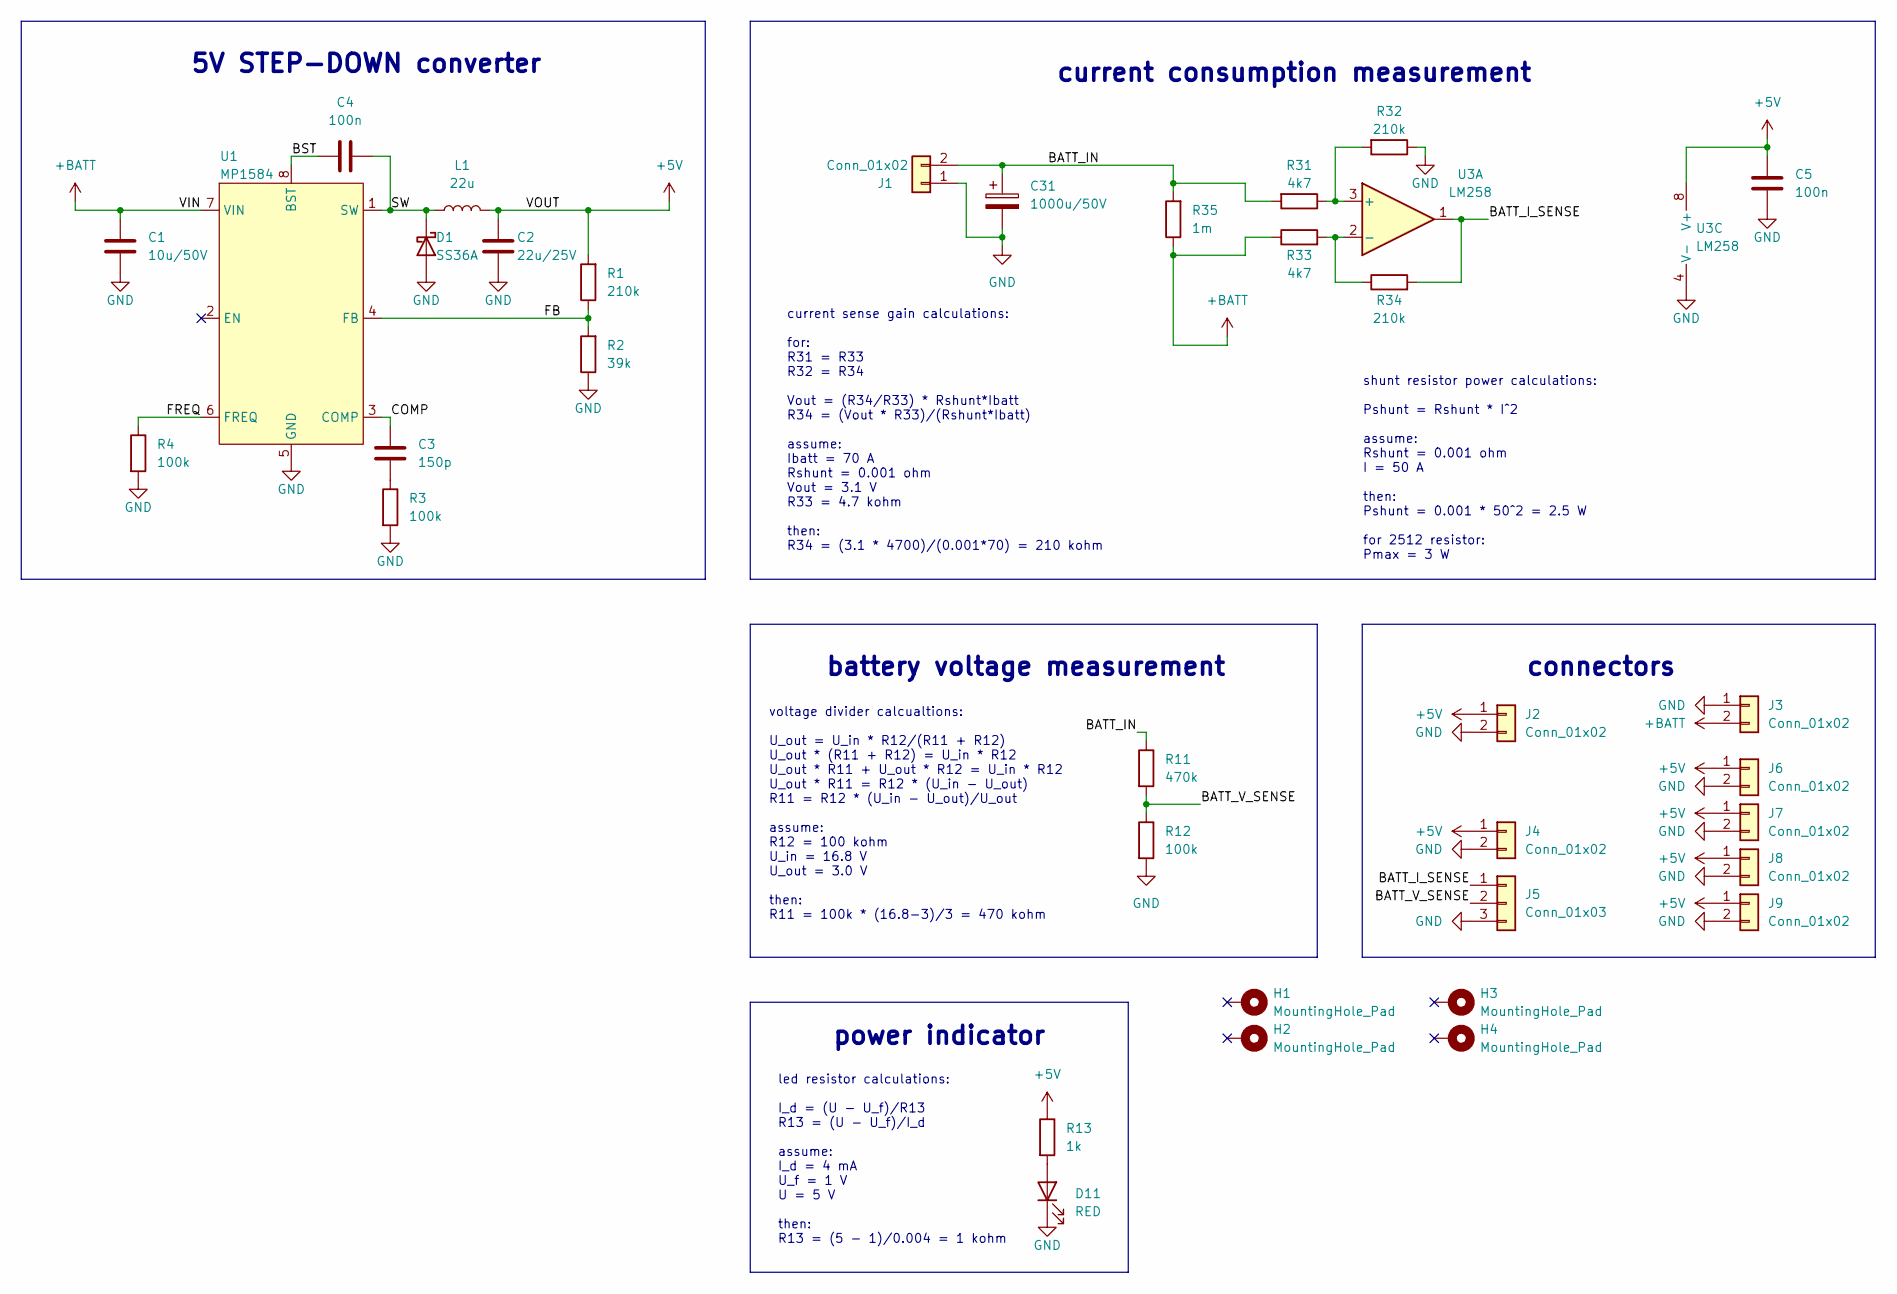
[picture p72: schematic power-distribution-board.kicad_sch]

Parts:
C1: 10u/50V; C_1206_3216Metric
C2: 22u/25V; C_1206_3216Metric
C3: 150p; C_0603_1608Metric
C4, C5: 100n; C_0603_1608Metric
C31: 1000u/50V
D1: SS36A; D_SMA
D11: RED; LED_0603_1608Metric
H1, H2, H3, H4: MountingHole_Pad; MountingHole_3.2mm_M3_Pad_Via
J1: Conn_01x02; AMASS_XT60-M_1x02_P7.20mm_Vertical
J2, J4, J6, J7, J8, J9: Conn_01x02; tht_pin_01x02
J3: Conn_01x02
J5: Conn_01x03; tht_pin_01x03
L1: 22u; L_12x12mm_H6mm
R1, R32, R34: 210k; R_0603_1608Metric
R2: 39k; R_0603_1608Metric
R3, R4, R12: 100k; R_0603_1608Metric
R11: 470k; R_0603_1608Metric
R13: 1k; R_0603_1608Metric
R31, R33: 4k7; R_0603_1608Metric
R35: 1m; R_2512_6332Metric
U1: MP1584; SOIC-8-1EP_3.9x4.9mm_P1.27mm_EP2.62x3.51mm_ThermalVias
U3: LM258; SOIC-8_3.9x4.9mm_P1.27mm

Connections:
+5V: C2.2, C5.2, J2.1, J4.1, J6.1, J7.1, J8.1, J9.1, L1.2, R1.2, R13.1, U3.8 (V+)
+BATT: C1.2, J3.2, R33.1, R35.1, U1.7 (VIN)
/BATT_IN: C31.1, J1.2, R11.1, R31.2, R35.2
/BATT_I_SENSE: J5.1, R34.2, U3.1
/BATT_V_SENSE: J5.2, R11.2, R12.1
/BST: C4.1, U1.8 (BST)
/COMP: C3.1, U1.3 (COMP)
/FB: R1.1, R2.2, U1.4 (FB)
/FREQ: R4.1, U1.6 (FREQ)
/SW: C4.2, D1.1 (K), L1.1, U1.1 (SW)
GND: C1.1, C2.1, C5.1, C31.2, D1.2 (A), D11.1 (K), J1.1, J2.2, J3.1, J4.2, J5.3, J6.2, J7.2, J8.2, J9.2, R2.1, R3.2, R4.2, R12.2, R32.1, U1.5 (GND), U3.4 (V-)
unnamed: C3.2, R3.1
unnamed: D11.2 (A), R13.2
unnamed: R31.1, R32.2, U3.3 (+)
unnamed: R33.2, R34.1, U3.2 (-)

Notes on the sheet:
5V STEP-DOWN converter
power indicator
current consumption measurement
led resistor calculations: I_d = (U - U_f)/R13 R13 = (U - U_f)/I_d assume: I_d = 4 mA U_f = 1 V U = 5 V then: R13 = (5 - 1)/0.004 = 1 kohm
current sense gain calculations: for: R31 = R33 R32 = R34 Vout = (R34/R33) * Rshunt*Ibatt R34 = (Vout * R33)/(Rshunt*Ibatt) assume: Ibatt = 70 A Rshunt = 0.001 ohm Vout = 3.1 V R33 = 4.7 kohm then: R34 = (3.1 * 4700)/(0.001*70) = 210 kohm
shunt resistor power calculations: Pshunt = Rshunt * I^2 assume: Rshunt = 0.001 ohm I = 50 A then: Pshunt = 0.001 * 50^2 = 2.5 W for 2512 resistor: Pmax = 3 W
connectors
voltage divider calcualtions: U_out = U_in * R12/(R11 + R12) U_out * (R11 + R12) = U_in * R12 U_out * R11 + U_out * R12 = U_in * R12 U_out * R11 = R12 * (U_in - U_out) R11 = R12 * (U_in - U_out)/U_out assume: R12 = 100 kohm U_in = 16.8 V U_out = 3.0 V then: R11 = 100k * (16.8-3)/3 = 470 kohm
battery voltage measurement

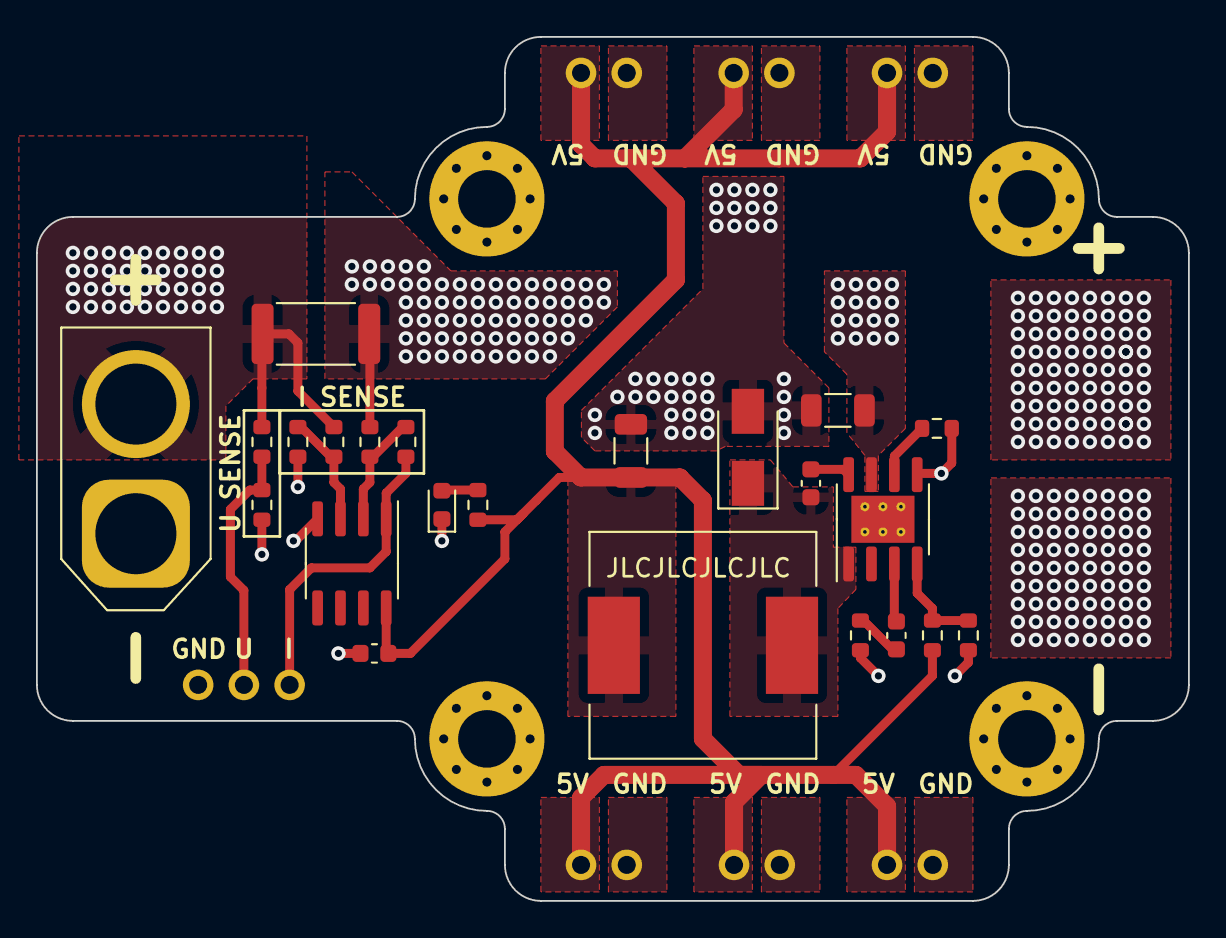
[picture p73: board power-distribution-board.kicad_pcb from above]

Board: 2 copper layers, 64.0 x 48.0 mm, 34 parts (0 on the bottom side), 15 nets.
