Eryk-Mozdzen/uav-tvc-goose/software/goose-fc/src/hardware/actuators.cpp

#include "actuators.h"
#include <cmath>

void HAL_TIM_MspPostInit(TIM_HandleTypeDef* htim) {
	GPIO_InitTypeDef GPIO_InitStruct;

	if(htim->Instance==TIM1) {
		__HAL_RCC_GPIOA_CLK_ENABLE();

		GPIO_InitStruct.Pin = GPIO_PIN_10;
		GPIO_InitStruct.Mode = GPIO_MODE_AF_PP;
		GPIO_InitStruct.Pull = GPIO_NOPULL;
		GPIO_InitStruct.Speed = GPIO_SPEED_FREQ_LOW;
		GPIO_InitStruct.Alternate = GPIO_AF1_TIM1;
		HAL_GPIO_Init(GPIOA, &GPIO_InitStruct);
	} else if(htim->Instance==TIM3) {
		__HAL_RCC_GPIOB_CLK_ENABLE();
		__HAL_RCC_GPIOC_CLK_ENABLE();

		GPIO_InitStruct.Pin = GPIO_PIN_0|GPIO_PIN_1;
		GPIO_InitStruct.Mode = GPIO_MODE_AF_PP;
		GPIO_InitStruct.Pull = GPIO_NOPULL;
		GPIO_InitStruct.Speed = GPIO_SPEED_FREQ_LOW;
		GPIO_InitStruct.Alternate = GPIO_AF2_TIM3;
		HAL_GPIO_Init(GPIOB, &GPIO_InitStruct);

		GPIO_InitStruct.Pin = GPIO_PIN_6|GPIO_PIN_7;
		GPIO_InitStruct.Mode = GPIO_MODE_AF_PP;
		GPIO_InitStruct.Pull = GPIO_NOPULL;
		GPIO_InitStruct.Speed = GPIO_SPEED_FREQ_LOW;
		GPIO_InitStruct.Alternate = GPIO_AF2_TIM3;
		HAL_GPIO_Init(GPIOC, &GPIO_InitStruct);
	}
}

Actuators::Actuators() : throttle_ramp{0.333, 100} {

}

void Actuators::init() {
    __HAL_RCC_GPIOA_CLK_ENABLE();
    __HAL_RCC_GPIOB_CLK_ENABLE();
    __HAL_RCC_GPIOC_CLK_ENABLE();

	htim3_servo.Instance = TIM3;
	htim3_servo.Init.Period = arr - 1;
	htim3_servo.Init.Prescaler = psc - 1;
	htim3_servo.Init.ClockDivision = TIM_CLOCKDIVISION_DIV1;
	htim3_servo.Init.CounterMode = TIM_COUNTERMODE_UP;

    HAL_TIM_PWM_Init(&htim3_servo);

    TIM_OC_InitTypeDef sConfigOC;
    sConfigOC.OCMode = TIM_OCMODE_PWM1;
    sConfigOC.Pulse = 0;
    sConfigOC.OCPolarity = TIM_OCPOLARITY_HIGH;
    sConfigOC.OCFastMode = TIM_OCFAST_DISABLE;
    HAL_TIM_PWM_ConfigChannel(&htim3_servo, &sConfigOC, TIM_CHANNEL_1);
    HAL_TIM_PWM_ConfigChannel(&htim3_servo, &sConfigOC, TIM_CHANNEL_2);
    HAL_TIM_PWM_ConfigChannel(&htim3_servo, &sConfigOC, TIM_CHANNEL_3);
    HAL_TIM_PWM_ConfigChannel(&htim3_servo, &sConfigOC, TIM_CHANNEL_4);

    HAL_TIM_MspPostInit(&htim3_servo);

    HAL_TIM_PWM_Start(&htim3_servo, TIM_CHANNEL_1);
    HAL_TIM_PWM_Start(&htim3_servo, TIM_CHANNEL_2);
    HAL_TIM_PWM_Start(&htim3_servo, TIM_CHANNEL_3);
    HAL_TIM_PWM_Start(&htim3_servo, TIM_CHANNEL_4);

	htim1_esc.Instance = TIM1;
	htim1_esc.Init.Period = arr - 1;
	htim1_esc.Init.Prescaler = psc - 1;
	htim1_esc.Init.ClockDivision = TIM_CLOCKDIVISION_DIV1;
	htim1_esc.Init.CounterMode = TIM_COUNTERMODE_UP;

    HAL_TIM_PWM_Init(&htim1_esc);
    HAL_TIM_PWM_ConfigChannel(&htim1_esc, &sConfigOC, TIM_CHANNEL_3);
    HAL_TIM_MspPostInit(&htim1_esc);
    HAL_TIM_PWM_Start(&htim1_esc, TIM_CHANNEL_3);
}

void Actuators::setFinCompare(const Fin fin, const uint32_t compare) {
	__HAL_TIM_SET_COMPARE(&htim3_servo, servos[fin].channel, compare);
}

void Actuators::setFinAngle(const Fin fin, float alpha) {
	alpha = alpha>Servo::max ? Servo::max : alpha<-Servo::max ? -Servo::max : alpha;

	float compare = 0;

	if(alpha>0) {
		compare = interpolate(alpha, 0.f, 0.5f*pi, servos[fin].compare_center, servos[fin].compare_upper);
	} else {
		compare = interpolate(alpha, -0.5f*pi, 0.f, servos[fin].compare_lower, servos[fin].compare_center);
	}

    __HAL_TIM_SET_COMPARE(&htim3_servo, servos[fin].channel, static_cast<uint32_t>(compare));
}

void Actuators::setMotorThrottle(float throttle, const Mode mode) {
    throttle = throttle>1 ? 1 : throttle<0 ? 0 : throttle;

	throttle_ramp.setTarget(throttle);

	switch(mode) {
		case Mode::PASSTHROUGH: {

		} break;
		case Mode::RAMP: {
			throttle = throttle_ramp.getOutput();
		} break;
	}

	const uint16_t compare = ESC::min_compare + (ESC::max_compare - ESC::min_compare)*throttle;

    __HAL_TIM_SET_COMPARE(&htim1_esc, TIM_CHANNEL_3, arr - compare);
}

float Actuators::getFinAngle(const Fin fin) const {
    const float compare = __HAL_TIM_GET_COMPARE(&htim3_servo, servos[fin].channel);

	float angle = 0;

	if(compare>servos[fin].compare_center) {
		angle = interpolate(compare, servos[fin].compare_center, servos[fin].compare_upper, 0.f, 0.5f*pi);
	} else {
		angle = interpolate(compare, servos[fin].compare_lower, servos[fin].compare_center, -0.5f*pi, 0.f);
	}

    return angle;
}

float Actuators::getMotorThrottle() const {
    const uint16_t compare = arr - __HAL_TIM_GET_COMPARE(&htim1_esc, TIM_CHANNEL_3);

    return (((float)compare) - ((float)ESC::min_compare))/(((float)ESC::max_compare) - ((float)ESC::min_compare));
}

Actuators & Actuators::getInstance() {
    static Actuators instance;

    return instance;
}
