Eryk-Mozdzen/uav-tvc-goose/software/goose-fc/HAL/hal_exceptions.c

void NMI_Handler() {

	while(1);
}

void HardFault_Handler() {

	while(1);
}

void MemManage_Handler() {

	while(1);
}

void BusFault_Handler() {

	while(1);
}

void UsageFault_Handler() {

	while(1);
}
