Eryk-Mozdzen/uav-tvc-goose/software/sandbox/transfer-test/src/main.cpp

#include "transfer.h"
#include <cstdio>
#include <cstring>
#include <cassert>

void print(uint8_t place, uint8_t *buffer, uint8_t size) {

	for(int i=0; i<place; i++) {
		printf("   ");
	}

	for(int i=0; i<size; i++) {
		printf("%02X ", buffer[i]);
	}
	printf("\n");
}

template<typename T>
void test(T data) {
	uint8_t raw[255];
	memcpy(raw, &data, sizeof(T));
	print(5, raw, sizeof(T));

	Transfer::FrameTX tx = Transfer::encode(data, Transfer::TELEMETRY_ESTIMATION_ALTITUDE);

	print(0, tx.buffer, tx.length);

	assert(tx.buffer[0]==0);
	for(size_t i=1; i<tx.length; i++) {
		assert(tx.buffer[i]!=0);
	}

	Transfer transfer;

	for(size_t i=0; i<tx.length; i++) {
		transfer.consume(tx.buffer[i]);

		Transfer::FrameRX rx;

		if(transfer.receive(rx)) {

			T recv;
			assert(rx.getPayload(recv));

			uint8_t decoded[255];
			memcpy(decoded, &recv, sizeof(T));
			print(5, decoded, sizeof(T));

			for(size_t i=0; i<sizeof(T); i++) {
				assert(decoded[i]==raw[i]);
			}
		}
	}
}

void test(const void *data, size_t size) {
	uint8_t raw[255];
	memcpy(raw, data, size);
	print(5, raw, size);

	Transfer::FrameTX tx = Transfer::encode(data, size, Transfer::LOG_INFO);

	print(0, tx.buffer, tx.length);

	assert(tx.buffer[0]==0);
	for(size_t i=1; i<tx.length; i++) {
		assert(tx.buffer[i]!=0);
	}

	Transfer transfer;

	for(size_t i=0; i<tx.length; i++) {
		transfer.consume(tx.buffer[i]);

		Transfer::FrameRX rx;

		if(transfer.receive(rx)) {

			uint8_t decoded[255];
			memcpy(decoded, rx.payload, rx.length);
			print(5, decoded, rx.length);

			for(size_t i=0; i<rx.length; i++) {
				assert(decoded[i]==raw[i]);
			}
		}
	}
}

int main() {

	test(1000.f);
	test(0.f);
	test(-3.456f);

	test(1000.);
	test(0.);
	test(-3.456);

	test((uint8_t)123);
	test((uint8_t)0);
	test((uint8_t)255);
	test((uint8_t)-34);
	test((uint8_t)1000);

	test((uint16_t)123);
	test((int16_t)123);

	struct __attribute__((packed)) Vector3f {
		float x, y, z;
	};
	struct __attribute__((packed)) Vector3i {
		int16_t x, y, z;
	};
	struct __attribute__((packed)) SensorReading {
		Vector3f calibrated;
		Vector3i raw;
	};

	test(SensorReading{0, 12.2435, 21231.5, -123, 1023, 800});
	test(SensorReading{0, 0, 0, 0, 0, 0});
	test(SensorReading{45, -12.2435, 0.545645645, -123, -1023, -800});

	const char *str1 = "Hello world";
	const char *str2 = "witajcie w mojej kuchni";
	const char *str3 = "qwertyuiopasdfghjklzxcvbnm\n1234567890ja,DBS m ";

	test(str1, strlen(str1));
	test(str2, strlen(str2));
	test(str3, strlen(str3));
}
