Eryk-Mozdzen/uav-tvc-goose/(commit log)

2022-12-04 almost ready schematic for flight controller
    [communication.kicad_sch, core.kicad_sch, flight-controller.kicad_pcb, flight-controller.kicad_sch, power.kicad_sch]
2022-12-07 separate electronics projects
    [communication.kicad_sch, core.kicad_sch, flight-controller.kicad_pcb, flight-controller.kicad_sch, power-distribution-board.kicad_pcb, power-distribution-board.kicad_sch, power.kicad_sch, wifi-receiver-transmitter.kicad_pcb]
2023-01-29 update esp module
    [wifi-receiver-transmitter.kicad_pcb, wifi-receiver-transmitter.kicad_sch]
2023-02-09 add USB CDC device
2023-02-09 IMU and two axes of MAG works
2023-02-10 barometer and magnetometer works
    [flight-controller.kicad_sch, sensors.kicad_sch]
2023-02-11 sensors in separate tasks
2023-02-15 sensor queue
2023-02-16 sensors on interrupts
2023-02-18 better code for imu
2023-02-20 mag range immune calibration
2023-02-21 implementation of kalman filter
2023-02-21 fix matrix initalizer list
    [matrix.h]
2023-02-21 extended kalman filter and axes fix
    [rotation-cube.py]
2023-02-22 remove earth magnetic declination
2023-02-26 use of FreeRTOS wrapper, fix axes, state esimation at 100Hz
    [bmp280.cpp, hmc5883l.cpp, main.cpp, matrix.h, mpu6050.cpp, mpu6050.h, rotation-cube.py, sensor_bus.cpp]
2023-03-02 bidirectional slot mechanism and C++ object in QML file
2023-03-06 add system inputs telemetry and motor throttle
2023-03-13 add visualization schematics
2023-03-28 Added reading and printing data to vizualization
2023-03-30 creation of wire and wireless com tasks
2023-03-31 add UART on DMA
2023-04-06 read write in separate threads
2023-04-07 shorter names, telnet class
    [main.cpp, telnet.cpp, telnet.h, usb.cpp, usb.h]
2023-04-11 frameless window, custom buttons, drag&drop, resize
2023-04-11 task bar buttons color
2023-04-12 add window frame back, remove settings popout
2023-04-13 added actuators
2023-04-13 added throttle
2023-04-16 battery and fill
2023-04-16 add voltage and current
2023-04-16 semaprate high, medium, low battery colors
2023-04-17 add prefix to battery level
2023-04-17 remove battery prefix
2023-04-18 reverse order of byts in usb work xd
    [control.cpp, wire_receiver.cpp]
2023-05-05 VLX work on interrupt
2023-05-09 Added scene without measurements
    [rocket.obj]
2023-05-20 power stats task
2023-05-20 ADC over DMA and scaling
2023-05-20 move sensor telemetry from estimator to sensors
2023-05-20 add interval telemetry to interrupt driven sensors
2023-05-20 add const interval also to power and pressure
2023-05-21 start of altitude and battery estimators
2023-05-21 increase timer queue length
2023-05-22 battery display real data
2023-05-23 add calibration values for accelerometer
2023-05-23 batter calibration values
2023-05-24 automatic source switch between barometer and TOF
2023-05-24 increase observation covariance of barometer, add switch messages
2023-05-27 added actuators read usb
2023-05-30 fix frames
2023-06-03 big rework of transfer, add goose-station
    [bmp280.cpp, control.cpp, events.cpp, events.h]
2023-06-03 add logs, fix serial
    [escape_codes.h, usb.cpp, window.cpp]
2023-06-03 add power stats
2023-06-04 estimator and controller data frames, queue for state
2023-06-04 add state negator and current state tracking
2023-06-04 resetting events in takeoff/landing states
    [control.cpp, events.cpp, events.h, states.cpp, states.h]
2023-06-06 add actuators
2023-06-06 automatic landing
2023-06-06 increase take off vertical velocity
2023-06-06 add wireless data to app
2023-06-06 correct PWM for ESC
    [actuators.cpp, actuators.h]
2023-06-17 update pressure derivative
2023-06-17 send ground pressure estimation
2023-06-17 remove debug acc printing
2023-06-17 show pressure and distance readings
2023-06-21 switch to OpenStreetMap
2023-06-28 perform prop test
2023-07-09 start of new FC
    [flight-controller-v2.kicad_pcb, flight-controller-v2.kicad_sch, power.kicad_sch, sensors.kicad_sch, ucontroller.kicad_sch]
2023-07-12 develop Hall velocity sense circuit
    [flight-controller-v2.kicad_sch, sensors.kicad_sch, ucontroller.kicad_sch]
2023-07-12 FC scheme complete
    [flight-controller-v2.kicad_pcb, flight-controller-v2.kicad_sch, power.kicad_sch, sensors.kicad_sch, ucontroller.kicad_sch]
2023-07-12 first board cutout and layout
    [flight-controller-v2.kicad_pcb, flight-controller-v2.kicad_sch, sensors.kicad_sch, ucontroller.kicad_sch]
2023-07-13 add 3d models to custom footprints
    [flight-controller-v2.kicad_pcb]
2023-07-13 update silkscreen and add tag for order number
    [flight-controller-v2.kicad_pcb]
2023-07-13 start of Power Link Interface
    [power-link-interface-v2.kicad_pcb, power-link-interface-v2.kicad_sch]
2023-07-18 PLI work
    [power-link-interface-v2.kicad_pcb, power-link-interface-v2.kicad_sch]
2023-07-18 edge XT60 connector & INA226 I2C measurement
    [flight-controller-v2.kicad_pcb, flight-controller-v2.kicad_sch, power-link-interface-v2.kicad_pcb, power-link-interface-v2.kicad_sch, power.kicad_sch, sensors.kicad_sch, ucontroller.kicad_sch]
2023-07-18 move XT60 to center of the edge
    [power-link-interface-v2.kicad_pcb, power-link-interface-v2.kicad_sch]
2023-07-19 move PLI to FC
    [flight-controller-v2.kicad_pcb, flight-controller-v2.kicad_sch, power-link-interface-v2.kicad_pcb, power-link-interface-v2.kicad_sch, power.kicad_sch, sensors.kicad_sch, ucontroller.kicad_sch]
2023-07-20 movemounting hole by 0.1mm
    [flight-controller-v2.kicad_pcb]
2023-07-20 fix route names
    [flight-controller-v2.kicad_pcb, flight-controller-v2.kicad_sch, power.kicad_sch, sensors.kicad_sch, ucontroller.kicad_sch]
2023-07-21 script for thrust params
2023-07-22 data strored in CSV file
    [thrust_data.csv]
2023-07-23 rotor torque coefficent
    [rotor_thrust_data.csv, rotor_torque_data.csv]
2023-07-26 add read model to simulation
    [body.stl, fin.stl, rotor.stl]
2023-07-26 fix gitignore and find more fitting resistor
    [flight-controller-v2.kicad_sch, power.kicad_sch]
2023-07-27 add hall to program scheme
2023-07-27 route new FC
    [flight-controller-v2.kicad_pcb, flight-controller-v2.kicad_sch, power.kicad_sch, sensors.kicad_sch, ucontroller.kicad_sch]
2023-07-27 change folder name
    [flight-controller-v2.kicad_pcb, flight-controller-v2.kicad_sch, power.kicad_sch, sensors.kicad_sch, ucontroller.kicad_sch]
2023-07-29 fixes in routing
    [flight-controller-v2.kicad_pcb, flight-controller-v2.kicad_sch, power.kicad_sch, sensors.kicad_sch, ucontroller.kicad_sch]
2023-07-29 more fixes
    [flight-controller-v2.kicad_pcb]
2023-07-30 fix segfault on exit when telnet is used
    [telnet.cpp, telnet.h, window.cpp]
2023-07-31 add on/off text near switch
    [flight-controller-v2.kicad_pcb]
2023-07-31 generate schematic
    [flight-controller-v2.kicad_sch, power.kicad_sch, sensors.kicad_sch, ucontroller.kicad_sch]
2023-08-02 update parameters, improve performance, fix model in visualization
    [body.stl, fin.stl, rotor.stl]
2023-08-03 fix route name, remove ADC code
    [flight-controller-v2.kicad_pcb, flight-controller-v2.kicad_sch, ucontroller.kicad_sch]
2023-08-03 update XSHUT and INT pin to new location
2023-08-03 update ESC PWM channel to new one
2023-08-03 move ESP UART1 RX from PB7 to PB3
2023-08-03 update MAG INT pin from PB5 to PB7
2023-08-03 implementation fro INA226 power monitor IC
2023-08-03 implmentation of Hall efect sensor based motor velocity reader
2023-08-03 display motor velocity in station app
2023-08-04 update IMU and MAG axes
2023-08-04 automatic removing 3 sigma samples
2023-08-05 reset integral before every flight
    [controller.cpp, controller.h, states.cpp]
2023-08-06 commands generated from gamepad buttons
2023-08-16 move runtime stats to timer 5
2023-08-17 fix IMU axes
2023-08-18 reduce power monitor pooling to 20Hz
2023-08-18 calibration of acc and mag
2023-08-18 fix Vref in Hall comeprator, update schematic, add moving average to vel
    [flight-controller-v2.kicad_sch, sensors.kicad_sch]
2023-08-18 fix velocity calculation
2023-08-19 remove unused VLX I2C interrupts
2023-08-21 add ramp to throttle
2023-08-23 fix steering and default ip address
    [window.cpp]
2023-08-27 tests of 8 thrust vanes
2023-09-11 add charts for actuators
2023-09-23 add vel chart, switch to vel control in Z
2023-09-23 remove yaw from station
2023-09-23 add motor vel chart, chart resume from gamepad, return to real model parameters
2023-09-26 remove VLX, add simple code for ultrasonic
2023-10-07 fix linear acc, static pause/resume of livechart, better model and regulator parameters
    [controller.h, hcsr04.cpp, mpu6050.cpp]
2023-10-30 3 value calibration
2023-11-01 200Hz integral calculation, comm struct interface
2023-11-01 vertical velocity chart, remove old saples
2023-11-01 fix matrix writing to header file
    [controller.py]
2023-11-10 fix yaw telemetry sending
    [control.cpp, window.cpp]
2023-12-16 correct thrust measurements NEED TEST
    [rotor_thrust_data.csv]
